gralco/dvk-mx8m-bsb/calculations/final/feedline_adjustment_description.png

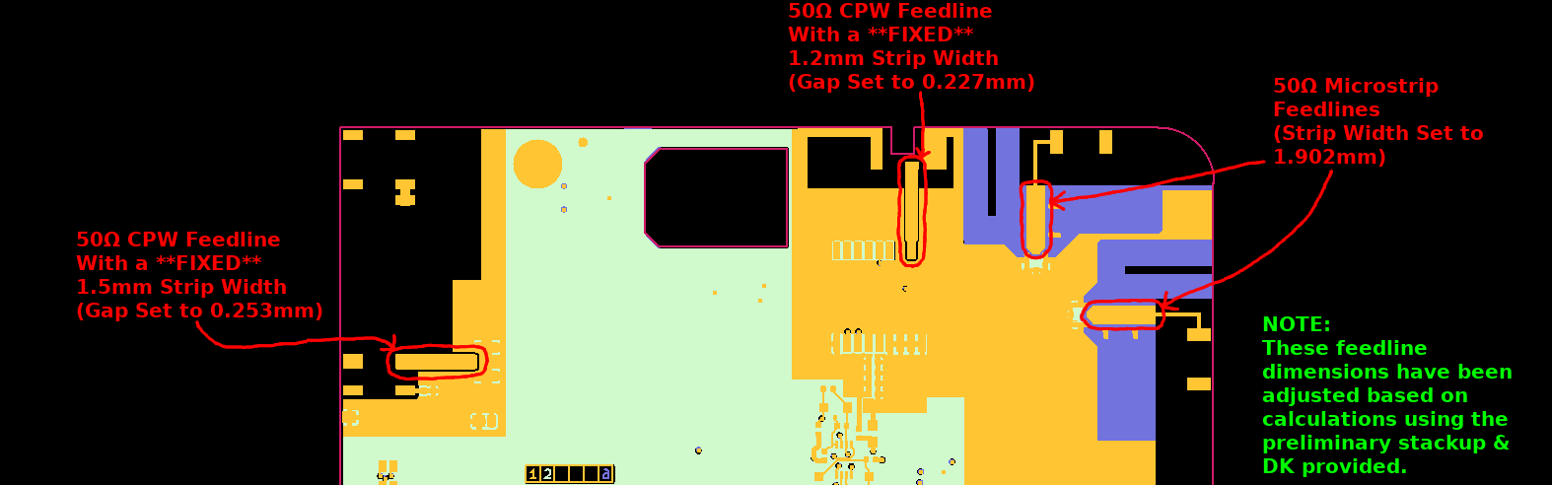
calculations/final/feedline_adjustment_description.png
