gralco/dvk-mx8m-bsb/calculations/final/final_stackup.png

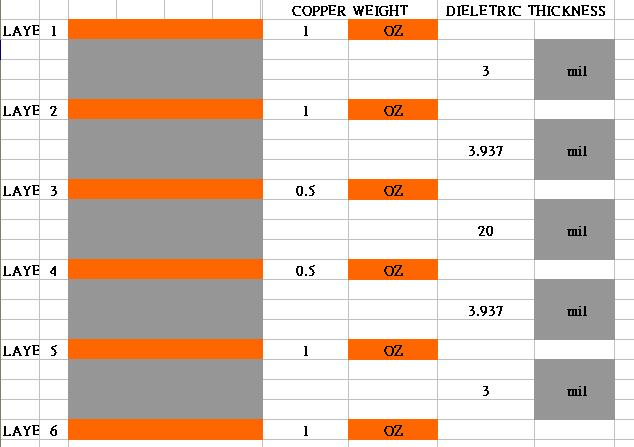
calculations/final/final_stackup.png
