gralco/dvk-mx8m-bsb/calculations/final/gnss_feed_beta_layout_polar_cpw.png

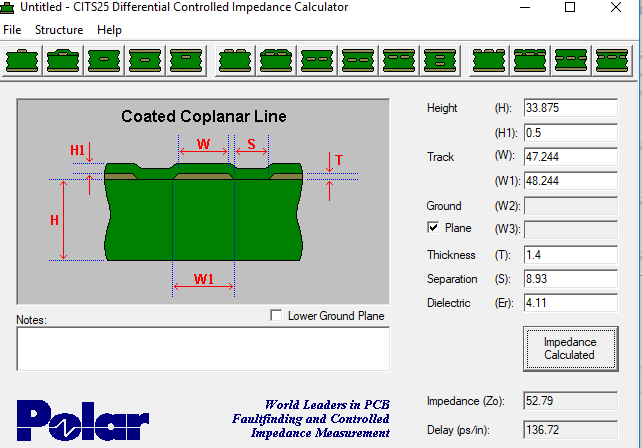
calculations/final/gnss_feed_beta_layout_polar_cpw.png
