gralco/dvk-mx8m-bsb/calculations/final/gnss_feed_janielectronics_cpw.png

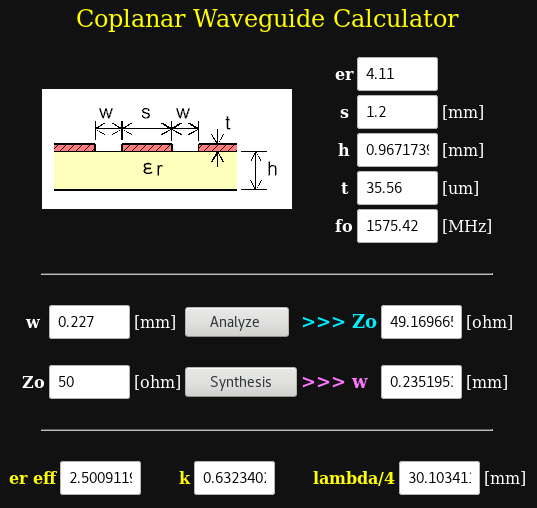
calculations/final/gnss_feed_janielectronics_cpw.png
