gralco/dvk-mx8m-bsb/calculations/final/speaker_trace_width.png

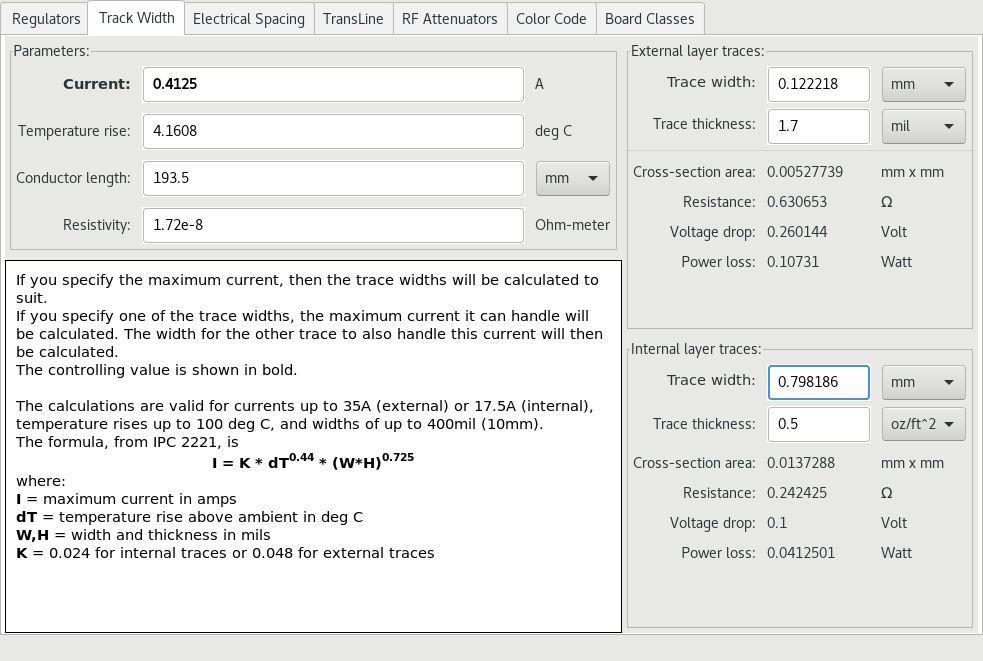
calculations/final/speaker_trace_width.png
