gralco/dvk-mx8m-bsb/calculations/final/wifi_bt_feed_kicad_microstrip.png

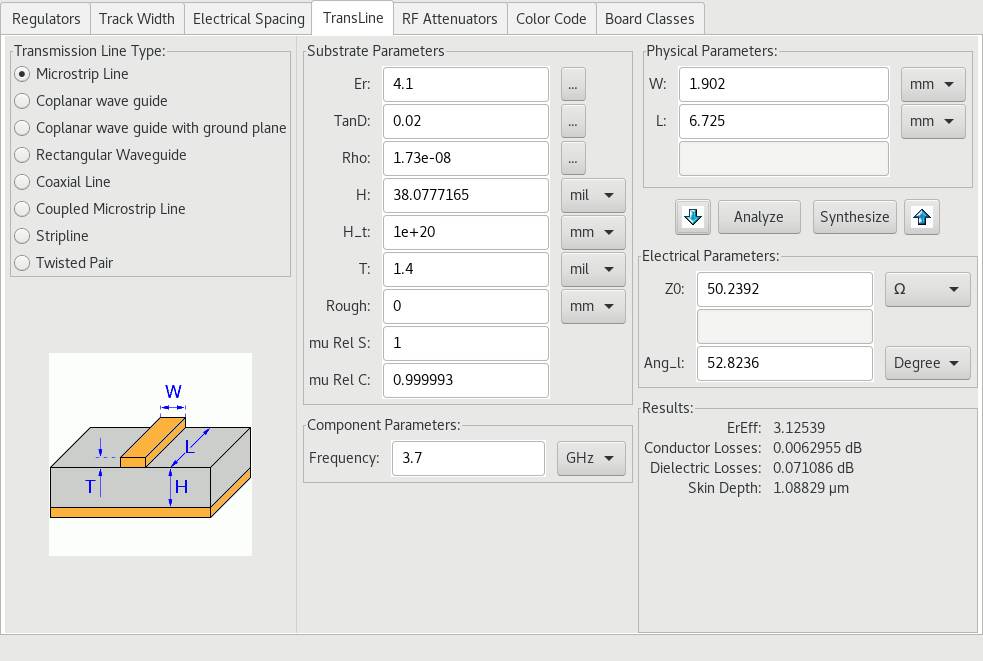
calculations/final/wifi_bt_feed_kicad_microstrip.png
