gralco/dvk-mx8m-bsb/calculations/final/wwan_feed_beta_layout_polar_cpw.png

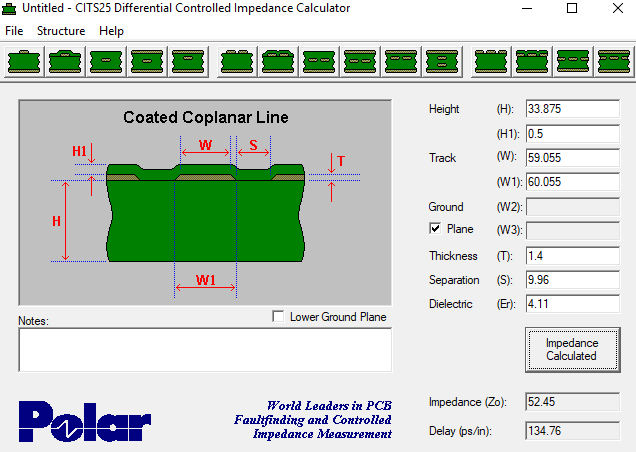
calculations/final/wwan_feed_beta_layout_polar_cpw.png
