gralco/dvk-mx8m-bsb/calculations/prototype/gnss_feed_janielectronics_cpw.png

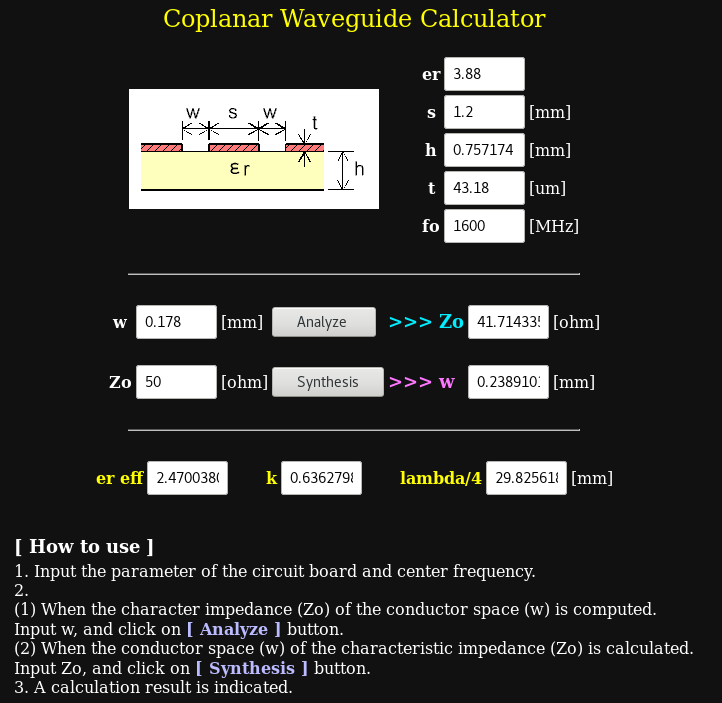
calculations/prototype/gnss_feed_janielectronics_cpw.png
