gralco/dvk-mx8m-bsb/calculations/prototype/wifi_bt_feed_janielectronics_microstrip.png

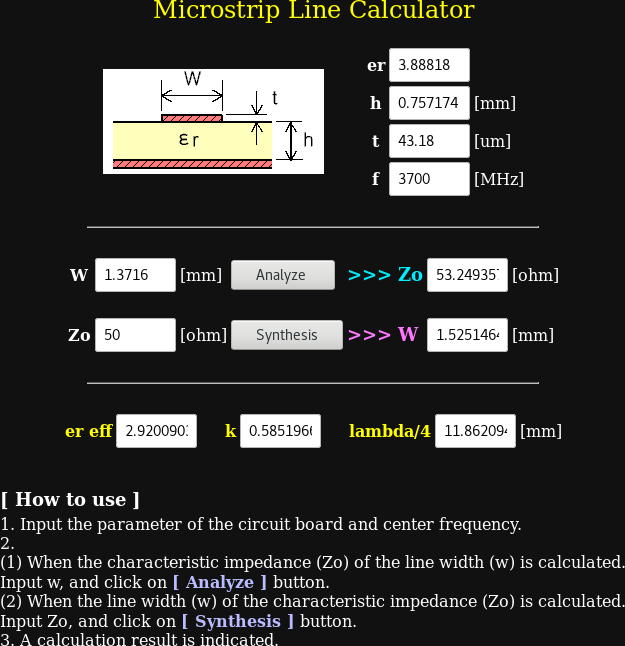
calculations/prototype/wifi_bt_feed_janielectronics_microstrip.png
