gralco/dvk-mx8m-bsb/BoM/dvk-mx8m-bsb_bom.csv

Reference | Value | Footprint | Datasheet | MFG Name | MFG Part Num | Distrib PN | Distrib Link | Tolerance | Others
AE2301 | ACM4-5036-A1-CC-S | dvk-mx8m-bsb:ACM4-5036-A1-CC-S | https://cloud.puri.sm/s/Xi64aJqKKKscxsZ | INPAQ | ACM4-5036-A1-CC-S | ACM4-5036-A1-CC-S | https://www.endrich.com/antennen_nfc_wpc/acm4_5036_a1_cc_s | - | https://www.everythingrf.com/products/gps-gnss-antennas/inpaq-technology-co-ltd/666-329-acm4-5036-a1-cc-s
AE1501 | SR4L034-R | dvk-mx8m-bsb:SR4L034-R | http://www.antenova-m2m.com/wp-content/uploads/2018/04/Inversa-SR4L034-PS-1.0.pdf | Antenova | SR4L034-R | SR4L034-R | https://www.arrow.com/en/products/sr4l034-r/antenova | - | https://octopart.com/search?q=SR4L034-R&start=0
AE1801 | FR05-S1-NO-1-004 | dvk-mx8m-bsb:FR05-S1-NO-1-004 | https://www.fractusantennas.com/files/UM_FR05_S1_NO_1_004.pdf
AE1802 | FR05-S1-NO-1-004 | dvk-mx8m-bsb:FR05-S1-NO-1-004 | https://www.fractusantennas.com/files/UM_FR05_S1_NO_1_004.pdf
BT301 | 18650 | dvk-mx8m-bsb:BH18650 | https://www.tme.eu/en/Document/8fa81c4c5d128169ded6af3ed3867ae3/BHC-18650-1P.pdf | COMF | BHC-18650-1P | BHC-18650-1P | https://www.tme.eu/en/details/bhc-18650-1p/batteries-holders/comf/ | - | http://www.sierraic.com/BHC186501P
C103 | 100nF | Capacitors_SMD:C_0402
C104 | 100nF | Capacitors_SMD:C_0402
C108 | 100nF | Capacitors_SMD:C_0402
C107 | 100nF | Capacitors_SMD:C_0402
C205 | 100nF | Capacitors_SMD:C_0402
C206 | 100nF | Capacitors_SMD:C_0402
C208 | 100nF | Capacitors_SMD:C_0402
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
C1808 | 1uF | Capacitors_SMD:C_0402
C1801 | 1uF | Capacitors_SMD:C_0402
C1820 | 1uF | Capacitors_SMD:C_0402
C1901 | 1uF | Capacitors_SMD:C_0402
C1902 | 1uF | Capacitors_SMD:C_0402
C2001 | 1uF | Capacitors_SMD:C_0402
C2202 | 1uF | Capacitors_SMD:C_0402
C2204 | 1uF | Capacitors_SMD:C_0402
C2203 | 1uF | Capacitors_SMD:C_0402
C2402 | 1uF | Capacitors_SMD:C_0402
C202 | 2.2uF | Capacitors_SMD:C_0402
C204 | 2.2uF | Capacitors_SMD:C_0402
C1718 | 2.2uF | Capacitors_SMD:C_0402
C2002 | 2.2uF | Capacitors_SMD:C_0402
C1711 | 220nF | Capacitors_SMD:C_0402
C1714 | 220nF | Capacitors_SMD:C_0402
C1716 | 220nF | Capacitors_SMD:C_0402
C1717 | 220nF | Capacitors_SMD:C_0402
C1706 | 220nF | Capacitors_SMD:C_0402
C1705 | 220nF | Capacitors_SMD:C_0402
C1707 | 220nF | Capacitors_SMD:C_0402
C1719 | 220nF | Capacitors_SMD:C_0402
C1720 | 220nF | Capacitors_SMD:C_0402
C1721 | 220nF | Capacitors_SMD:C_0402
C1616 | 220pF | Capacitors_SMD:C_0402
C1617 | 220pF | Capacitors_SMD:C_0402
C455 | 220uF | Capacitors_Tantalum_SMD:CP_Tantalum_Case-D_EIA-7343-31_Reflow | http://datasheets.avx.com/TPS.pdf | AVX | TPSD227K010R0100 | TPSD227K010R0100 | https://www.tme.eu/en/details/tpsd227k010r010/smd-tantalum-capacitors/avx/tpsd227k010r0100/ | 10% | https://www.arrow.com/en/products/293d227x9010d2te3/vishay
C454 | 220uF | Capacitors_Tantalum_SMD:CP_Tantalum_Case-D_EIA-7343-31_Reflow | http://datasheets.avx.com/TPS.pdf | AVX | TPSD227K010R0100 | TPSD227K010R0100 | https://www.tme.eu/en/details/tpsd227k010r010/smd-tantalum-capacitors/avx/tpsd227k010r0100/ | 10% | https://www.arrow.com/en/products/293d227x9010d2te3/vishay
C1505 | 220uF | Capacitors_Tantalum_SMD:CP_Tantalum_Case-D_EIA-7343-31_Reflow | http://datasheets.avx.com/TPS.pdf | AVX | TPSD227K010R0100 | TPSD227K010R0100 | https://www.tme.eu/en/details/tpsd227k010r010/smd-tantalum-capacitors/avx/tpsd227k010r0100/ | 10% | https://www.arrow.com/en/products/293d227x9010d2te3/vishay
C1503 | 220uF | Capacitors_Tantalum_SMD:CP_Tantalum_Case-D_EIA-7343-31_Reflow | http://datasheets.avx.com/TPS.pdf | AVX | TPSD227K010R0100 | TPSD227K010R0100 | https://www.tme.eu/en/details/tpsd227k010r010/smd-tantalum-capacitors/avx/tpsd227k010r0100/ | 10% | https://www.arrow.com/en/products/293d227x9010d2te3/vishay
C1502 | 220uF | Capacitors_Tantalum_SMD:CP_Tantalum_Case-D_EIA-7343-31_Reflow | http://datasheets.avx.com/TPS.pdf | AVX | TPSD227K010R0100 | TPSD227K010R0100 | https://www.tme.eu/en/details/tpsd227k010r010/smd-tantalum-capacitors/avx/tpsd227k010r0100/ | 10% | https://www.arrow.com/en/products/293d227x9010d2te3/vishay
C1609 | 220uF | Capacitors_Tantalum_SMD:CP_Tantalum_Case-S_EIA-3216-12_Reflow | http://datasheets.avx.com/TLN_Undertab.pdf | AVX | TLNS227M004R3000 | 478-5526-1-ND | https://www.digikey.com/product-detail/en/avx-corporation/TLNS227M004R3000/478-5526-1-ND/2048317 | 20% | https://www.digikey.com/products/en/capacitors/tantalum-capacitors/59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
C1610 | 220uF | Capacitors_Tantalum_SMD:CP_Tantalum_Case-S_EIA-3216-12_Reflow | http://datasheets.avx.com/TLN_Undertab.pdf | AVX | TLNS227M004R3000 | 478-5526-1-ND | https://www.digikey.com/product-detail/en/avx-corporation/TLNS227M004R3000/478-5526-1-ND/2048317 | 20% | https://www.digikey.com/products/en/capacitors/tantalum-capacitors/59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
C1821 | 220uF | Capacitors_Tantalum_SMD:CP_Tantalum_Case-D_EIA-7343-31_Reflow | http://datasheets.avx.com/TPS.pdf | AVX | TPSD227K010R0100 | TPSD227K010R0100 | https://www.tme.eu/en/details/tpsd227k010r010/smd-tantalum-capacitors/avx/tpsd227k010r0100/ | 10% | https://www.arrow.com/en/products/293d227x9010d2te3/vishay
C1822 | 220uF | Capacitors_Tantalum_SMD:CP_Tantalum_Case-D_EIA-7343-31_Reflow | http://datasheets.avx.com/TPS.pdf | AVX | TPSD227K010R0100 | TPSD227K010R0100 | https://www.tme.eu/en/details/tpsd227k010r010/smd-tantalum-capacitors/avx/tpsd227k010r0100/ | 10% | https://www.arrow.com/en/products/293d227x9010d2te3/vishay
C1701 | 27pF | Capacitors_SMD:C_0402
C1702 | 27pF | Capacitors_SMD:C_0402
C1522 | 22pF | Capacitors_SMD:C_0402
C101 | 22uF | Capacitors_SMD:C_0603 | http://www.samsungsem.com/kr/support/product-search/mlcc/__icsFiles/afieldfile/2018/06/21/CL10A226MP8NUNE.pdf | Samsung | CL10A226MP8NUNE | C86295 | https://lcsc.com/product-detail/Multilayer-Ceramic-Capacitors-MLCC-SMD-SMT_SAMSUNG_CL10A226MP8NUNE_22uF-226-20-10V_C86295.html | 20% | https://lcsc.com/product-detail/Multilayer-Ceramic-Capacitors-MLCC-SMD-SMT_MuRata_ZRB18AR61A226ME01L_22uF-226-20-10V_C162690.html
C102 | 22uF | Capacitors_SMD:C_0603 | http://www.samsungsem.com/kr/support/product-search/mlcc/__icsFiles/afieldfile/2018/06/21/CL10A226MP8NUNE.pdf | Samsung | CL10A226MP8NUNE | C86295 | https://lcsc.com/product-detail/Multilayer-Ceramic-Capacitors-MLCC-SMD-SMT_SAMSUNG_CL10A226MP8NUNE_22uF-226-20-10V_C86295.html | 20% | https://lcsc.com/product-detail/Multilayer-Ceramic-Capacitors-MLCC-SMD-SMT_MuRata_ZRB18AR61A226ME01L_22uF-226-20-10V_C162690.html
C105 | 22uF | Capacitors_SMD:C_0603 | http://www.samsungsem.com/kr/support/product-search/mlcc/__icsFiles/afieldfile/2018/06/21/CL10A226MP8NUNE.pdf | Samsung | CL10A226MP8NUNE | C86295 | https://lcsc.com/product-detail/Multilayer-Ceramic-Capacitors-MLCC-SMD-SMT_SAMSUNG_CL10A226MP8NUNE_22uF-226-20-10V_C86295.html | 20% | https://lcsc.com/product-detail/Multilayer-Ceramic-Capacitors-MLCC-SMD-SMT_MuRata_ZRB18AR61A226ME01L_22uF-226-20-10V_C162690.html
C106 | 22uF | Capacitors_SMD:C_0603 | http://www.samsungsem.com/kr/support/product-search/mlcc/__icsFiles/afieldfile/2018/06/21/CL10A226MP8NUNE.pdf | Samsung | CL10A226MP8NUNE | C86295 | https://lcsc.com/product-detail/Multilayer-Ceramic-Capacitors-MLCC-SMD-SMT_SAMSUNG_CL10A226MP8NUNE_22uF-226-20-10V_C86295.html | 20% | https://lcsc.com/product-detail/Multilayer-Ceramic-Capacitors-MLCC-SMD-SMT_MuRata_ZRB18AR61A226ME01L_22uF-226-20-10V_C162690.html
C310 | 22uF | Capacitors_SMD:C_0603 | http://www.samsungsem.com/kr/support/product-search/mlcc/__icsFiles/afieldfile/2018/06/21/CL10A226MP8NUNE.pdf | Samsung | CL10A226MP8NUNE | C86295 | https://lcsc.com/product-detail/Multilayer-Ceramic-Capacitors-MLCC-SMD-SMT_SAMSUNG_CL10A226MP8NUNE_22uF-226-20-10V_C86295.html | 20% | https://lcsc.com/product-detail/Multilayer-Ceramic-Capacitors-MLCC-SMD-SMT_MuRata_ZRB18AR61A226ME01L_22uF-226-20-10V_C162690.html
C311 | 22uF | Capacitors_SMD:C_0603 | http://www.samsungsem.com/kr/support/product-search/mlcc/__icsFiles/afieldfile/2018/06/21/CL10A226MP8NUNE.pdf | Samsung | CL10A226MP8NUNE | C86295 | https://lcsc.com/product-detail/Multilayer-Ceramic-Capacitors-MLCC-SMD-SMT_SAMSUNG_CL10A226MP8NUNE_22uF-226-20-10V_C86295.html | 20% | https://lcsc.com/product-detail/Multilayer-Ceramic-Capacitors-MLCC-SMD-SMT_MuRata_ZRB18AR61A226ME01L_22uF-226-20-10V_C162690.html
C312 | 22uF | Capacitors_SMD:C_0603 | http://www.samsungsem.com/kr/support/product-search/mlcc/__icsFiles/afieldfile/2018/06/21/CL10A226MP8NUNE.pdf | Samsung | CL10A226MP8NUNE | C86295 | https://lcsc.com/product-detail/Multilayer-Ceramic-Capacitors-MLCC-SMD-SMT_SAMSUNG_CL10A226MP8NUNE_22uF-226-20-10V_C86295.html | 20% | https://lcsc.com/product-detail/Multilayer-Ceramic-Capacitors-MLCC-SMD-SMT_MuRata_ZRB18AR61A226ME01L_22uF-226-20-10V_C162690.html
C313 | 22uF | Capacitors_SMD:C_0603 | http://www.samsungsem.com/kr/support/product-search/mlcc/__icsFiles/afieldfile/2018/06/21/CL10A226MP8NUNE.pdf | Samsung | CL10A226MP8NUNE | C86295 | https://lcsc.com/product-detail/Multilayer-Ceramic-Capacitors-MLCC-SMD-SMT_SAMSUNG_CL10A226MP8NUNE_22uF-226-20-10V_C86295.html | 20% | https://lcsc.com/product-detail/Multilayer-Ceramic-Capacitors-MLCC-SMD-SMT_MuRata_ZRB18AR61A226ME01L_22uF-226-20-10V_C162690.html
C314 | 22uF | Capacitors_SMD:C_0603 | http://www.samsungsem.com/kr/support/product-search/mlcc/__icsFiles/afieldfile/2018/06/21/CL10A226MP8NUNE.pdf | Samsung | CL10A226MP8NUNE | C86295 | https://lcsc.com/product-detail/Multilayer-Ceramic-Capacitors-MLCC-SMD-SMT_SAMSUNG_CL10A226MP8NUNE_22uF-226-20-10V_C86295.html | 20% | https://lcsc.com/product-detail/Multilayer-Ceramic-Capacitors-MLCC-SMD-SMT_MuRata_ZRB18AR61A226ME01L_22uF-226-20-10V_C162690.html
C460 | 22uF | Capacitors_SMD:C_0603 | http://www.samsungsem.com/kr/support/product-search/mlcc/__icsFiles/afieldfile/2018/06/21/CL10A226MP8NUNE.pdf | Samsung | CL10A226MP8NUNE | C86295 | https://lcsc.com/product-detail/Multilayer-Ceramic-Capacitors-MLCC-SMD-SMT_SAMSUNG_CL10A226MP8NUNE_22uF-226-20-10V_C86295.html | 20% | https://lcsc.com/product-detail/Multilayer-Ceramic-Capacitors-MLCC-SMD-SMT_MuRata_ZRB18AR61A226ME01L_22uF-226-20-10V_C162690.html
C441 | 22uF | Capacitors_SMD:C_0603 | http://www.samsungsem.com/kr/support/product-search/mlcc/__icsFiles/afieldfile/2018/06/21/CL10A226MP8NUNE.pdf | Samsung | CL10A226MP8NUNE | C86295 | https://lcsc.com/product-detail/Multilayer-Ceramic-Capacitors-MLCC-SMD-SMT_SAMSUNG_CL10A226MP8NUNE_22uF-226-20-10V_C86295.html | 20% | https://lcsc.com/product-detail/Multilayer-Ceramic-Capacitors-MLCC-SMD-SMT_MuRata_ZRB18AR61A226ME01L_22uF-226-20-10V_C162690.html
C442 | 22uF | Capacitors_SMD:C_0603 | http://www.samsungsem.com/kr/support/product-search/mlcc/__icsFiles/afieldfile/2018/06/21/CL10A226MP8NUNE.pdf | Samsung | CL10A226MP8NUNE | C86295 | https://lcsc.com/product-detail/Multilayer-Ceramic-Capacitors-MLCC-SMD-SMT_SAMSUNG_CL10A226MP8NUNE_22uF-226-20-10V_C86295.html | 20% | https://lcsc.com/product-detail/Multilayer-Ceramic-Capacitors-MLCC-SMD-SMT_MuRata_ZRB18AR61A226ME01L_22uF-226-20-10V_C162690.html
C444 | 22uF | Capacitors_SMD:C_0603 | http://www.samsungsem.com/kr/support/product-search/mlcc/__icsFiles/afieldfile/2018/06/21/CL10A226MP8NUNE.pdf | Samsung | CL10A226MP8NUNE | C86295 | https://lcsc.com/product-detail/Multilayer-Ceramic-Capacitors-MLCC-SMD-SMT_SAMSUNG_CL10A226MP8NUNE_22uF-226-20-10V_C86295.html | 20% | https://lcsc.com/product-detail/Multilayer-Ceramic-Capacitors-MLCC-SMD-SMT_MuRata_ZRB18AR61A226ME01L_22uF-226-20-10V_C162690.html
C448 | 22uF | Capacitors_SMD:C_0603 | http://www.samsungsem.com/kr/support/product-search/mlcc/__icsFiles/afieldfile/2018/06/21/CL10A226MP8NUNE.pdf | Samsung | CL10A226MP8NUNE | C86295 | https://lcsc.com/product-detail/Multilayer-Ceramic-Capacitors-MLCC-SMD-SMT_SAMSUNG_CL10A226MP8NUNE_22uF-226-20-10V_C86295.html | 20% | https://lcsc.com/product-detail/Multilayer-Ceramic-Capacitors-MLCC-SMD-SMT_MuRata_ZRB18AR61A226ME01L_22uF-226-20-10V_C162690.html
C437 | 22uF | Capacitors_SMD:C_0603 | http://www.samsungsem.com/kr/support/product-search/mlcc/__icsFiles/afieldfile/2018/06/21/CL10A226MP8NUNE.pdf | Samsung | CL10A226MP8NUNE | C86295 | https://lcsc.com/product-detail/Multilayer-Ceramic-Capacitors-MLCC-SMD-SMT_SAMSUNG_CL10A226MP8NUNE_22uF-226-20-10V_C86295.html | 20% | https://lcsc.com/product-detail/Multilayer-Ceramic-Capacitors-MLCC-SMD-SMT_MuRata_ZRB18AR61A226ME01L_22uF-226-20-10V_C162690.html
C439 | 22uF | Capacitors_SMD:C_0603 | http://www.samsungsem.com/kr/support/product-search/mlcc/__icsFiles/afieldfile/2018/06/21/CL10A226MP8NUNE.pdf | Samsung | CL10A226MP8NUNE | C86295 | https://lcsc.com/product-detail/Multilayer-Ceramic-Capacitors-MLCC-SMD-SMT_SAMSUNG_CL10A226MP8NUNE_22uF-226-20-10V_C86295.html | 20% | https://lcsc.com/product-detail/Multilayer-Ceramic-Capacitors-MLCC-SMD-SMT_MuRata_ZRB18AR61A226ME01L_22uF-226-20-10V_C162690.html
C445 | 22uF | Capacitors_SMD:C_0603 | http://www.samsungsem.com/kr/support/product-search/mlcc/__icsFiles/afieldfile/2018/06/21/CL10A226MP8NUNE.pdf | Samsung | CL10A226MP8NUNE | C86295 | https://lcsc.com/product-detail/Multilayer-Ceramic-Capacitors-MLCC-SMD-SMT_SAMSUNG_CL10A226MP8NUNE_22uF-226-20-10V_C86295.html | 20% | https://lcsc.com/product-detail/Multilayer-Ceramic-Capacitors-MLCC-SMD-SMT_MuRata_ZRB18AR61A226ME01L_22uF-226-20-10V_C162690.html
C446 | 22uF | Capacitors_SMD:C_0603 | http://www.samsungsem.com/kr/support/product-search/mlcc/__icsFiles/afieldfile/2018/06/21/CL10A226MP8NUNE.pdf | Samsung | CL10A226MP8NUNE | C86295 | https://lcsc.com/product-detail/Multilayer-Ceramic-Capacitors-MLCC-SMD-SMT_SAMSUNG_CL10A226MP8NUNE_22uF-226-20-10V_C86295.html | 20% | https://lcsc.com/product-detail/Multilayer-Ceramic-Capacitors-MLCC-SMD-SMT_MuRata_ZRB18AR61A226ME01L_22uF-226-20-10V_C162690.html
C1002 | 22uF | Capacitors_SMD:C_0603 | http://www.samsungsem.com/kr/support/product-search/mlcc/__icsFiles/afieldfile/2018/06/21/CL10A226MP8NUNE.pdf | Samsung | CL10A226MP8NUNE | C86295 | https://lcsc.com/product-detail/Multilayer-Ceramic-Capacitors-MLCC-SMD-SMT_SAMSUNG_CL10A226MP8NUNE_22uF-226-20-10V_C86295.html | 20% | https://lcsc.com/product-detail/Multilayer-Ceramic-Capacitors-MLCC-SMD-SMT_MuRata_ZRB18AR61A226ME01L_22uF-226-20-10V_C162690.html
C1003 | 22uF | Capacitors_SMD:C_0603 | http://www.samsungsem.com/kr/support/product-search/mlcc/__icsFiles/afieldfile/2018/06/21/CL10A226MP8NUNE.pdf | Samsung | CL10A226MP8NUNE | C86295 | https://lcsc.com/product-detail/Multilayer-Ceramic-Capacitors-MLCC-SMD-SMT_SAMSUNG_CL10A226MP8NUNE_22uF-226-20-10V_C86295.html | 20% | https://lcsc.com/product-detail/Multilayer-Ceramic-Capacitors-MLCC-SMD-SMT_MuRata_ZRB18AR61A226ME01L_22uF-226-20-10V_C162690.html
C1903 | 22uF | Capacitors_SMD:C_0603 | http://www.samsungsem.com/kr/support/product-search/mlcc/__icsFiles/afieldfile/2018/06/21/CL10A226MP8NUNE.pdf | Samsung | CL10A226MP8NUNE | C86295 | https://lcsc.com/product-detail/Multilayer-Ceramic-Capacitors-MLCC-SMD-SMT_SAMSUNG_CL10A226MP8NUNE_22uF-226-20-10V_C86295.html | 20% | https://lcsc.com/product-detail/Multilayer-Ceramic-Capacitors-MLCC-SMD-SMT_MuRata_ZRB18AR61A226ME01L_22uF-226-20-10V_C162690.html
C1624 | 270pF | Capacitors_SMD:C_0402
C1621 | 270pF | Capacitors_SMD:C_0402
C1622 | 270pF | Capacitors_SMD:C_0402
C1516 | 33pF | Capacitors_SMD:C_0402
C1509 | 33pF | Capacitors_SMD:C_0402
C1816 | 33pF | Capacitors_SMD:C_0402
C1508 | 39pF | Capacitors_SMD:C_0402
C1817 | 39pF | Capacitors_SMD:C_0402
C203 | 4.7uF | Capacitors_SMD:C_0603
C304 | 4.7uF | Capacitors_SMD:C_0603
C412 | 4.7uF | Capacitors_SMD:C_0603 | http://ds.yuden.co.jp/TYCOMPAS/ut/detail.do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 | Taiyo Yuden | LMK107BJ475KA-T | 587-1441-1-ND | https://www.digikey.com/product-detail/en/taiyo-yuden/LMK107BJ475KA-T/587-1441-1-ND/1004072 | - | https://www.digikey.com/products/en/capacitors/ceramic-capacitors/60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
C458 | 4.7uF | Capacitors_SMD:C_0603 | http://ds.yuden.co.jp/TYCOMPAS/ut/detail.do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 | Taiyo Yuden | LMK107BJ475KA-T | 587-1441-1-ND | https://www.digikey.com/product-detail/en/taiyo-yuden/LMK107BJ475KA-T/587-1441-1-ND/1004072 | - | https://www.digikey.com/products/en/capacitors/ceramic-capacitors/60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
C461 | 4.7uF | Capacitors_SMD:C_0603
C901 | 4.7uF | Capacitors_SMD:C_0603
C1309 | 4.7uF | Capacitors_SMD:C_0603
C1303 | 4.7uF | Capacitors_SMD:C_0603
C303 | 47nF | Capacitors_SMD:C_0402
C427 | 560pF | Capacitors_SMD:C_0402
C1512 | 6.8pF | Capacitors_SMD:C_0402
C1813 | 6.8pF | Capacitors_SMD:C_0402
C1511 | 8.2pF | Capacitors_SMD:C_0402
C1814 | 8.2pF | Capacitors_SMD:C_0402
C216 | NC | Capacitors_SMD:C_0402
C1001 | NC | Capacitors_SMD:C_0402
C1501 | NC | Capacitors_SMD:C_0402
C1504 | NC | Capacitors_SMD:C_0402
C1526 | NC | Capacitors_SMD:C_0402
C1521 | NC | Capacitors_SMD:C_0402
C1520 | NC | Capacitors_SMD:C_0402
C1606 | NC | Capacitors_SMD:C_0402
C1608 | NC | Capacitors_SMD:C_0402
C1709 | NC | Capacitors_SMD:C_0402
C1712 | NC | Capacitors_SMD:C_0402
C1715 | NC | Capacitors_SMD:C_0402
C1802 | NC | Capacitors_SMD:C_0402
C1803 | NC | Capacitors_SMD:C_0402
C1805 | NC | Capacitors_SMD:C_0402
C1806 | NC | Capacitors_SMD:C_0402
C1905 | NC | Capacitors_SMD:C_0402
C2305 | NC | Capacitors_SMD:C_0402
C2306 | NC | Capacitors_SMD:C_0402
C2307 | NC | Capacitors_SMD:C_0402
CBL1501 | Coax_cable_ufl_ufl | dvk-mx8m-bsb:Coax_Cable_Straight_5cm
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
D2401 | DB2J209 | dvk-mx8m-bsb:SMini2-F5-B | https://industrial.panasonic.com/content/data/SC/ds/ds4/DB2J20900L_E.pdf | Panasonic | DB2J20900L | 667-DB2J20900L | https://www.mouser.com/ProductDetail/Panasonic/DB2J20900L | - | https://www.digikey.com/products/en/discrete-semiconductor-products/diodes-rectifiers-single/280
DISP1201 | Display_JH057N00900 | dvk-mx8m-bsb:JH057N00900
D202 | ESD5B5.0 | dvk-mx8m-bsb:SOD-523_Case-502 | http://www.onsemi.com/pub/Collateral/ESD5B5.0ST1-D.PDF | ON Semiconductor | ESD5B5.0ST1G | 10N9401 | http://www.newark.com/on-semiconductor/esd5b5-0st1g/tvs-diode-50w-5v-sod-523/dp/10N9401?st=ESD5B5.0ST1G | - | https://octopart.com/search?q=ESD5B5.0ST1G&start=0
D204 | ESD5B5.0 | dvk-mx8m-bsb:SOD-523_Case-502 | http://www.onsemi.com/pub/Collateral/ESD5B5.0ST1-D.PDF | ON Semiconductor | ESD5B5.0ST1G | 10N9401 | http://www.newark.com/on-semiconductor/esd5b5-0st1g/tvs-diode-50w-5v-sod-523/dp/10N9401?st=ESD5B5.0ST1G | - | https://octopart.com/search?q=ESD5B5.0ST1G&start=0
D501 | ESD5B5.0 | dvk-mx8m-bsb:SOD-523_Case-502 | http://www.onsemi.com/pub/Collateral/ESD5B5.0ST1-D.PDF | ON Semiconductor | ESD5B5.0ST1G | 10N9401 | http://www.newark.com/on-semiconductor/esd5b5-0st1g/tvs-diode-50w-5v-sod-523/dp/10N9401?st=ESD5B5.0ST1G | - | https://octopart.com/search?q=ESD5B5.0ST1G&start=0
D502 | ESD5B5.0 | dvk-mx8m-bsb:SOD-523_Case-502 | http://www.onsemi.com/pub/Collateral/ESD5B5.0ST1-D.PDF | ON Semiconductor | ESD5B5.0ST1G | 10N9401 | http://www.newark.com/on-semiconductor/esd5b5-0st1g/tvs-diode-50w-5v-sod-523/dp/10N9401?st=ESD5B5.0ST1G | - | https://octopart.com/search?q=ESD5B5.0ST1G&start=0
D1401 | ESD5B5.0 | dvk-mx8m-bsb:SOD-523_Case-502 | http://www.onsemi.com/pub/Collateral/ESD5B5.0ST1-D.PDF | ON Semiconductor | ESD5B5.0ST1G | 10N9401 | http://www.newark.com/on-semiconductor/esd5b5-0st1g/tvs-diode-50w-5v-sod-523/dp/10N9401?st=ESD5B5.0ST1G | - | https://octopart.com/search?q=ESD5B5.0ST1G&start=0
D1402 | ESD5B5.0 | dvk-mx8m-bsb:SOD-523_Case-502 | http://www.onsemi.com/pub/Collateral/ESD5B5.0ST1-D.PDF | ON Semiconductor | ESD5B5.0ST1G | 10N9401 | http://www.newark.com/on-semiconductor/esd5b5-0st1g/tvs-diode-50w-5v-sod-523/dp/10N9401?st=ESD5B5.0ST1G | - | https://octopart.com/search?q=ESD5B5.0ST1G&start=0
D1403 | ESD5B5.0 | dvk-mx8m-bsb:SOD-523_Case-502 | http://www.onsemi.com/pub/Collateral/ESD5B5.0ST1-D.PDF | ON Semiconductor | ESD5B5.0ST1G | 10N9401 | http://www.newark.com/on-semiconductor/esd5b5-0st1g/tvs-diode-50w-5v-sod-523/dp/10N9401?st=ESD5B5.0ST1G | - | https://octopart.com/search?q=ESD5B5.0ST1G&start=0
D1404 | ESD5B5.0 | dvk-mx8m-bsb:SOD-523_Case-502 | http://www.onsemi.com/pub/Collateral/ESD5B5.0ST1-D.PDF | ON Semiconductor | ESD5B5.0ST1G | 10N9401 | http://www.newark.com/on-semiconductor/esd5b5-0st1g/tvs-diode-50w-5v-sod-523/dp/10N9401?st=ESD5B5.0ST1G | - | https://octopart.com/search?q=ESD5B5.0ST1G&start=0
D1501 | ESD5B5.0 | dvk-mx8m-bsb:SOD-523_Case-502 | http://www.onsemi.com/pub/Collateral/ESD5B5.0ST1-D.PDF | ON Semiconductor | ESD5B5.0ST1G | 10N9401 | http://www.newark.com/on-semiconductor/esd5b5-0st1g/tvs-diode-50w-5v-sod-523/dp/10N9401?st=ESD5B5.0ST1G | - | https://octopart.com/search?q=ESD5B5.0ST1G&start=0
D1601 | ESD5B5.0 | dvk-mx8m-bsb:SOD-523_Case-502 | http://www.onsemi.com/pub/Collateral/ESD5B5.0ST1-D.PDF | ON Semiconductor | ESD5B5.0ST1G | 10N9401 | http://www.newark.com/on-semiconductor/esd5b5-0st1g/tvs-diode-50w-5v-sod-523/dp/10N9401?st=ESD5B5.0ST1G | - | https://octopart.com/search?q=ESD5B5.0ST1G&start=0
D1602 | ESD5B5.0 | dvk-mx8m-bsb:SOD-523_Case-502 | http://www.onsemi.com/pub/Collateral/ESD5B5.0ST1-D.PDF | ON Semiconductor | ESD5B5.0ST1G | 10N9401 | http://www.newark.com/on-semiconductor/esd5b5-0st1g/tvs-diode-50w-5v-sod-523/dp/10N9401?st=ESD5B5.0ST1G | - | https://octopart.com/search?q=ESD5B5.0ST1G&start=0
D1902 | ESD5B5.0 | dvk-mx8m-bsb:SOD-523_Case-502 | http://www.onsemi.com/pub/Collateral/ESD5B5.0ST1-D.PDF | ON Semiconductor | ESD5B5.0ST1G | 10N9401 | http://www.newark.com/on-semiconductor/esd5b5-0st1g/tvs-diode-50w-5v-sod-523/dp/10N9401?st=ESD5B5.0ST1G | - | https://octopart.com/search?q=ESD5B5.0ST1G&start=0
D1903 | ESD5B5.0 | dvk-mx8m-bsb:SOD-523_Case-502 | http://www.onsemi.com/pub/Collateral/ESD5B5.0ST1-D.PDF | ON Semiconductor | ESD5B5.0ST1G | 10N9401 | http://www.newark.com/on-semiconductor/esd5b5-0st1g/tvs-diode-50w-5v-sod-523/dp/10N9401?st=ESD5B5.0ST1G | - | https://octopart.com/search?q=ESD5B5.0ST1G&start=0
D1904 | ESD5B5.0 | dvk-mx8m-bsb:SOD-523_Case-502 | http://www.onsemi.com/pub/Collateral/ESD5B5.0ST1-D.PDF | ON Semiconductor | ESD5B5.0ST1G | 10N9401 | http://www.newark.com/on-semiconductor/esd5b5-0st1g/tvs-diode-50w-5v-sod-523/dp/10N9401?st=ESD5B5.0ST1G | - | https://octopart.com/search?q=ESD5B5.0ST1G&start=0
D1906 | ESD5B5.0 | dvk-mx8m-bsb:SOD-523_Case-502 | http://www.onsemi.com/pub/Collateral/ESD5B5.0ST1-D.PDF | ON Semiconductor | ESD5B5.0ST1G | 10N9401 | http://www.newark.com/on-semiconductor/esd5b5-0st1g/tvs-diode-50w-5v-sod-523/dp/10N9401?st=ESD5B5.0ST1G | - | https://octopart.com/search?q=ESD5B5.0ST1G&start=0
D303 | ESD9X5.0 | dvk-mx8m-bsb:SOD-923 | http://www.onsemi.com/pub/Collateral/ESD9X3.3ST5G-D.PDF | ON Semi | ESD9X5.0ST5G | ESD9X5.0ST5G | https://www.arrow.com/en/products/esd9x5.0st5g/on-semiconductor | - | https://octopart.com/search?q=ESD9X5.0ST5G&start=0
D301 | GREEN | dvk-mx8m-bsb:LTST-C190GKT | https://media.digikey.com/pdf/Data%20Sheets/Lite-On%20PDFs/LTST-C190GKT.pdf | Lite-On | LTST-C190GKT | LTST-C190GKT | https://www.arrow.com/en/products/ltst-c190gkt/lite-on-technology | - | https://octopart.com/search?q=LTST-C190GKT&start=0
D302 | GREEN | dvk-mx8m-bsb:LTST-C190GKT | https://media.digikey.com/pdf/Data%20Sheets/Lite-On%20PDFs/LTST-C190GKT.pdf | Lite-On | LTST-C190GKT | LTST-C190GKT | https://www.arrow.com/en/products/ltst-c190gkt/lite-on-technology | - | https://octopart.com/search?q=LTST-C190GKT&start=0
D304 | GREEN | dvk-mx8m-bsb:LTST-C190GKT | https://media.digikey.com/pdf/Data%20Sheets/Lite-On%20PDFs/LTST-C190GKT.pdf | Lite-On | LTST-C190GKT | LTST-C190GKT | https://www.arrow.com/en/products/ltst-c190gkt/lite-on-technology | - | https://octopart.com/search?q=LTST-C190GKT&start=0
D1702 | GREEN | dvk-mx8m-bsb:LTST-C190GKT | https://media.digikey.com/pdf/Data%20Sheets/Lite-On%20PDFs/LTST-C190GKT.pdf | Lite-On | LTST-C190GKT | LTST-C190GKT | https://www.arrow.com/en/products/ltst-c190gkt/lite-on-technology | - | https://octopart.com/search?q=LTST-C190GKT&start=0
D1603 | MMSZ4688 | dvk-mx8m-bsb:MMSZ4688 | https://www.vishay.com/docs/85773/mmsz4681.pdf | Vishay | MMSZ4688-E3-08 | 78-MMSZ4688-E3-08 | https://www.mouser.com/ProductDetail/Vishay-Semiconductors/MMSZ4688-E3-08 | - | http://www.digipart.com/part/MMSZ4688-E3-08
D205 | NC | dvk-mx8m-bsb:SOD-523_Case-502 | http://www.onsemi.com/pub/Collateral/ESD5B5.0ST1-D.PDF | ON Semiconductor | ESD5B5.0ST1G | 10N9401 | http://www.newark.com/on-semiconductor/esd5b5-0st1g/tvs-diode-50w-5v-sod-523/dp/10N9401?st=ESD5B5.0ST1G | - | https://octopart.com/search?q=ESD5B5.0ST1G&start=0
D206 | NC | dvk-mx8m-bsb:SOD-523_Case-502 | http://www.onsemi.com/pub/Collateral/ESD5B5.0ST1-D.PDF | ON Semiconductor | ESD5B5.0ST1G | 10N9401 | http://www.newark.com/on-semiconductor/esd5b5-0st1g/tvs-diode-50w-5v-sod-523/dp/10N9401?st=ESD5B5.0ST1G | - | https://octopart.com/search?q=ESD5B5.0ST1G&start=0
D203 | PTVS20VS1UTR | dvk-mx8m-bsb:D_SOD-123W | https://assets.nexperia.com/documents/data-sheet/PTVSXS1UTR_SER.pdf | NXP | PTVS20VS1UTR | 771-PTVS20VS1UTR115 | https://www.mouser.com/ProductDetail/Nexperia/PTVS20VS1UTR115?qs=A1cBxND5mHIgfNF%2Fe%2Fq%2F7g%3D%3D | - | https://octopart.com/search?q=PTVS20VS1U&start=0
D1405 | RED | dvk-mx8m-bsb:LTST-C171KRKT | http://optoelectronics.liteon.com/upload/download/DS22-2000-109/LTST-C171KRKT.pdf | Lite-On | LTST-C171KRKT | LTST-C171KRKT | https://www.arrow.com/en/products/ltst-c171krkt/lite-on-technology | - | https://octopart.com/search?q=LTST-C171KRKT&start=0
D401 | SS14 | dvk-mx8m-bsb:DO-214AC | https://www.fairchildsemi.com/datasheets/SS/SS12.pdf | ON Semiconductor | SS14 | SS14CT-ND | https://www.digikey.com/product-detail/en/on-semiconductor/SS14/SS14CT-ND/965729 | - | https://octopart.com/search?q=SS14&start=0
FB1606 | BLM18KG601SZ1D | dvk-mx8m-bsb:FER-0603 | https://www.murata.com/en-us/products/productdata/8796750610462/QNFA9122.pdf | Murata | BLM18KG601SZ1D | 490-14398-1-ND | https://www.digikey.com/product-detail/en/murata-electronics-north-america/BLM18KG601SZ1D/490-14398-1-ND/6606859 | 25% | https://www.digikey.com/products/en/filters/ferrite-beads-and-chips/841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
FB1607 | BLM18KG601SZ1D | dvk-mx8m-bsb:FER-0603 | https://www.murata.com/en-us/products/productdata/8796750610462/QNFA9122.pdf | Murata | BLM18KG601SZ1D | 490-14398-1-ND | https://www.digikey.com/product-detail/en/murata-electronics-north-america/BLM18KG601SZ1D/490-14398-1-ND/6606859 | 25% | https://www.digikey.com/products/en/filters/ferrite-beads-and-chips/841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
FB1608 | BLM18KG601SZ1D | dvk-mx8m-bsb:FER-0603 | https://www.murata.com/en-us/products/productdata/8796750610462/QNFA9122.pdf | Murata | BLM18KG601SZ1D | 490-14398-1-ND | https://www.digikey.com/product-detail/en/murata-electronics-north-america/BLM18KG601SZ1D/490-14398-1-ND/6606859 | 25% | https://www.digikey.com/products/en/filters/ferrite-beads-and-chips/841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
FB1604 | BLM18KG601SZ1D | dvk-mx8m-bsb:FER-0603 | https://www.murata.com/en-us/products/productdata/8796750610462/QNFA9122.pdf | Murata | BLM18KG601SZ1D | 490-14398-1-ND | https://www.digikey.com/product-detail/en/murata-electronics-north-america/BLM18KG601SZ1D/490-14398-1-ND/6606859 | 25% | https://www.digikey.com/products/en/filters/ferrite-beads-and-chips/841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
FB1605 | BLM18KG601SZ1D | dvk-mx8m-bsb:FER-0603 | https://www.murata.com/en-us/products/productdata/8796750610462/QNFA9122.pdf | Murata | BLM18KG601SZ1D | 490-14398-1-ND | https://www.digikey.com/product-detail/en/murata-electronics-north-america/BLM18KG601SZ1D/490-14398-1-ND/6606859 | 25% | https://www.digikey.com/products/en/filters/ferrite-beads-and-chips/841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
FB601 | BLM18PG121SN1D | dvk-mx8m-bsb:FER-0603 | https://www.murata.com/en-us/products/productdata/8796738650142/ENFA0003.pdf | Murata | BLM18PG121SN1D | 490-1037-1-ND | https://www.digikey.com/product-detail/en/murata-electronics-north-america/BLM18PG121SN1D/490-1037-1-ND/584485 | 25% | https://octopart.com/search?q=BLM18PG121SN1D&start=0
FB1601 | BLM18PG121SN1D | dvk-mx8m-bsb:FER-0603 | https://www.murata.com/en-us/products/productdata/8796738650142/ENFA0003.pdf | Murata | BLM18PG121SN1D | 490-1037-1-ND | https://www.digikey.com/product-detail/en/murata-electronics-north-america/BLM18PG121SN1D/490-1037-1-ND/584485 | 25% | https://octopart.com/search?q=BLM18PG121SN1D&start=0
FB1602 | BLM18PG121SN1D | dvk-mx8m-bsb:FER-0603 | https://www.murata.com/en-us/products/productdata/8796738650142/ENFA0003.pdf | Murata | BLM18PG121SN1D | 490-1037-1-ND | https://www.digikey.com/product-detail/en/murata-electronics-north-america/BLM18PG121SN1D/490-1037-1-ND/584485 | 25% | https://octopart.com/search?q=BLM18PG121SN1D&start=0
FB1603 | BLM18PG121SN1D | dvk-mx8m-bsb:FER-0603 | https://www.murata.com/en-us/products/productdata/8796738650142/ENFA0003.pdf | Murata | BLM18PG121SN1D | 490-1037-1-ND | https://www.digikey.com/product-detail/en/murata-electronics-north-america/BLM18PG121SN1D/490-1037-1-ND/584485 | 25% | https://octopart.com/search?q=BLM18PG121SN1D&start=0
FB1701 | BLM18PG121SN1D | dvk-mx8m-bsb:FER-0603 | https://www.murata.com/en-us/products/productdata/8796738650142/ENFA0003.pdf | Murata | BLM18PG121SN1D | 490-1037-1-ND | https://www.digikey.com/product-detail/en/murata-electronics-north-america/BLM18PG121SN1D/490-1037-1-ND/584485 | 25% | https://octopart.com/search?q=BLM18PG121SN1D&start=0
FB1702 | BLM18PG121SN1D | dvk-mx8m-bsb:FER-0603 | https://www.murata.com/en-us/products/productdata/8796738650142/ENFA0003.pdf | Murata | BLM18PG121SN1D | 490-1037-1-ND | https://www.digikey.com/product-detail/en/murata-electronics-north-america/BLM18PG121SN1D/490-1037-1-ND/584485 | 25% | https://octopart.com/search?q=BLM18PG121SN1D&start=0
FB1703 | BLM18PG121SN1D | dvk-mx8m-bsb:FER-0603 | https://www.murata.com/en-us/products/productdata/8796738650142/ENFA0003.pdf | Murata | BLM18PG121SN1D | 490-1037-1-ND | https://www.digikey.com/product-detail/en/murata-electronics-north-america/BLM18PG121SN1D/490-1037-1-ND/584485 | 25% | https://octopart.com/search?q=BLM18PG121SN1D&start=0
FB2001 | BLM18PG121SN1D | dvk-mx8m-bsb:FER-0603 | https://www.murata.com/en-us/products/productdata/8796738650142/ENFA0003.pdf | Murata | BLM18PG121SN1D | 490-1037-1-ND | https://www.digikey.com/product-detail/en/murata-electronics-north-america/BLM18PG121SN1D/490-1037-1-ND/584485 | 25% | https://octopart.com/search?q=BLM18PG121SN1D&start=0
FB2002 | BLM18PG121SN1D | dvk-mx8m-bsb:FER-0603 | https://www.murata.com/en-us/products/productdata/8796738650142/ENFA0003.pdf | Murata | BLM18PG121SN1D | 490-1037-1-ND | https://www.digikey.com/product-detail/en/murata-electronics-north-america/BLM18PG121SN1D/490-1037-1-ND/584485 | 25% | https://octopart.com/search?q=BLM18PG121SN1D&start=0
FB2301 | BLM18PG121SN1D | dvk-mx8m-bsb:FER-0603 | https://www.murata.com/en-us/products/productdata/8796738650142/ENFA0003.pdf | Murata | BLM18PG121SN1D | 490-1037-1-ND | https://www.digikey.com/product-detail/en/murata-electronics-north-america/BLM18PG121SN1D/490-1037-1-ND/584485 | 25% | https://octopart.com/search?q=BLM18PG121SN1D&start=0
FB301 | HI1206T500R | dvk-mx8m-bsb:FER-1206 | http://assets.lairdtech.com/home/brandworld/files/HI1206T500R-10.pdf | Laird | HI1206T500R-10 | 875-HI1206T500R-10 | https://www.mouser.com/ProductDetail/Laird/HI1206T500R-10 | 38Ω-63Ω | https://www.digikey.com/products/en/filters/ferrite-beads-and-chips/841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
F301 | nanoSMD350LR | dvk-mx8m-bsb:LittleFuse_1206 | http://www.littelfuse.com/~/media/electronics/datasheets/resettable_ptcs/littelfuse_ptc_lowrhosmd_datasheet.pdf.pdf | Littelfuse | nanoSMD350LR | NANOSMD350LR-2 | https://www.arrow.com/en/products/nanosmd350lr-2/littelfuse | - | https://www.digikey.com/products/en/circuit-protection/ptc-resettable-fuses/150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
F201 | nanoSMD400LR | dvk-mx8m-bsb:LittleFuse_1206 | http://www.littelfuse.com/~/media/electronics/datasheets/resettable_ptcs/littelfuse_ptc_lowrhosmd_datasheet.pdf.pdf | Littelfuse | nanoSMD400LR | NANOSMD400LR-C-2 | https://www.arrow.com/en/products/nanosmd400lr-c-2/littelfuse | - | https://www.digikey.com/products/en/circuit-protection/ptc-resettable-fuses/150?k=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
F1901 | PICOSMDC035S-2 | dvk-mx8m-bsb:Fuse_SMD0805_Reflow | http://m.littelfuse.com/~/media/electronics/product_specifications/resettable_ptcs/littelfuse_ptc_picosmdc035s_2_product_specification.pdf.pdf | Littlefuse | PICOSMDC035S-2 | PICOSMDC035S-2 | https://www.arrow.com/en/products/picosmdc035s-2/littelfuse | - | https://octopart.com/search?q=PICOSMDC035S&start=0
J2401 | Conn_01x02 | dvk-mx8m-bsb:1.25T-1-2AW | https://datasheet.lcsc.com/szlcsc/Boom-Precision-Elec-1-25T-1-2AW_C10832.pdf | Boom Precision | 1.25T-1-2AW | 1.25T-1-2AW | https://lcsc.com/product-detail/1-25T-Connectors_1-25T-1-2AW_C10832.html | - | https://www.arrow.com/en/products/0530480210/molex
J1803 | Key_E | dvk-mx8m-bsb:MDT320E03001 | https://signin.amphenolcanada.com/ProductSearch/drawings/AC/MDTXXXXXX001.pdf | Amphenol | MDT320E03001 | MDT320E03001CT-ND | https://www.digikey.com/product-detail/en/amphenol-commercial-products/MDT320E03001/MDT320E03001CT-ND/5810380 | - | https://octopart.com/search?q=MDT320E03001&start=0
J1202 | LCD | dvk-mx8m-bsb:Conn_Hirose_FPC_39x0_3 | https://www.hirose.com/product/en/download_file/key_name/FH26-39S-0.3SHW%2805%29/category/Drawing%20(2D)/doc_file_id/42931/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 | Hirose | FH26-39S-0.3SHW | FH26-39S-0.3SHW(05) | https://www.arrow.com/en/products/fh26-39s-0.3shw-05/hirose-electric | - | https://octopart.com/search?q=FH26-39s-0.3shw&start=0
J1001 | Micro_SD | dvk-mx8m-bsb:ALPS_SCHA4B0419 | https://www.mouser.com/datasheet/2/15/alps_SCHA4B0419-1155906.pdf | ALPS | SCHA4B0419 | 688-SCHA4B0419 | https://www.mouser.com/ProductDetail/ALPS/SCHA4B0419 | - | https://www.mouser.com/Connectors/Memory-Connectors/Memory-Card-Connectors/_/N-axj8k?P=1yzxfxm&Ns=Pricing|0
J1503 | Micro_SIM_Card | dvk-mx8m-bsb:JAE_SF56 | http://www.jae.com/z-en/pdf_download_exec.cfm?param=MB-0256-2E_SF56.pdf | JAE | SF56S006V4BR2000 | 670-2834-1-ND | https://www.digikey.com/product-detail/en/jae-electronics/SF56S006V4BR2000/670-2834-1-ND/5280152 | - | https://www.digikey.com/products/en/connectors-interconnects/memory-connectors-pc-card-sockets/414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
J1901 | Mini-HDMI | dvk-mx8m-bsb:HDMI_Mini_Female_2001-1-2-21-00-BK | http://cnctech.us/pdfs/2001-1-2-21-00-BK.pdf |  | 2001-1-2-21-00-BK | 1175-1704-1-ND | https://www.digikey.com/product-detail/en/cnc-tech/2001-1-2-21-00-BK/1175-1704-1-ND/4867013 | - | https://www.digikey.com/products/en/connectors-interconnects/usb-dvi-hdmi-connectors/312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
J1502 | mPCIe | dvk-mx8m-bsb:mpcie-socket | http://www.te.com/commerce/DocumentDelivery/DDEController?Action=showdoc | TE Connectivity | 2041119-1 | 571-2041119-1 | https://www2.mouser.com/ProductDetail/TE-Connectivity/2041119-1?qs=%252bD5sUuPmlApmv1YR%252baSc%252bw%3D%3D
J701 | NC | Pin_Headers:Pin_Header_Straight_1x06_Pitch2.54mm | https://media.digikey.com/PDF/Data%20Sheets/Sullins%20PDFs/z%20RzCzzzSzzN-RC,%20ST,11635-B.pdf | Sullins | PREC006SAAN-RC | S1012EC-06-ND | https://www.digikey.com/product-detail/en/sullins-connector-solutions/PREC006SAAN-RC/S1012EC-06-ND/2774848 | - | https://www.digikey.com/products/en/connectors-interconnects/rectangular-connectors-headers-male-pins/314?k=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
J801 | NC | Pin_Headers:Pin_Header_Straight_2x05_Pitch1.27mm_SMD | https://media.digikey.com/pdf/Data%20Sheets/Sullins%20PDFs/GRPB_%20_2VWQS-RC%2010958-C.pdf | Sullins | GRPB052VWQS-RC | S9012E-05-ND | https://www.digikey.com/product-detail/en/sullins-connector-solutions/GRPB052VWQS-RC/S9012E-05-ND/1786414 | - | https://www.digikey.com/products/en/connectors-interconnects/rectangular-connectors-headers-male-pins/314?k=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
J1301 | OV5640 | dvk-mx8m-bsb:Conn_Pan_AXT530124 | https://www3.panasonic.biz/ac/cdn/e/control/connector/base-fpc/catalog/con_eng_f4s.pdf | Panasonic | AXT530124 | 769-AXT530124 | https://www.mouser.com/ProductDetail/Panasonic-Industrial-Devices/AXT530124?qs=2rFUEsTwVNyiwPOEKkiHLw%3D%3D | - | https://octopart.com/search?q=AXT530124&start=0
J1701 | RJ45 | dvk-mx8m-bsb:Conn_Molex_MagJack | http://www.molex.com/pdm_docs/sd/936263006_sd.pdf |  | 936263006 | WM17615-ND | https://www.mouser.com/ProductDetail/Molex/93626-3006 | - | https://octopart.com/search?q=93626-3006&start=0
J1601 | SJ-43515TS | dvk-mx8m-bsb:Phone_Jack_SJ-43515TS | https://www.cui.com/product/resource/sj-4351x.pdf | CUI | SJ-43515TS | CP-43515TS-ND | https://www.arrow.com/en/products/sj-43515ts/cui-inc | - | https://www.digikey.com/products/en/connectors-interconnects/barrel-audio-connectors/434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
J2201 | Smart_Card | dvk-mx8m-bsb:Conn_Amphenol_SIMcard_10100271 | https://www.amphenolcanada.com/productsearch/drawings/ac/1010027182.pdf | Amphenol | 1010027182 | 1010027182 | https://www.onlinecomponents.com/amphenol-commercial-products-1010027182.html?p=48410341 | - | https://octopart.com/search?q=1010027182&start=0
J1201 | Touch | dvk-mx8m-bsb:FH34SRJ-6S-0.5SH | https://www.hirose.com/product/download/?distributor=digikey&type=2d&lang=en&num=FH34SRJ-6S-0.5SH(50) | Hirose Electric | FH34SRJ-6S-0.5SH(50) | H125773CT-ND | https://www.digikey.com/product-detail/en/hirose-electric-co-ltd/FH34SRJ-6S-0.5SH-50/H125773CT-ND/8594852 | - | https://www.mouser.com/ProductDetail/Hirose-Connector/FH34SRJ-6S-05SH50?qs=vnk2wBG9e15jF3vv7p0sbw%3D%3D
J1501 | U.FL | dvk-mx8m-bsb:U.FL_Hirose_U.FL-R-SMT-1_Vertical | https://linxtechnologies.com/wp/wp-content/uploads/conufl001-smd.pdf | Linx | CONUFL001-SMD-T | 712-CONUFL001-SMD-T | https://www.mouser.com/ProductDetail/Linx-Technologies/CONUFL001-SMD-T | - | https://octopart.com/search?q=CONUFL001-SMD-T&oq=CONUFL001-SMD-T&start=0
J1801 | MHF4 | dvk-mx8m-bsb:MHF4_20449-001E | http://www.taoglas.com/images/product_images/original_images/RECE.20449.001E.01.pdf | Taoglas | RECE-20449-001E-01 | 960-RECE20449-001E01 | https://www.mouser.com/ProductDetail/Taoglas/RECE-20449-001E-01 | - | https://octopart.com/search?q=RECE-20449-001E-01&start=0
J1802 | MHF4 | dvk-mx8m-bsb:MHF4_20449-001E | http://www.taoglas.com/images/product_images/original_images/RECE.20449.001E.01.pdf | Taoglas | RECE-20449-001E-01 | 960-RECE20449-001E01 | https://www.mouser.com/ProductDetail/Taoglas/RECE-20449-001E-01 | - | https://octopart.com/search?q=RECE-20449-001E-01&start=0
J201 | USB_C | dvk-mx8m-bsb:USB_C_Receptacle | https://www.mouser.com/datasheet/2/18/Amphenol_03192018_12401598E4_2A-1313897.pdf | Amphenol | 12401598E4#2A | 523-12401598E4#2A | https://www.mouser.com/ProductDetail/Amphenol-Commercial-Products/12401598E42A | - | https://www.digikey.com/products/en/connectors-interconnects/usb-dvi-hdmi-connectors/312?k=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
JP301 | NC | Pin_Headers:Pin_Header_Straight_1x02_Pitch2.54mm | https://www.molex.com/webdocs/datasheets/pdf/en-us/0015381026_ACCESSORIES.pdf | Molex | 22284020 | WM50014-02-ND | https://www.digikey.com/product-detail/en/molex-llc/0022284020/WM50014-02-ND/313787 | - | https://www.arrow.com/en/products/0015381026/molex
JP401 | NC | Pin_Headers:Pin_Header_Straight_1x02_Pitch2.00mm | http://suddendocs.samtec.com/testreports/440550_report_rev_1_qua.pdf | Samtec | TMM-102-03-T-S | SAM8977-ND | https://www.digikey.com/product-detail/en/samtec-inc/TMM-102-03-T-S/SAM8977-ND/2345206 | - | https://www.arrow.com/en/products/2sn-bk-g/samtec
JP402 | NC | Pin_Headers:Pin_Header_Straight_1x02_Pitch2.00mm | http://suddendocs.samtec.com/testreports/440550_report_rev_1_qua.pdf | Samtec | TMM-102-03-T-S | SAM8977-ND | https://www.digikey.com/product-detail/en/samtec-inc/TMM-102-03-T-S/SAM8977-ND/2345206 | - | https://www.arrow.com/en/products/2sn-bk-g/samtec
JP403 | NC | Pin_Headers:Pin_Header_Straight_1x02_Pitch2.00mm | http://suddendocs.samtec.com/testreports/440550_report_rev_1_qua.pdf | Samtec | TMM-102-03-T-S | SAM8977-ND | https://www.digikey.com/product-detail/en/samtec-inc/TMM-102-03-T-S/SAM8977-ND/2345206 | - | https://www.arrow.com/en/products/2sn-bk-g/samtec
JP404 | NC | Pin_Headers:Pin_Header_Straight_1x02_Pitch2.00mm | http://suddendocs.samtec.com/testreports/440550_report_rev_1_qua.pdf | Samtec | TMM-102-03-T-S | SAM8977-ND | https://www.digikey.com/product-detail/en/samtec-inc/TMM-102-03-T-S/SAM8977-ND/2345206 | - | https://www.arrow.com/en/products/2sn-bk-g/samtec
JP1801 | NC | Pin_Headers:Pin_Header_Straight_1x02_Pitch2.00mm | http://suddendocs.samtec.com/testreports/440550_report_rev_1_qua.pdf | Samtec | TMM-102-03-T-S | SAM8977-ND | https://www.digikey.com/product-detail/en/samtec-inc/TMM-102-03-T-S/SAM8977-ND/2345206 | - | https://www.arrow.com/en/products/2sn-bk-g/samtec
L301 | 1uH | dvk-mx8m-bsb:IHLP-2020BZ-11 | https://www.vishay.com/docs/34261/ihlp2020bz11.pdf | Vishay | IHLP2020BZER1R0M11 | 70-IHLP2020BZER1R0M1 | https://www.arrow.com/en/products/ihlp2020bzer1r0m11/vishay | 20% | https://www.digikey.com/products/en/inductors-coils-chokes/fixed-inductors/71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
L401 | 1uH | dvk-mx8m-bsb:XAL4020-102MEC | https://www.coilcraft.com/pdfs/xal4000.pdf | Coilcraft | XAL4020-102MEC | 994-XAL4020-102MEC | https://www.mouser.com/ProductDetail/Coilcraft/XAL4020-102MEC?qs=zCSbvcPd3pbLq0M7ZKfPRA%3D%3D | - | https://www.mouser.com/ProductDetail/Coilcraft/XAL4020-102MEB
L402 | 2.2uH | dvk-mx8m-bsb:XAL5030-222 | https://www.coilcraft.com/pdfs/xal50xx.pdf | Coilcraft | XAL5030-222 | 994-XAL5030-222MEB | https://www.mouser.com/ProductDetail/Coilcraft/XAL5030-222MEB | 20% | https://www.coilcraft.com/apps/finder/finder.cfm?mfc=Richtek&apl=2%20uH&IC=RT8070&desc=Step-down%20converter
L404 | 2.2uH | dvk-mx8m-bsb:LPS4018-222MRB | https://www.coilcraft.com/pdfs/lps4018.pdf | Coilcraft | LPS4018-222MRB | 994-LPS4018-222MRB | https://www.mouser.com/ProductDetail/Coilcraft/LPS4018-222MRB | 20% | https://www.mouser.com/Search/Refine.aspx?Keyword=LPS4018-222M
L403 | 22uH | dvk-mx8m-bsb:LQH32CN220K | https://search.murata.co.jp/Ceramy/image/img/P02/JELF243A-0039.pdf | Murata | LQH32CN220K | LQH32CN220K23L | https://www.arrow.com/en/products/lqh32cn220k23l/murata-manufacturing | 10% | https://www.arrow.com/en/products/lqh32cn220k53l/murata-manufacturing
L1701 | 4.7uH | dvk-mx8m-bsb:L_1008 | http://www.samsungsem.com/kr/support/product-search/inductor/__icsFiles/afieldfile/2014/11/13/S_CIG22L4R7MNE.pdf | Samsung | CIG22L4R7MNE | 1276-6213-2-ND | https://www.digikey.com/product-detail/en/samsung-electro-mechanics/CIG22L4R7MNE/1276-6213-2-ND/3971869 | 20% | https://octopart.com/search?q=CIG22L4R7MNE&start=0
L1501 | NC | Inductors_SMD:L_0402
L1502 | NC | Inductors_SMD:L_0402
L1801 | NC | Inductors_SMD:L_0402
L1802 | NC | Inductors_SMD:L_0402
L2301 | NC | Inductors_SMD:L_0402
L2302 | NC | Inductors_SMD:L_0402
LS1601 | AS01608MS-SP9 | dvk-mx8m-bsb:Speaker_flat_15x11x4mm | http://www.puiaudio.com/pdf/AS01508MS-SP11-WP-R.pdf | PUI Audio | AS01508MS-SP11-WP-R | 668-1613-ND | https://www.digikey.com/product-detail/en/pui-audio-inc/AS01508MS-SP11-WP-R/668-1613-ND/8021804 | 15% | https://www.digikey.com/products/en/audio-products/speakers/156?k=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
M2401 | Motor | dvk-mx8m-bsb:BY0820Z021L20 | https://cloud.puri.sm/s/z8JR6DJ4KrJYzoW | Yichang Flourishing | BY0820Z021L20 | BY0820L20 | https://www.alibaba.com/product-detail/Coin-motor-vibration-dc-motorcellphone_1994583657.html | - | http://nfpshop.com/product/nfp-coin-motor-c0834-free-wire/
MK1601 | CMC-2242PBL | dvk-mx8m-bsb:Electret_Condenser_Mic_6mm | https://www.cui.com/product/resource/cmc-2242pbl-a.pdf | CUI | CMC-2242PBL-A | 102-1727-ND | https://www.digikey.com/product-detail/en/cui-inc/CMC-2242PBL-A/102-1727-ND/1869987 | ±3dB | https://www.digikey.com/products/en/audio-products/microphones/158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
MOD101 | EmC_SoM | dvk-mx8m-bsb:EmCr_SOM_IMX8M_Outline | https://emcraft.com/component/jdownloads/view.download/153/1141
MOD1501 | ModemCard | dvk-mx8m-bsb:mpcie-outline | https://cloud.puri.sm/s/iSg345Zb5Fyd354
MOD1801 | WifiBTCard | dvk-mx8m-bsb:M2Card_E_2230 | http://www.redpinesignals.com/pdfs/RS9116_Connectivity_Product_Brief.pdf
P1 | IMX8M-SOM1 | dvk-mx8m-bsb:EmCr_SOM_IMX8M_Connector | https://www.hirose.com/product/en/download_file/key_name/DF40/category/Catalog/doc_file_id/31649/?item_id=22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 | Hirose | DF40HC(4.0)-80DS-0.4V(51)
P2 | IMX8M-SOM2 | dvk-mx8m-bsb:EmCr_SOM_IMX8M_Connector
P3 | IMX8M-SOM3 | dvk-mx8m-bsb:EmCr_SOM_IMX8M_Connector
P4 | IMX8M-SOM4 | dvk-mx8m-bsb:EmCr_SOM_IMX8M_Connector
Q901 | DMG2301L | TO_SOT_Packages_SMD:SOT-23 | https://www.diodes.com/assets/Datasheets/DMG2301L.pdf | Diodes Inc | DMG2301L-7 | 621-DMG2301L-7 | https://www.mouser.com/ProductDetail/Diodes-Incorporated/DMG2301L-7 | - | https://www.digikey.com/products/en/discrete-semiconductor-products/transistors-fets-mosfets-single/278
Q2401 | DMG2301L | TO_SOT_Packages_SMD:SOT-23 | https://www.diodes.com/assets/Datasheets/DMG2301L.pdf | Diodes Inc | DMG2301L-7 | 621-DMG2301L-7 | https://www.mouser.com/ProductDetail/Diodes-Incorporated/DMG2301L-7 | - | https://www.digikey.com/products/en/discrete-semiconductor-products/transistors-fets-mosfets-single/278
Q301 | FDV301N | dvk-mx8m-bsb:FDV301N | http://www.onsemi.com/pub/Collateral/FDV301N-D.PDF | ON Semiconductor | FDV301N | FDV301N | https://www.tme.eu/en/details/fdv301n/smd-n-channel-transistors/on-semiconductor-fairchild/ | - | https://www.arrow.com/en/products/fdv301n/on-semiconductor
Q1102 | FDV301N | dvk-mx8m-bsb:FDV301N | http://www.onsemi.com/pub/Collateral/FDV301N-D.PDF | ON Semiconductor | FDV301N | FDV301N | https://www.tme.eu/en/details/fdv301n/smd-n-channel-transistors/on-semiconductor-fairchild/ | - | https://www.arrow.com/en/products/fdv301n/on-semiconductor
Q1101 | FDV301N | dvk-mx8m-bsb:FDV301N | http://www.onsemi.com/pub/Collateral/FDV301N-D.PDF | ON Semiconductor | FDV301N | FDV301N | https://www.tme.eu/en/details/fdv301n/smd-n-channel-transistors/on-semiconductor-fairchild/ | - | https://www.arrow.com/en/products/fdv301n/on-semiconductor
Q1202 | FDV301N | dvk-mx8m-bsb:FDV301N | http://www.onsemi.com/pub/Collateral/FDV301N-D.PDF | ON Semiconductor | FDV301N | FDV301N | https://www.tme.eu/en/details/fdv301n/smd-n-channel-transistors/on-semiconductor-fairchild/ | - | https://www.arrow.com/en/products/fdv301n/on-semiconductor
Q1201 | FDV301N | dvk-mx8m-bsb:FDV301N | http://www.onsemi.com/pub/Collateral/FDV301N-D.PDF | ON Semiconductor | FDV301N | FDV301N | https://www.tme.eu/en/details/fdv301n/smd-n-channel-transistors/on-semiconductor-fairchild/ | - | https://www.arrow.com/en/products/fdv301n/on-semiconductor
Q1401 | FDV301N | dvk-mx8m-bsb:FDV301N | http://www.onsemi.com/pub/Collateral/FDV301N-D.PDF | ON Semiconductor | FDV301N | FDV301N | https://www.tme.eu/en/details/fdv301n/smd-n-channel-transistors/on-semiconductor-fairchild/ | - | https://www.arrow.com/en/products/fdv301n/on-semiconductor
Q1501 | FDV301N | dvk-mx8m-bsb:FDV301N | http://www.onsemi.com/pub/Collateral/FDV301N-D.PDF | ON Semiconductor | FDV301N | FDV301N | https://www.tme.eu/en/details/fdv301n/smd-n-channel-transistors/on-semiconductor-fairchild/ | - | https://www.arrow.com/en/products/fdv301n/on-semiconductor
Q1801 | FDV301N | dvk-mx8m-bsb:FDV301N | http://www.onsemi.com/pub/Collateral/FDV301N-D.PDF | ON Semiconductor | FDV301N | FDV301N | https://www.tme.eu/en/details/fdv301n/smd-n-channel-transistors/on-semiconductor-fairchild/ | - | https://www.arrow.com/en/products/fdv301n/on-semiconductor
Q1802 | FDV301N | dvk-mx8m-bsb:FDV301N | http://www.onsemi.com/pub/Collateral/FDV301N-D.PDF | ON Semiconductor | FDV301N | FDV301N | https://www.tme.eu/en/details/fdv301n/smd-n-channel-transistors/on-semiconductor-fairchild/ | - | https://www.arrow.com/en/products/fdv301n/on-semiconductor
Q1502 | MMBT2222A | TO_SOT_Packages_SMD:SOT-23 | https://www.onsemi.com/pub/Collateral/MMBT2222LT1-D.PDF | ON Semiconductor | MMBT2222ALT1G | MMBT2222ALT1G | https://www.tme.eu/en/details/mmbt2222alt1g/npn-smd-transistors/on-semiconductor/ | - | http://www.digipart.com/part/MMBT2222A
Q1901 | NX3020NAKS | dvk-mx8m-bsb:6-TSSOP | https://assets.nexperia.com/documents/data-sheet/NX3020NAKS.pdf | NXP | NX3020NAKS | NX3020NAKS,115 | https://www.arrow.com/en/products/nx3020naks115/nexperia | - | https://octopart.com/search?q=NX3020NAKS&start=0
Q1903 | NX3020NAKS | dvk-mx8m-bsb:6-TSSOP | https://assets.nexperia.com/documents/data-sheet/NX3020NAKS.pdf | NXP | NX3020NAKS | NX3020NAKS,115 | https://www.arrow.com/en/products/nx3020naks115/nexperia | - | https://octopart.com/search?q=NX3020NAKS&start=0
Q1902 | NX3020NAKS | dvk-mx8m-bsb:6-TSSOP | https://assets.nexperia.com/documents/data-sheet/NX3020NAKS.pdf | NXP | NX3020NAKS | NX3020NAKS,115 | https://www.arrow.com/en/products/nx3020naks115/nexperia | - | https://octopart.com/search?q=NX3020NAKS&start=0
Q1904 | NX3020NAKS | dvk-mx8m-bsb:6-TSSOP | https://assets.nexperia.com/documents/data-sheet/NX3020NAKS.pdf | NXP | NX3020NAKS | NX3020NAKS,115 | https://www.arrow.com/en/products/nx3020naks115/nexperia | - | https://octopart.com/search?q=NX3020NAKS&start=0
R226 | 0 | Resistors_SMD:R_0402
R807 | 0 | Resistors_SMD:R_0402
R907 | 0 | Resistors_SMD:R_0402
R908 | 0 | Resistors_SMD:R_0402
R901 | 0 | Resistors_SMD:R_0402
R1001 | 0 | Resistors_SMD:R_0402
R1914 | 0 | Resistors_SMD:R_0402
R2002 | 0 | Resistors_SMD:R_0402
R2202 | 0 | Resistors_SMD:R_0402
R910 | 1 | Resistors_SMD:R_0402
R903 | 1 | Resistors_SMD:R_0402
R416 | 5.1 | Resistors_SMD:R_0402 | http://www.yageo.com/documents/recent/PYu-RT_1-to-0.01_RoHS_L_9.pdf | Yageo | RT0603DRE075R1L | 603-RT0603DRE075R1L | https://www.mouser.com/ProductDetail/Yageo/RT0603DRE075R1L | 0.5% | https://www.digikey.com/products/en/resistors/chip-resistor-surface-mount/52?k=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
R1402 | 33 | Resistors_SMD:R_0402
R1401 | 33 | Resistors_SMD:R_0402
R1404 | 33 | Resistors_SMD:R_0402
R1403 | 33 | Resistors_SMD:R_0402
R1603 | 33 | Resistors_SMD:R_0402
R1605 | 33 | Resistors_SMD:R_0402
R2203 | 33 | Resistors_SMD:R_0402
R1410 | 100 | Resistors_SMD:R_0402
R2402 | 100 | Resistors_SMD:R_0402
R805 | 120 | Resistors_SMD:R_0402
R306 | 191 | Resistors_SMD:R_0402
R1725 | 270 | Resistors_SMD:R_0402
R1723 | 270 | Resistors_SMD:R_0402
R1724 | 270 | Resistors_SMD:R_0402
R904 | 330 | Resistors_SMD:R_0402
R906 | 330 | Resistors_SMD:R_0402
R1411 | 330 | Resistors_SMD:R_0402
R1901 | 604 | Resistors_SMD:R_0402
R1903 | 604 | Resistors_SMD:R_0402
R1905 | 604 | Resistors_SMD:R_0402
R1907 | 604 | Resistors_SMD:R_0402
R1902 | 604 | Resistors_SMD:R_0402
R1904 | 604 | Resistors_SMD:R_0402
R1906 | 604 | Resistors_SMD:R_0402
R1908 | 604 | Resistors_SMD:R_0402
R222 | 1.2M | Resistors_SMD:R_0402
R310 | 1.5k | Resistors_SMD:R_0402
R1910 | 1.5k | Resistors_SMD:R_0402
R1911 | 1.5k | Resistors_SMD:R_0402
R1718 | 1.62k | Resistors_SMD:R_0402
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
R409 | 910k | Resistors_SMD:R_0402
R417 | 910k | Resistors_SMD:R_0402
R211 | NC | Resistors_SMD:R_0402
R212 | NC | Resistors_SMD:R_0402
R213 | NC | Resistors_SMD:R_0402
R215 | NC | Resistors_SMD:R_0402
R216 | NC | Resistors_SMD:R_0402
R217 | NC | Resistors_SMD:R_0402
R218 | NC | Resistors_SMD:R_0402
R202 | NC | Resistors_SMD:R_0402
R203 | NC | Resistors_SMD:R_0402
R204 | NC | Resistors_SMD:R_0402
R205 | NC | Resistors_SMD:R_0402
R219 | NC | Resistors_SMD:R_0402
R309 | NC | Resistors_SMD:R_2512 | https://riedon.com/media/pdf/CSR.pdf | Riedon | CSR2512A0R025F | 696-1666-1-ND | https://www.digikey.com/product-detail/en/riedon/CSR2512A0R025F/696-1666-1-ND/5723654 | 1% | https://www.digikey.com/products/en/resistors/chip-resistor-surface-mount/52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
R411 | NC | Resistors_SMD:R_1206 | https://industrial.panasonic.com/cdbs/www-data/pdf/RDN0000/AOA0000C313.pdf | Panasonic | ERJ-8CWFR025V | P0.025BVCT-ND | https://www.digikey.com/product-detail/en/panasonic-electronic-components/ERJ-8CWFR025V/P0.025BVCT-ND/4927045 | 1% | https://www.digikey.com/products/en/resistors/chip-resistor-surface-mount/52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
R419 | NC | Resistors_SMD:R_0805 | https://www.seielect.com/Catalog/SEI-CSR_CSRN.pdf | Stackpole | CSR0805FK25L0 | CSR0805FK25L0CT-ND |  | 1% | https://www.digikey.com/products/en/resistors/chip-resistor-surface-mount/52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
R402 | NC | Resistors_SMD:R_0402
R413 | NC | Resistors_SMD:R_1206 | https://industrial.panasonic.com/cdbs/www-data/pdf/RDN0000/AOA0000C313.pdf | Panasonic | ERJ-8CWFR025V | P0.025BVCT-ND | https://www.digikey.com/product-detail/en/panasonic-electronic-components/ERJ-8CWFR025V/P0.025BVCT-ND/4927045 | 1% | https://www.digikey.com/products/en/resistors/chip-resistor-surface-mount/52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
R414 | NC | Resistors_SMD:R_1206 | https://industrial.panasonic.com/cdbs/www-data/pdf/RDN0000/AOA0000C313.pdf | Panasonic | ERJ-8CWFR025V | P0.025BVCT-ND | https://www.digikey.com/product-detail/en/panasonic-electronic-components/ERJ-8CWFR025V/P0.025BVCT-ND/4927045 | 1% | https://www.digikey.com/products/en/resistors/chip-resistor-surface-mount/52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
R507 | NC | Resistors_SMD:R_0402
R806 | NC | Resistors_SMD:R_0402
R804 | NC | Resistors_SMD:R_0402
R1004 | NC | Resistors_SMD:R_0402 | https://www.seielect.com/Catalog/SEI-RMCF_RMCP.pdf | Stackpole | RMCF0603JG10K0 | RMCF0603JG10K0CT-ND | https://www.digikey.com/product-detail/en/stackpole-electronics-inc/RMCF0603JG10K0/RMCF0603JG10K0CT-ND/4425128 | 5% | https://www.digikey.com/products/en/resistors/chip-resistor-surface-mount/52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
R1003 | NC | Resistors_SMD:R_0402 | https://www.seielect.com/Catalog/SEI-RMCF_RMCP.pdf | Stackpole | RMCF0603JG10K0 | RMCF0603JG10K0CT-ND | https://www.digikey.com/product-detail/en/stackpole-electronics-inc/RMCF0603JG10K0/RMCF0603JG10K0CT-ND/4425128 | 5% | https://www.digikey.com/products/en/resistors/chip-resistor-surface-mount/52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
R1002 | NC | Resistors_SMD:R_0402 | https://www.seielect.com/Catalog/SEI-RMCF_RMCP.pdf | Stackpole | RMCF0603JG10K0 | RMCF0603JG10K0CT-ND | https://www.digikey.com/product-detail/en/stackpole-electronics-inc/RMCF0603JG10K0/RMCF0603JG10K0CT-ND/4425128 | 5% | https://www.digikey.com/products/en/resistors/chip-resistor-surface-mount/52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
R1407 | NC | Resistors_SMD:R_0402 | https://www.seielect.com/Catalog/SEI-RMCF_RMCP.pdf | Stackpole | RMCF0603JG10K0 | RMCF0603JG10K0CT-ND | https://www.digikey.com/product-detail/en/stackpole-electronics-inc/RMCF0603JG10K0/RMCF0603JG10K0CT-ND/4425128 | 5% | https://www.digikey.com/products/en/resistors/chip-resistor-surface-mount/52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
R1408 | NC | Resistors_SMD:R_0402 | https://www.seielect.com/Catalog/SEI-RMCF_RMCP.pdf | Stackpole | RMCF0603JG10K0 | RMCF0603JG10K0CT-ND | https://www.digikey.com/product-detail/en/stackpole-electronics-inc/RMCF0603JG10K0/RMCF0603JG10K0CT-ND/4425128 | 5% | https://www.digikey.com/products/en/resistors/chip-resistor-surface-mount/52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
R1508 | NC | Resistors_SMD:R_0402
R1601 | NC | Resistors_SMD:R_0402
R1713 | NC | Resistors_SMD:R_0402
R1715 | NC | Resistors_SMD:R_0402
R1719 | NC | Resistors_SMD:R_0402
R1720 | NC | Resistors_SMD:R_0402
R1702 | NC | Resistors_SMD:R_0402
R1704 | NC | Resistors_SMD:R_0402
R1802 | NC | Resistors_SMD:R_1206 | https://industrial.panasonic.com/cdbs/www-data/pdf/RDN0000/AOA0000C313.pdf | Panasonic | ERJ-8CWFR025V | P0.025BVCT-ND | https://www.digikey.com/product-detail/en/panasonic-electronic-components/ERJ-8CWFR025V/P0.025BVCT-ND/4927045 | 1% | https://www.digikey.com/products/en/resistors/chip-resistor-surface-mount/52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
R1909 | NC | Resistors_SMD:R_0402
R2103 | NC | Resistors_SMD:R_0402
R2301 | NC | Resistors_SMD:R_0402
SW501 | DPDT | dvk-mx8m-bsb:Switch_CK_DPDT_JS202011JAQN | https://www.ckswitches.com/media/1422/js.pdf | C&K | JS202011JAQN | CKN10722CT-ND | https://www.digikey.com/product-detail/en/c-k/JS202011JAQN/CKN10722CT-ND/6137636 | - | https://www.digikey.com/products/en/switches/slide-switches/213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
SW1301 | DPDT | dvk-mx8m-bsb:Switch_CK_DPDT_JS202011JAQN | https://www.ckswitches.com/media/1422/js.pdf | C&K | JS202011JAQN | CKN10722CT-ND | https://www.digikey.com/product-detail/en/c-k/JS202011JAQN/CKN10722CT-ND/6137636 | - | https://www.digikey.com/products/en/switches/slide-switches/213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
SW1402 | SW_Push | dvk-mx8m-bsb:Tact_SW_side | http://omronfs.omron.com/en_US/ecb/products/pdf/en-b3u.pdf |  |  |  | https://www.digikey.com/product-detail/en/omron-electronics-inc-emc-div/B3U-3000P/SW1022CT-ND/1534359
SW1401 | SW_Push | dvk-mx8m-bsb:Tact_SW_side | http://omronfs.omron.com/en_US/ecb/products/pdf/en-b3u.pdf |  |  |  | https://www.digikey.com/product-detail/en/omron-electronics-inc-emc-div/B3U-3000P/SW1022CT-ND/1534359
SW1404 | SW_Push | dvk-mx8m-bsb:Tact_SW_side | http://omronfs.omron.com/en_US/ecb/products/pdf/en-b3u.pdf |  |  |  | https://www.digikey.com/product-detail/en/omron-electronics-inc-emc-div/B3U-3000P/SW1022CT-ND/1534359
SW1403 | SW_Push | dvk-mx8m-bsb:Tact_SW_side | http://omronfs.omron.com/en_US/ecb/products/pdf/en-b3u.pdf |  |  |  | https://www.digikey.com/product-detail/en/omron-electronics-inc-emc-div/B3U-3000P/SW1022CT-ND/1534359
SW1801 | DPDT | dvk-mx8m-bsb:Switch_CK_DPDT_JS202011JAQN | https://www.ckswitches.com/media/1422/js.pdf | C&K | JS202011JAQN | CKN10722CT-ND | https://www.digikey.com/product-detail/en/c-k/JS202011JAQN/CKN10722CT-ND/6137636 | - | https://www.digikey.com/products/en/switches/slide-switches/213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
SW1501 | DPDT | dvk-mx8m-bsb:Switch_CK_DPDT_JS202011JAQN | https://www.ckswitches.com/media/1422/js.pdf | C&K | JS202011JAQN | CKN10722CT-ND | https://www.digikey.com/product-detail/en/c-k/JS202011JAQN/CKN10722CT-ND/6137636 | - | https://www.digikey.com/products/en/switches/slide-switches/213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
TH301 | 10k | Resistors_SMD:R_0603 | https://industrial.panasonic.com/cdbs/www-data/pdf2/AUA0000/AUA0000AE291.pdf | Panasonic | ERTJ1VG103FA | ERT-J1VG103FA | https://www.arrow.com/en/products/ert-j1vg103fa/panasonic | 1% | https://www.mouser.com/ProductDetail/Semitec/103HT
TP101 | TEST_1P | Measurement_Points:Measurement_Point_Round-SMD-Pad_Small
TP1701 | TEST_1P | Measurement_Points:Measurement_Point_Round-SMD-Pad_Small
TP1702 | TEST_1P | Measurement_Points:Measurement_Point_Round-SMD-Pad_Small
U1504 | 74LVC1G08 | dvk-mx8m-bsb:74LVC1G08GF | https://assets.nexperia.com/documents/data-sheet/74LVC1G08.pdf | NXP | 74LVC1G08GF | 74LVC1G08GF/S505125 | https://www.rocelec.com/part/nexnxp74lvc1g08gf-s505125 | - | https://octopart.com/search?q=74LVC1G08GV%2C125&oq=74LVC1G08GV%2C125&start=0
U1301 | 74LVC1G32 | dvk-mx8m-bsb:74LVC1G32GF | https://assets.nexperia.com/documents/data-sheet/74LVC1G32_Q100.pdf | NXP | 74LVC1G32GF | 74LVC1G32GF/S505125 | https://www.rocelec.com/part/nexnxp74lvc1g32gf-s505125 | - | https://www.digikey.com/products/en/integrated-circuits-ics/logic-gates-and-inverters/705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
U2003 | 74LVC1G332 | dvk-mx8m-bsb:74LVC1G332DCKR | http://www.ti.com/lit/ds/symlink/sn74lvc1g332.pdf | Texas Instruments | SN74LVC1G332DCKR | SN74LVC1G332DCKR | https://www.rocelec.com/part/textissn74lvc1g332dckr | - | https://store.ti.com/SN74LVC1G332DCKR.aspx
U1503 | 74LVC1G86 | dvk-mx8m-bsb:74LVC1G86 | https://assets.nexperia.com/documents/data-sheet/74LVC1G86.pdf | NXP | 74LVC1G86GV,125 | 74LVC1G86GV125 | https://www.rocelec.com/part/nexnxp74lvc1g86gv125 | - | https://octopart.com/search?q=74LVC1G86GV%2C125&start=0
U1803 | 74AUP2G08 | dvk-mx8m-bsb:74AUP2G08DCU | http://www.ti.com/lit/ds/symlink/sn74aup2g08.pdf | Texas Instruments | SN74AUP2G08DCU | SN74AUP2G08DCUR | https://store.ti.com/SN74AUP2G08DCUR.aspx | - | https://www.rocelec.com/part/textissn74aup2g08dcur
U701 | 74LVC2G241 | dvk-mx8m-bsb:NXP_VSSOP-8-1EP_2x2.3mm_SOT765-1 | https://assets.nexperia.com/documents/data-sheet/74LVC2G241.pdf | NXP | 74LVC2G241DC,125 | 1727-7019-1-ND | https://www.digikey.com/product-detail/en/nexperia-usa-inc/74LVC2G241DC125/1727-7019-1-ND/2814262 | - | https://www.digikey.com/products/en/integrated-circuits-ics/logic-buffers-drivers-receivers-transceivers/704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
U404 | AP22814 | dvk-mx8m-bsb:AP22814 | https://www.diodes.com/assets/Datasheets/AP22804_14.pdf | Diodes Inc | AP22814ASN | AP22814ASN-7 | https://www.arrow.com/en/products/ap22814asn-7/diodes-incorporated | - | https://www.digikey.com/products/en/integrated-circuits-ics/pmic-power-distribution-switches-load-drivers/726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
U405 | AP22814 | dvk-mx8m-bsb:AP22814 | https://www.diodes.com/assets/Datasheets/AP22804_14.pdf | Diodes Inc | AP22814ASN | AP22814ASN-7 | https://www.arrow.com/en/products/ap22814asn-7/diodes-incorporated | - | https://www.digikey.com/products/en/integrated-circuits-ics/pmic-power-distribution-switches-load-drivers/726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
U1701 | AR8031 | dvk-mx8m-bsb:AR8031 | https://media.digikey.com/pdf/Data%20Sheets/CSR%20PDFs/AR8031_DS_(Atheros)_Rev1.0_Aug2011.pdf | Qualcomm Atheros | AR8031-AL1A | C111275 | https://lcsc.com/product-detail/Ethernet-ICs_ATHEROS_AR8031-AL1A_AR8031-AL1A_C111275.html | - | https://octopart.com/search?q=AR8031&start=0
U301 | BQ25896 | dvk-mx8m-bsb:BQ25896 | http://www.ti.com/lit/ds/symlink/bq25896.pdf | Texas Instruments | BQ25896 | BQ25896RTWT | https://store.ti.com/BQ25896RTWT.aspx | - | https://octopart.com/search?q=BQ25896&start=0
U1603 | FSA6157L6X | dvk-mx8m-bsb:FSA6157L6X | https://www.fairchildsemi.com/datasheets/FS/FSA6157.pdf | ON Semi | FSA6157L6X | 512-FSA6157L6X | https://www.mouser.com/ProductDetail/ON-Semiconductor-Fairchild/FSA6157L6X | - | https://www.digikey.com/products/en/integrated-circuits-ics/interface-analog-switches-special-purpose/780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
U406 | FT440 | dvk-mx8m-bsb:FT440 | http://www.ineltek.com/wp-content/uploads/manual/fmd/FT440x.pdf | Fremont Micro | FT440CA | 1219-1077-1-ND | https://www.digikey.com/product-detail/en/fremont-micro-devices-usa/FT440CA/1219-1077-1-ND/3516029 | - | https://www.digikey.com/products/en/integrated-circuits-ics/pmic-voltage-regulators-dc-dc-switching-regulators/739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
U2002 | LSM9DS1 | dvk-mx8m-bsb:LSM9DS1 | http://www.st.com/content/ccc/resource/technical/document/datasheet/1e/3f/2a/d6/25/eb/48/46/DM00103319.pdf/files/DM00103319.pdf/jcr:content/translations/en.DM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 | STMicroelectronics | LSM9DS1 | LSM9DS1TR | EBV | - | https://octopart.com/search?q=LSM9DS1&start=0
U901 | MA8627 | dvk-mx8m-bsb:LQFP-48_7x7mm_Pitch0.5mm | https://cloud.puri.sm/s/DLGJJxKKFXXYqwg
U2301 | MAX-M8Q | dvk-mx8m-bsb:MAX-M8 | https://www.u-blox.com/sites/default/files/MAX-M8-FW3_DataSheet_%28UBX-15031506%29.pdf | U-Blox | MAX-M8Q | MAX-M8Q | https://www.u-blox.com/en/product/max-m8-series | - | https://www.digikey.com/product-detail/en/u-blox-america-inc/MAX-M8Q-0/672-1003-1-ND/6150666
U402 | MIC2876 | dvk-mx8m-bsb:MIC2876 | http://ww1.microchip.com/downloads/en/DeviceDoc/20005572A.pdf | Microchip | MIC2876-AYMT-TR | MIC2876-AYMT-TR | https://www.arrow.com/en/products/mic2876-aymt-tr/microchip-technology | - | https://www.digikey.com/products/en/integrated-circuits-ics/pmic-voltage-regulators-dc-dc-switching-regulators/739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
U403 | MIC5365-2.8 | dvk-mx8m-bsb:MIC5365-2.8YD5 | http://ww1.microchip.com/downloads/en/DeviceDoc/mic5365.pdf | Microchip | MIC5365-2.8YD5 | 1611-MIC5365-2.85YC5-CT-ND | https://www.digikey.com/product-detail/en/microchip-technology/MIC5365-2.8YD5-TR/1611-MIC5365-2.8YD5-CT-ND/5700550 | - | https://octopart.com/search?q=MIC5365-2.8Y&start=0
U2101 | MX25L1606E | dvk-mx8m-bsb:MX25L1606EZNI | http://www.macronix.com/Lists/Datasheet/Attachments/7465/MX25L1606E,%203V,%2016Mb,%20v1.9.pdf | Macronix | MX25L1606EZNI-12G | MX25L1606EZNI-12G | https://www.arrow.com/en/products/mx25l1606ezni-12g/macronix-international | - | https://www.digikey.com/products/en/integrated-circuits-ics/memory/774?k=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
U1501 | NTB0104GU12 | dvk-mx8m-bsb:NTB0104GU12 | https://www.nxp.com/docs/en/data-sheet/NTB0104.pdf | NXP | NTB0104GU12,115 | NTB0104GU12115 | https://www.rocelec.com/part/NXPNXPNTB0104GU12115 | - | https://www.digikey.com/products/en/integrated-circuits-ics/logic-translators-level-shifters/732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
U1802 | NTB0104GU12 | dvk-mx8m-bsb:NTB0104GU12 | https://www.nxp.com/docs/en/data-sheet/NTB0104.pdf | NXP | NTB0104GU12,115 | NTB0104GU12115 | https://www.rocelec.com/part/NXPNXPNTB0104GU12115 | - | https://www.digikey.com/products/en/integrated-circuits-ics/logic-translators-level-shifters/732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
U1801 | NTB0104GU12 | dvk-mx8m-bsb:NTB0104GU12 | https://www.nxp.com/docs/en/data-sheet/NTB0104.pdf | NXP | NTB0104GU12,115 | NTB0104GU12115 | https://www.rocelec.com/part/NXPNXPNTB0104GU12115 | - | https://www.digikey.com/products/en/integrated-circuits-ics/logic-translators-level-shifters/732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
U1502 | NUP5120 | dvk-mx8m-bsb:NUP5120X6 | http://www.onsemi.com/pub/Collateral/NUP5120-D.PDF | ON Semi | NUP5120X6T1G | NUP5120X6T1GOSCT-ND | https://www.digikey.com/product-detail/en/on-semiconductor/NUP5120X6T1G/NUP5120X6T1GOSCT-ND/2122074 | - | ESDA6V1-5P6
U407 | PAM2841 | dvk-mx8m-bsb:PAM2841GR | https://www.diodes.com/assets/Datasheets/PAM2841.pdf | Diodes Inc | PAM2841GR | 621-PAM2841GR | https://www.mouser.com/ProductDetail/Diodes-Incorporated/PAM2841GR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 | - | https://www.digikey.com/products/en/integrated-circuits-ics/pmic-led-drivers/745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
U1602 | PAM8301 | dvk-mx8m-bsb:PAM8301 | https://www.diodes.com/assets/Datasheets/PAM8301.pdf | Diodes Inc | PAM8301AAF | PAM8301AAFDICT-ND | https://www.digikey.com/product-detail/en/diodes-incorporated/PAM8301AAF/PAM8301AAFDICT-ND/8283873 | - | https://www.digikey.com/products/en/integrated-circuits-ics/linear-amplifiers-audio/742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
U205 | PCMF2HDMI2SZ | dvk-mx8m-bsb:PCMF2HDMI2S | https://assets.nexperia.com/documents/data-sheet/PCMFXHDMI2S_SER.pdf
U1902 | PCMF2HDMI2SZ | dvk-mx8m-bsb:PCMF2HDMI2S | https://assets.nexperia.com/documents/data-sheet/PCMFXHDMI2S_SER.pdf
U204 | PCMF3HDMI2SZ | dvk-mx8m-bsb:PCMF3HDMI2S | https://assets.nexperia.com/documents/data-sheet/PCMFXHDMI2S_SER.pdf
U1901 | PCMF3HDMI2SZ | dvk-mx8m-bsb:PCMF3HDMI2S | https://assets.nexperia.com/documents/data-sheet/PCMFXHDMI2S_SER.pdf
U202 | PTN36043BXY | dvk-mx8m-bsb:PTN36043 | https://www.nxp.com/docs/en/data-sheet/PTN36043.pdf
U201 | PTN5110HQZ | dvk-mx8m-bsb:PTN5110 | https://www.nxp.com/docs/en/data-sheet/PTN5110_SDS.pdf
U401 | RT8070 | dvk-mx8m-bsb:RT8070 | https://www.richtek.com/assets/product_file/RT8070/DS8070-08.pdf | Richtek | RT8070ZSP | 1028-1109-1-ND | https://www.digikey.com/product-detail/en/richtek-usa-inc/RT8070ZSP/1028-1109-1-ND/3078112 | - | https://octopart.com/search?q=RT8070&start=0
U601 | RV-4162-C7 | dvk-mx8m-bsb:RV-4162-C7 | http://www.microcrystal.com/images/_Product-Documentation/02_Oscillator_&_RTC_Modules/01_Datasheet/RV-4162-C7.pdf | Micro Crystal | RV-4162-C7 | 428-200007-MG01 | https://www.mouser.com/ProductDetail/Micro-Crystal/RV-4162-C7-32768kHz-20PPM-TA-QC | - | https://www.digikey.com/product-detail/en/intersil/ISL12057IUZ/ISL12057IUZ-ND/2096552
U2201 | SEC1110 | dvk-mx8m-bsb:SEC1110 | http://ww1.microchip.com/downloads/en/DeviceDoc/00001561C.pdf
U1601 | SGTL5000 | dvk-mx8m-bsb:SGTL5000XNLA3R2 | https://www.nxp.com/docs/en/data-sheet/SGTL5000.pdf | NXP | SGTL5000XNLA3R2 | 568-13255-1-ND | https://www.digikey.com/product-detail/en/nxp-usa-inc/SGTL5000XNLA3R2/568-13255-1-ND/6576159 | - | https://www.digikey.com/products/en/integrated-circuits-ics/interface-codecs/716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
U203 | TLV3201AIDBVR | dvk-mx8m-bsb:TLV3201AIDBVR | http://www.ti.com/lit/ds/symlink/tlv3201.pdf | Texas Instruments | TLV3201AIDBVR | TLV3201AIDBVR | https://store.ti.com/TLV3201AIDBVR.aspx | - | https://octopart.com/search?q=TLV3201AIDBVR&start=0
U1101 | TXB0101 | dvk-mx8m-bsb:TXB0101DCKR | http://www.ti.com/lit/ds/symlink/txb0101.pdf | Texas Instruments | TXB0101DCKR | TXB0101DCKR | https://www.rocelec.com/part/textistxb0101dckr | - | http://www.digipart.com/part/TXB0101DCKR
U1302 | TXB0101 | dvk-mx8m-bsb:TXB0101DCKR | http://www.ti.com/lit/ds/symlink/txb0101.pdf | Texas Instruments | TXB0101DCKR | TXB0101DCKR | https://www.rocelec.com/part/textistxb0101dckr | - | http://www.digipart.com/part/TXB0101DCKR
U2001 | VCNL4040 | dvk-mx8m-bsb:VCNL4040 | http://www.vishay.com/docs/84274/vcnl4040.pdf | Vishay | VCNL4040M3OE-H5 | VCNL4040M3OE-H5 | EBV | - | https://octopart.com/search?q=VCNL4040&start=0
Y901 | 12MHz | dvk-mx8m-bsb:Crystal_12MHz | http://www.ecsxtal.com/store/pdf/ECX-2236.pdf | ECS | ECS-120-12-36-AGN-TR | ECS-120-12-36-AGN-TR | https://www.arrow.com/en/products/ecs-120-12-36-agn-tr/ecs-international | 25ppm | https://www.digikey.com/products/en/crystals-oscillators-resonators/crystals/171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
Y1701 | 25MHz | dvk-mx8m-bsb:Crystal_25MHz | https://www.ctscorp.com/wp-content/uploads/403.pdf | CTS-Frequency Controls | 403C35D25M00000 | 403C35D25M00000 | https://www.arrow.com/en/products/403c35d25m00000/cts | - | https://octopart.com/search?q=403C35D25M00000&start=0
