gralco/dvk-mx8m-bsb/dvk-som-pinout.ods

SOM pin | Pin Name | Ball name | PAD TYPE | Alt0 | Alt1 | Alt2 | Alt3 | Alt4 | Alt5 | Alt6 | Alt7
P3.03 | BOOT_MODE0 | W6 | GPIO | ccmsrcgpcmix.BOOT_MODE[0]
P3.05 | BOOT_MODE1 | V6 | GPIO | ccmsrcgpcmix.BOOT_MODE[1]
P3.11 | JTAG_TRST_B | U6 | GPIO | cjtag_wrapper.TRST_B
P3.07 | JTAG_TDI | W5 | GPIO | cjtag_wrapper.TDI
P3.09 | JTAG_TMS | V5 | GPIO | cjtag_wrapper.TMS
P3.15 | JTAG_TCK | T5 | GPIO | cjtag_wrapper.TCK
P3.13 | JTAG_TDO | U5 | GPIO | cjtag_wrapper.TDO
P4.13 | ONOFF | W21 | GPIO | snvsmix.ONOFF
P4.41 | POR_B | W20 | GPIO | snvsmix.POR_B
P3.19 | NC (was GPIO1_IO00) | T6 | GPIO | gpio1.IO[0] | ccmsrcgpcmix.ENET_PHY_REF_CLK_ROOT |  |  |  | anamix.REF_CLK_32K | ccmsrcgpcmix.EXT_CLK1 | sjc.FAIL
P3.21 | DSI_BL_PWM (GPIO1_IO01) | T7 | GPIO | gpio1.IO[1] | pwm1.OUT |  |  |  | anamix.REF_CLK_24M | ccmsrcgpcmix.EXT_CLK2 | sjc.ACTIVE
P3.23 | nWDG (GPIO1_IO02) | R4 | GPIO | gpio1.IO[2] | wdog1.WDOG_B |  |  |  | wdog1.WDOG_ANY |  | sjc.DE_B
P3.31 | NC (was GPIO1_IO04SD2_VSELECT) | P5 | GPIO | gpio1.IO[4] | usdhc2.VSELECT |  |  |  | sdma1.EXT_EVENT[1] | anamix.xtal_ok_lv | usdhc1.TEST_TRIG
P3.33 | CAPTOUCH_nRST (was GPIO1_IO05/CSI_P2_PWDN) | P7 | GPIO | gpio1.IO[5] | m4.NMI |  |  |  | ccmsrcgpcmix.PMIC_READY | ccmsrcgpcmix.INT_BOOT | usdhc2.TEST_TRIG
P3.37 | CSI_nRST (GPIO1_IO06) | N5 | GPIO | gpio1.IO[6] | enet1.MDC |  |  |  | usdhc1.CD_B | ccmsrcgpcmix.EXT_CLK3 | ecspi1.TEST_TRIG
P3.29 | CSI_PWDN (GPIO1_IO07) | N6 | GPIO | gpio1.IO[7] | enet1.MDIO |  |  |  | usdhc1.WP | ccmsrcgpcmix.EXT_CLK4 | ecspi2.TEST_TRIG
P3.41 | PWR_EN (GPIO1_IO08) | N7 | GPIO | gpio1.IO[8] | enet1.1588_EVENT0_IN |  |  |  | usdhc2.RESET_B | ccmsrcgpcmix.WAIT | qspi.TEST_TRIG
P3.45 | ENET_nRST (GPIO1_IO09) | M6 | GPIO | gpio1.IO[9] | enet1.1588_EVENT0_OUT |  |  |  | sdma2.EXT_EVENT[0] | ccmsrcgpcmix.STOP | rawnand.TEST_TRIG
P3.42 | ENET_WoL (GPIO1_IO10) | M7 | GPIO | gpio1.IO[10] | usb1.OTG_ID |  |  |  |  |  | ocotp_ctrl_wrapper.FUSE_LATCHED
P3.48 | ENET_nINT (GPIO1_IO11) | L6 | GPIO | gpio1.IO[11] | usb2.OTG_ID |  |  |  | ccmsrcgpcmix.PMIC_READY | ccmsrcgpcmix.OUT0 | caam_wrapper.RNG_OSC_OBS
P3.57 | PROX_nINT (was GPIO1_IO12/IR_CAP) | L7 | GPIO | gpio1.IO[12] | usb1.OTG_PWR |  |  |  | sdma2.EXT_EVENT[1] | ccmsrcgpcmix.OUT1 | csu.CSU_ALARM_AUT[0]
P3.63 | LED (GPIO1_IO13/LED2) | K6 | GPIO | gpio1.IO[13] | usb1.OTG_OC |  |  |  | pwm2.OUT | ccmsrcgpcmix.OUT2 | csu.CSU_ALARM_AUT[1]
P3.70 | CLKO1 (GPIO1_IO14) | K7 | GPIO | gpio1.IO[14] | usb2.OTG_PWR |  |  |  | pwm3.OUT | ccmsrcgpcmix.CLKO1 | csu.CSU_ALARM_AUT[2]
P3.62 | CLKO2 (GPIO1_IO15) | J6 | GPIO | gpio1.IO[15] | usb2.OTG_OC |  |  |  | pwm4.OUT | ccmsrcgpcmix.CLKO2 | csu.CSU_INT_DEB
P1.42 | ENET_MDC | N20 | GPIO | enet1.MDC |  |  |  |  | gpio1.IO[16]
P1.40 | ENET_MDIO | N19 | GPIO | enet1.MDIO |  |  |  |  | gpio1.IO[17]
P1.14 | ENET_TD3 | P20 | GPIO | enet1.RGMII_TD3 |  |  |  |  | gpio1.IO[18]
P1.12 | ENET_TD2 | R19 | GPIO | enet1.RGMII_TD2 | INPUT=enet1.TX_CLK OUTPUT=ccmsrcgpcmix.ENET_REF_CLK_ROOT |  |  |  | gpio1.IO[19]
P1.10 | ENET_TD1 | R21 | GPIO | enet1.RGMII_TD1 |  |  |  |  | gpio1.IO[20]
P1.08 | ENET_TD0 | R20 | GPIO | enet1.RGMII_TD0 |  |  |  |  | gpio1.IO[21]
P1.18 | ENET_TX_CTL | P19 | GPIO | enet1.RGMII_TX_CTL |  |  |  |  | gpio1.IO[22]
P1.04 | ENET_TXC | T19 | GPIO | enet1.RGMII_TXC | enet1.TX_ER |  |  |  | gpio1.IO[23]
P1.32 | ENET_RX_CTL | T21 | GPIO | enet1.RGMII_RX_CTL |  |  |  |  | gpio1.IO[24]
P1.36 | ENET_RXC | T20 | GPIO | enet1.RGMII_RXC | enet1.RX_ER |  |  |  | gpio1.IO[25]
P1.28 | ENET_RD0 | U19 | GPIO | enet1.RGMII_RD0 |  |  |  |  | gpio1.IO[26]
P1.26 | ENET_RD1 | U21 | GPIO | enet1.RGMII_RD1 |  |  |  |  | gpio1.IO[27]
P1.24 | ENET_RD2 | U20 | GPIO | enet1.RGMII_RD2 |  |  |  |  | gpio1.IO[28]
P1.22 | ENET_RD3 | V19 | GPIO | enet1.RGMII_RD3 |  |  |  |  | gpio1.IO[29]
P1.60 | NC (was SD2_CD_B) | L21 | GPIO | usdhc2.CD_B |  |  |  |  | gpio2.IO[12]
P1.64 | SD2_CLK - WiFi | L22 | GPIO | usdhc2.CLK |  |  |  |  | gpio2.IO[13] | ccmsrcgpcmix.OBSERVE0 | observe_mux.OUT[0]
P1.58 | SD2_CMD - WiFi | M22 | GPIO | usdhc2.CMD |  |  |  |  | gpio2.IO[14] | ccmsrcgpcmix.OBSERVE1 | observe_mux.OUT[1]
P1.54 | SD2_DATA0 - WiFi | N22 | GPIO | usdhc2.DATA0 |  |  |  |  | gpio2.IO[15] | ccmsrcgpcmix.OBSERVE2 | observe_mux.OUT[2]
P1.52 | SD2_DATA1 - WiFi | N21 | GPIO | usdhc2.DATA1 |  |  |  |  | gpio2.IO[16] | ccmsrcgpcmix.WAIT | observe_mux.OUT[3]
P1.50 | SD2_DATA2 - WiFi | P22 | GPIO | usdhc2.DATA2 |  |  |  |  | gpio2.IO[17] | ccmsrcgpcmix.STOP | observe_mux.OUT[4]
P1.48 | SD2_DATA3 - WiFi | P21 | GPIO | usdhc2.DATA3 |  |  |  |  | gpio2.IO[18] | ccmsrcgpcmix.EARLY_RESET
P1.46 | WiFi_nRST/SD2_RESET_B | R22 | GPIO | usdhc2.RESET_B |  |  |  |  | gpio2.IO[19] | ccmsrcgpcmix.SYSTEM_RESET
P1.56 | WIFI_WAKE (was SD_WAKE/SD2_WP) | M21 | GPIO | usdhc2.WP |  |  |  |  | gpio2.IO[20] |  | sim_m.HMASTLOCK
P2.10 | CAPTOUCH_nINT (NAND_ALE/DSI_TS_nINT) | G19 | GPIO | rawnand.ALE | qspi.A_SCLK |  |  |  | gpio3.IO[0] |  | sim_m.HPROT[0]
P1.65 | TCPC_nINT (NAND_CE0_B) | H19 | GPIO | rawnand.CE0_B | qspi.A_SS0_B |  |  |  | gpio3.IO[1] |  | sim_m.HPROT[1]
P2.06 | NC (was NAND_CE1_B) | G21 | GPIO | rawnand.CE1_B | qspi.A_SS1_B |  |  |  | gpio3.IO[2] |  | sim_m.HPROT[2]
P1.72 | nWWAN_DISABLE (was NAND_CE3_B/GPIO3_IO04) | H20 | GPIO | rawnand.CE3_B | qspi.B_SS1_B |  |  |  | gpio3.IO[4] |  | sim_m.HADDR[0]
P2.02 | nWIFI_DISABLE (NAND_CLE/PCIe_nDIS) | H21 | GPIO | rawnand.CLE | qspi.B_SCLK |  |  |  | gpio3.IO[5] |  | sim_m.HADDR[1]
P1.78 | BT_HOST_WAKE (NAND_DATA01) | J20 | GPIO | rawnand.DATA01 | qspi.A_DATA[1] |  |  |  | gpio3.IO[7] |  | sim_m.HADDR[3]
P2.08 | nWoWWAN (was NAND_DATA02/GPIO3_IO08) | H22 | GPIO | rawnand.DATA02 | qspi.A_DATA[2] |  |  |  | gpio3.IO[8] |  | sim_m.HADDR[4]
P2.04 | WWAN_RESET (was NAND_DATA03/GPIO3_IO09) | J21 | GPIO | rawnand.DATA03 | qspi.A_DATA[3] |  |  |  | gpio3.IO[9] |  | sim_m.HADDR[5]
P4.37 | nBT_DISABLE (NAND_DATA05/WL_EN) | J22 | GPIO | rawnand.DATA05 | qspi.B_DATA[1] |  |  |  | gpio3.IO[11] |  | sim_m.HADDR[7]
P1.74 | USB1_SS_SEL (NAND_DATA06) | L19 | GPIO | rawnand.DATA06 | qspi.B_DATA[2] |  |  |  | gpio3.IO[12] |  | sim_m.HADDR[8]
P1.80 | LCD_nRESET (NAND_DATA07/DSI_EN) | M19 | GPIO | rawnand.DATA07 | qspi.B_DATA[3] |  |  |  | gpio3.IO[13] |  | sim_m.HADDR[9]
P1.76 | NC (NAND_READY_B/PCIe_nWAKE) | K20 | GPIO | rawnand.READY_B |  |  |  |  | gpio3.IO[16] |  | sim_m.HADDR[12]
P2.12 | NC (was NAND_WE_B/PCIe_nRST) | K22 | GPIO | rawnand.WE_B |  |  |  |  | gpio3.IO[17] |  | sim_m.HADDR[13]
P4.17 | NC (was NAND_WP_B/PCIE2_nCLKREQ | K21 | GPIO | rawnand.WP_B |  |  |  |  | gpio3.IO[18] |  | sim_m.HADDR[14]
P3.35 | IMU_INT (was SAI5_RXFS/LED1) | N4 | GPIO | sai5.RX_SYNC | sai1.TX_DATA[0] |  |  |  | gpio3.IO[19]
P3.53 | HP_DET (was SAI5_RXC/GPIO3_IO20) | L5 | GPIO | sai5.RX_BCLK | sai1.TX_DATA[1] |  |  |  | gpio3.IO[20]
P3.43 | SAI5_RXD0 | M5 | GPIO | sai5.RX_DATA[0] | sai1.TX_DATA[2] |  |  |  | gpio3.IO[21]
P3.46 | SAI5_TX_SYNC (SAI5_RXD1) | L4 | GPIO | sai5.RX_DATA[1] | sai1.TX_DATA[3] | sai1.TX_SYNC | sai5.TX_SYNC |  | gpio3.IO[22]
P3.36 | SAI5_TX_BCLK (SAI5_RXD2) | M4 | GPIO | sai5.RX_DATA[2] | sai1.TX_DATA[4] | sai1.TX_SYNC | sai5.TX_BCLK |  | gpio3.IO[23]
P3.61 | SAI5_TXD (SAI5_RXD3) | K5 | GPIO | sai5.RX_DATA[3] | sai1.TX_DATA[5] | sai1.TX_SYNC | sai5.TX_DATA[0] |  | gpio3.IO[24]
P3.58 | CHRG_nINT (was SAI5_MCLK/GPIO3_IO25) | K4 | GPIO | sai5.MCLK | sai1.TX_BCLK | sai4.MCLK |  |  | gpio3.IO[25] | ccmsrcgpcmix.TESTER_ACK
P3.49 | NC (was SAI1_RXFS) | L1 | GPIO | sai1.RX_SYNC | sai5.RX_SYNC |  |  | coresight.TRACE_CLK | gpio4.IO[0] |  | sim_m.HADDR[15]
P3.54 | NC (was SAI1_RXC) | K1 | GPIO | sai1.RX_BCLK | sai5.RX_BCLK |  |  | coresight.TRACE_CTL | gpio4.IO[1] |  | sim_m.HADDR[16]
P3.59 | Unpurposed (was SAI1_RXD0) | K2 | GPIO | sai1.RX_DATA[0] | sai5.RX_DATA[0] |  |  | coresight.TRACE[0] | gpio4.IO[2] | ccmsrcgpcmix.BOOT_CFG[0] | sim_m.HADDR[17]
P3.44 | Unpurposed (was SAI1_RXD1) | L2 | GPIO | sai1.RX_DATA[1] | sai5.RX_DATA[1] |  |  | coresight.TRACE[1] | gpio4.IO[3] | ccmsrcgpcmix.BOOT_CFG[1] | sim_m.HADDR[18]
P3.73 | Unpurposed (was SAI1_RXD2) | H2 | GPIO | sai1.RX_DATA[2] | sai5.RX_DATA[2] |  |  | coresight.TRACE[2] | gpio4.IO[4] | ccmsrcgpcmix.BOOT_CFG[2] | sim_m.HADDR[19]
P3.67 | Unpurposed (was SAI1_RXD3) | J2 | GPIO | sai1.RX_DATA[3] | sai5.RX_DATA[3] |  |  | coresight.TRACE[3] | gpio4.IO[5] | ccmsrcgpcmix.BOOT_CFG[3] | sim_m.HADDR[20]
P3.65 | Unpurposed (was SAI1_RXD4) | J1 | GPIO | sai1.RX_DATA[4] | sai6.TX_BCLK | sai6.RX_BCLK |  | coresight.TRACE[4] | gpio4.IO[6] | ccmsrcgpcmix.BOOT_CFG[4] | sim_m.HADDR[21]
P4.07 | SAI6_RXD0 (was SAI1_RXD5/SAI6_RXDATA) | F1 | GPIO | sai1.RX_DATA[5] | sai6.TX_DATA[0] | sai6.RX_DATA[0] | sai1.RX_SYNC | coresight.TRACE[5] | gpio4.IO[7] | ccmsrcgpcmix.BOOT_CFG[5] | sim_m.HADDR[22]
P3.79 | SAI6_RXFS (was SAI1_RXD6/SAI6_TXSYNC) | G2 | GPIO | sai1.RX_DATA[6] | sai6.TX_SYNC | sai6.RX_SYNC |  | coresight.TRACE[6] | gpio4.IO[8] | ccmsrcgpcmix.BOOT_CFG[6] | sim_m.HADDR[23]
P4.02 | Unpurposed (was SAI1_RXD7) | G1 | GPIO | sai1.RX_DATA[7] | sai6.MCLK | sai1.TX_SYNC | sai1.TX_DATA[4] | coresight.TRACE[7] | gpio4.IO[9] | ccmsrcgpcmix.BOOT_CFG[7] | sim_m.HADDR[24]
P3.71 | NC (was SAI1_TXFS) | H1 | GPIO | sai1.TX_SYNC | sai5.TX_SYNC |  |  | coresight.EVENTO | gpio4.IO[10] |  | sim_m.HADDR[25]
P4.12 | NC (was SAI1_TXC) | E1 | GPIO | sai1.TX_BCLK | sai5.TX_BCLK |  |  | coresight.EVENTI | gpio4.IO[11] |  | sim_m.HADDR[26]
P4.11 | Unpurposed (was SAI1_TXD0) | F2 | GPIO | sai1.TX_DATA[0] | sai5.TX_DATA[0] |  |  | coresight.TRACE[8] | gpio4.IO[12] | ccmsrcgpcmix.BOOT_CFG[8] | sim_m.HADDR[27]
P4.19 | Unpurposed (was SAI1_TXD1) | E2 | GPIO | sai1.TX_DATA[1] | sai5.TX_DATA[1] |  |  | coresight.TRACE[9] | gpio4.IO[13] | ccmsrcgpcmix.BOOT_CFG[9] | sim_m.HADDR[28]
P4.47 | Unpurposed (was SAI1_TXD2) | B2 | GPIO | sai1.TX_DATA[2] | sai5.TX_DATA[2] |  |  | coresight.TRACE[10] | gpio4.IO[14] | ccmsrcgpcmix.BOOT_CFG[10] | sim_m.HADDR[29]
P4.27 | Unpurposed (was SAI1_TXD3) | D1 | GPIO | sai1.TX_DATA[3] | sai5.TX_DATA[3] |  |  | coresight.TRACE[11] | gpio4.IO[15] | ccmsrcgpcmix.BOOT_CFG[11] | sim_m.HADDR[30]
P4.29 | SAI6_RXC (was SAI1_TXD4) | D2 | GPIO | sai1.TX_DATA[4] | sai6.RX_BCLK | sai6.TX_BCLK |  | coresight.TRACE[12] | gpio4.IO[16] | ccmsrcgpcmix.BOOT_CFG[12] | sim_m.HADDR[31]
P4.39 | SAI6_TXD0 (was SAI1_TXD5/SAI6_TXDATA) | C2 | GPIO | sai1.TX_DATA[5] | sai6.RX_DATA[0] | sai6.TX_DATA[0] |  | coresight.TRACE[13] | gpio4.IO[17] | ccmsrcgpcmix.BOOT_CFG[13] | sim_m.HBURST[0]
P4.49 | Unpurposed (was SAI1_TXD6) | B3 | GPIO | sai1.TX_DATA[6] | sai6.RX_SYNC | sai6.TX_SYNC |  | coresight.TRACE[14] | gpio4.IO[18] | ccmsrcgpcmix.BOOT_CFG[14] | sim_m.HBURST[1]
P4.33 | Unpurposed (was SAI1_TXD7) | C1 | GPIO | sai1.TX_DATA[7] | sai6.MCLK |  |  | coresight.TRACE[15] | gpio4.IO[19] | ccmsrcgpcmix.BOOT_CFG[15] | sim_m.HBURST[2]
P4.61 | NC (was SAI1_MCLK) | A3 | GPIO | sai1.MCLK | sai5.MCLK | sai1.TX_BCLK |  |  | gpio4.IO[20] |  | sim_m.HRESP
P3.69 | BTN1/SW_VOLUP (SAI2_RXFS) | J4 | GPIO | sai2.RX_SYNC | sai5.TX_SYNC |  |  |  | gpio4.IO[21] |  | sim_m.HSIZE[0]
P3.74 | BTN2/SW_VOLDN (SAI2_RXC) | H3 | GPIO | sai2.RX_BCLK | sai5.TX_BCLK |  |  |  | gpio4.IO[22] |  | sim_m.HSIZE[1]
P3.77 | SAI2_RXD | H6 | GPIO | sai2.RX_DATA[0] | sai5.TX_DATA[0] |  |  |  | gpio4.IO[23] |  | sim_m.HSIZE[2]
P3.75 | SAI2_TXFS | H4 | GPIO | sai2.TX_SYNC | sai5.TX_DATA[1] |  |  |  | gpio4.IO[24] |  | sim_m.HWRITE
P3.66 | SAI2_TXC | J5 | GPIO | sai2.TX_BCLK | sai5.TX_DATA[2] |  |  |  | gpio4.IO[25] |  | sim_m.HREADYOUT
P4.01 | SAI2_TXD | G5 | GPIO | sai2.TX_DATA[0] | sai5.TX_DATA[3] |  |  |  | gpio4.IO[26] |  | tpsmp.CLK
P3.78 | SAI2_MCLK | H5 | GPIO | sai2.MCLK | sai5.MCLK |  |  |  | gpio4.IO[27] |  | tpsmp.HDATA_DIR
P4.08 | nIRQ (SAI3_RXC) | F4 | GPIO | sai3.RX_BCLK | gpt1.CAPTURE2 | sai5.RX_BCLK |  |  | gpio4.IO[29] |  | tpsmp.HTRANS[1]
P4.03 | nMUTE (was SPDIF_TX) | F6 | GPIO | spdif1.OUT | pwm3.OUT |  |  |  | gpio5.IO[3] |  | tpsmp.HDATA[5]
P4.05 | nHAPTIC (was SPDIF_RX) | G6 | GPIO | spdif1.IN | pwm2.OUT |  |  |  | gpio5.IO[4] |  | tpsmp.HDATA[6]
P4.16 | MIC_SEL (was SPDIF_EXT_CLK) | E6 | GPIO | spdif1.EXT_CLK | pwm1.OUT |  |  |  | gpio5.IO[5] |  | tpsmp.HDATA[7]
P4.26 | ECSPI1_SCLK | D5 | GPIO | ecspi1.SCLK | uart3.RX |  |  |  | gpio5.IO[6] |  | tpsmp.HDATA[8]
P4.65 | ECSPI1_MOSI | A4 | GPIO | ecspi1.MOSI | uart3.TX |  |  |  | gpio5.IO[7] |  | tpsmp.HDATA[9]
P4.51 | ECSPI1_MISO | B4 | GPIO | ecspi1.MISO | uart3.CTS_B |  |  |  | gpio5.IO[8] |  | tpsmp.HDATA[10]
P4.30 | ECSPI1_SS0 | D4 | GPIO | ecspi1.SS0 | uart3.RTS_B |  |  |  | gpio5.IO[9] |  | tpsmp.HDATA[11]
P4.42 | UART4_RXD (was ECSPI2_SCLK) | C5 | GPIO | ecspi2.SCLK | uart4.RX |  |  |  | gpio5.IO[10] |  | tpsmp.HDATA[12]
P4.22 | UART4_TXD (was ECSPI2_MOSI) | E5 | GPIO | ecspi2.MOSI | uart4.TX |  |  |  | gpio5.IO[11] |  | tpsmp.HDATA[13]
P4.53 | UART4_CTS (was ECSPI2_MISO) | B5 | GPIO | ecspi2.MISO | uart4.CTS_B |  |  |  | gpio5.IO[12] |  | tpsmp.HDATA[14]
P4.67 | UART4_RTS (was ECSPI2_SS0) | A5 | GPIO | ecspi2.SS0 | uart4.RTS_B |  |  |  | gpio5.IO[13] |  | tpsmp.HDATA[15]
P4.23 | I2C1_SCL | E7 | GPIO | i2c1.SCL | enet1.MDC |  |  |  | gpio5.IO[14] |  | tpsmp.HDATA[16]
P4.25 | I2C1_SDA | E8 | GPIO | i2c1.SDA | enet1.MDIO |  |  |  | gpio5.IO[15] |  | tpsmp.HDATA[17]
P4.04 | I2C2_SCL | G7 | GPIO | i2c2.SCL | enet1.1588_EVENT1_IN |  |  |  | gpio5.IO[16] |  | tpsmp.HDATA[18]
P4.15 | I2C2_SDA | F7 | GPIO | i2c2.SDA | enet1.1588_EVENT1_OUT |  |  |  | gpio5.IO[17] |  | tpsmp.HDATA[19]
P4.09 | I2C3_SCL | G8 | GPIO | i2c3.SCL | pwm4.OUT | gpt2.CLK |  |  | gpio5.IO[18] |  | tpsmp.HDATA[20]
P4.20 | I2C3_SDA | E9 | GPIO | i2c3.SDA | pwm3.OUT | gpt3.CLK |  |  | gpio5.IO[19] |  | tpsmp.HDATA[21]
P1.70 | NC (was I2C4_SCL) | F8 | GPIO | i2c4.SCL | pwm2.OUT | pcie1.CLKREQ_B |  |  | gpio5.IO[20] |  | tpsmp.HDATA[22]
P1.68 | NC (was I2C4_SDA) | F9 | GPIO | i2c4.SDA | pwm1.OUT | pcie2.CLKREQ_B |  |  | gpio5.IO[21] |  | tpsmp.HDATA[23]
P4.45 | UART1_RXD | C7 | GPIO | uart1.RX | ecspi3.SCLK |  |  |  | gpio5.IO[22] |  | tpsmp.HDATA[24]
P4.71 | UART1_TXD | A7 | GPIO | uart1.TX | ecspi3.MOSI |  |  |  | gpio5.IO[23] |  | tpsmp.HDATA[25]
P4.55 | UART3_RXD | A6 | GPIO | uart3.RX | uart1.CTS_B |  |  |  | gpio5.IO[26] |  | tpsmp.HDATA[28]
P4.35 | UART3_TXD | B7 | GPIO | uart3.TX | uart1.RTS_B |  |  |  | gpio5.IO[27] |  | tpsmp.HDATA[29]
P4.79 | USB1_ID | C14 | PHY
P4.77 | USB1_VBUS | D14 | PHY
P4.78 | USB1_DP | A14 | PHY
P4.76 | USB1_DN | B14 | PHY
P4.72 | USB1_TX_P | A13 | PHY
P4.70 | USB1_TX_N | B13 | PHY
P4.66 | USB1_RX_P | A12 | PHY
P4.64 | USB1_RX_N | B12 | PHY
P4.75 | USB2_ID | C9 | PHY
P4.73 | USB2_VBUS | D9 | PHY
P4.58 | USB2_DP | A10 | PHY
P4.56 | USB2_DN | B10 | PHY
P4.48 | NC (was USB2_TX_P) | A9 | PHY
P4.46 | NC (was USB2_TX_N) | B9 | PHY
P4.38 | NC (was USB2_RX_P) | A8 | PHY
P4.36 | NC (was USB2_RX_N) | B8 | PHY
P1.05 | NC (was PCIE2_REF_PAD_CLK_P) | F25 | PHY
P1.03 | NC (was PCIE2_REF_PAD_CLK_N) | F24 | PHY
P1.15 | NC (was PCIE2_TXN_P) | E25 | PHY
P1.13 | NC (was PCIE2_TXN_N) | E24 | PHY
P1.21 | NC (was PCIE2_RXN_N) | D24 | PHY
P1.23 | NC (was PCIE2_RXN_P) | D25 | PHY
P3.18 | HDMI_TX_P_LN_0 | T1 | PHY
P3.12 | HDMI_TX_P_LN_1 | U2 | PHY
P3.24 | HDMI_TX_P_LN_2 | N2 | PHY
P3.30 | HDMI_CLK_P (HDMI_TX_P_LN_3) | M1 | PHY
P3.20 | HDMI_TX_M_LN_0 | T2 | PHY
P3.14 | HDMI_TX_M_LN_1 | U1 | PHY
P3.26 | HDMI_TX_M_LN_2 | N1 | PHY
P3.32 | HDMI_CLK_N (HDMI_TX_M_LN_3) | M2 | PHY
P3.08 | HDMI_AUX_P | V1 | PHY
P3.06 | HDMI_AUX_N | V2 | PHY
P3.02 | HDMI_HPD | W2 | PHY
P3.27 | HDMI_DDC_SDA | P3 | PHY
P3.25 | HDMI_DDC_SCL | R3 | PHY
P3.01 | HDMI_CEC | W3 | PHY
P2.37 | MIPI_DSI_CLK_P | D16 | PHY
P2.39 | MIPI_DSI_CLK_N | C16 | PHY
P2.31 | MIPI_DSI_D0_P | B17 | PHY
P2.33 | MIPI_DSI_D0_N | A17 | PHY
P2.43 | MIPI_DSI_D1_P | B16 | PHY
P2.45 | MIPI_DSI_D1_N | A16 | PHY
P2.25 | MIPI_DSI_D2_P | B18 | PHY
P2.27 | MIPI_DSI_D2_N | A18 | PHY
P2.49 | MIPI_DSI_D3_P | B15 | PHY
P2.51 | MIPI_DSI_D3_N | A15 | PHY
P1.59 | MIPI_CSI1_CLK_P | B22 | PHY
P1.61 | MIPI_CSI1_CLK_N | A22 | PHY
P1.53 | MIPI_CSI1_D0_P | B23 | PHY
P1.55 | MIPI_CSI1_D0_N | A23 | PHY
P1.37 | MIPI_CSI1_D1_P | D22 | PHY
P1.39 | MIPI_CSI1_D1_N | C22 | PHY
P1.43 | NC (was MIPI_CSI1_D2_P) | C23 | PHY
P1.45 | NC (was MIPI_CSI1_D2_N) | B24 | PHY
P1.31 | NC (was MIPI_CSI1_D3_P) | D21 | PHY
P1.33 | NC (was MIPI_CSI1_D3_N) | C21 | PHY
P2.15 | NC (was MIPI_CSI2_CLK_P) | B19 | PHY
P2.17 | NC (was MIPI_CSI2_CLK_N) | A19 | PHY
P1.75 | NC (was MIPI_CSI2_D0_P) | D20 | PHY
P1.77 | NC (was MIPI_CSI2_D0_N) | C20 | PHY
P2.03 | NC (was MIPI_CSI2_D1_P) | B20 | PHY
P2.05 | NC (was MIPI_CSI2_D1_N) | A20 | PHY
P1.69 | NC (was MIPI_CSI2_D2_P) | B21 | PHY
P1.71 | NC (was MIPI_CSI2_D2_N) | A21 | PHY
P2.09 | NC (was MIPI_CSI2_D3_P) | D19 | PHY
P2.11 | NC (was MIPI_CSI2_D3_N) | C19 | PHY
P2.55 | NA |  | Power
P2.56 | NA |  | Power
P2.57 | NA |  | Power
P2.58 | NA |  | Power
P2.59 | NA |  | Power
P2.60 | NA |  | Power
P2.61 | NA |  | Power
P2.62 | NA |  | Power
P2.63 | NA |  | Power
P2.64 | NA |  | Power
P2.65 | NA |  | Power
P2.66 | NA |  | Power
P2.67 | NA |  | Power
P2.68 | NA |  | Power
P2.69 | NA |  | Power
P2.70 | NA |  | Power
P2.71 | NA |  | Power
P2.72 | NA |  | Power
P2.73 | NA |  | Power
P2.74 | NA |  | Power
P2.75 | NA |  | Power
P2.76 | NA |  | Power
P2.77 | NA |  | Power
P2.78 | NA |  | Power
P2.79 | NA |  | Power
P2.80 | NA |  | Power
P2.26 | NC (was VDD_SD2) |  | Power
P2.22 | NVCC_ENET |  | Power
P4.21 | Reset |  | Reset
P2.14 | VDD_3V3 |  | Power
P2.16 | VDD_3V3 |  | Power
P2.18 | VDD_3V3 |  | Power
P2.24 | 3V3_SNVS |  | Power
P1.01 | Ground |  | Ground
P1.02 | Ground |  | Ground
P1.06 | Ground |  | Ground
P1.07 | Ground |  | Ground
P1.11 | Ground |  | Ground
P1.16 | Ground |  | Ground
P1.17 | Ground |  | Ground
P1.19 | Ground |  | Ground
P1.20 | Ground |  | Ground
P1.25 | Ground |  | Ground
P1.29 | Ground |  | Ground
P1.30 | Ground |  | Ground
P1.34 | Ground |  | Ground
P1.35 | Ground |  | Ground
P1.38 | Ground |  | Ground
P1.41 | Ground |  | Ground
P1.44 | Ground |  | Ground
P1.47 | Ground |  | Ground
P1.51 | Ground |  | Ground
P1.57 | Ground |  | Ground
P1.62 | Ground |  | Ground
P1.63 | Ground |  | Ground
P1.66 | Ground |  | Ground
P1.67 | Ground |  | Ground
P1.73 | Ground |  | Ground
P1.79 | Ground |  | Ground
P2.01 | Ground |  | Ground
P2.07 | Ground |  | Ground
P2.13 | Ground |  | Ground
P2.19 | Ground |  | Ground
P2.23 | Ground |  | Ground
P2.28 | Ground |  | Ground
P2.29 | Ground |  | Ground
P2.30 | Ground |  | Ground
P2.32 | Ground |  | Ground
P2.34 | Ground |  | Ground
P2.35 | Ground |  | Ground
P2.36 | Ground |  | Ground
P2.38 | Ground |  | Ground
P2.40 | Ground |  | Ground
P2.41 | Ground |  | Ground
P2.42 | Ground |  | Ground
P2.44 | Ground |  | Ground
P2.46 | Ground |  | Ground
P2.47 | Ground |  | Ground
P2.48 | Ground |  | Ground
P2.50 | Ground |  | Ground
P2.52 | Ground |  | Ground
P2.53 | Ground |  | Ground
P2.54 | Ground |  | Ground
P3.04 | Ground |  | Ground
P3.10 | Ground |  | Ground
P3.16 | Ground |  | Ground
P3.17 | Ground |  | Ground
P3.22 | Ground |  | Ground
P3.28 | Ground |  | Ground
P3.34 | Ground |  | Ground
P3.38 | Ground |  | Ground
P3.47 | Ground |  | Ground
P3.51 | Ground |  | Ground
P3.52 | Ground |  | Ground
P3.55 | Ground |  | Ground
P3.56 | Ground |  | Ground
P3.60 | Ground |  | Ground
P3.64 | Ground |  | Ground
P3.68 | Ground |  | Ground
P3.72 | Ground |  | Ground
P3.76 | Ground |  | Ground
P3.80 | Ground |  | Ground
P4.06 | Ground |  | Ground
P4.10 | Ground |  | Ground
P4.14 | Ground |  | Ground
P4.18 | Ground |  | Ground
P4.24 | Ground |  | Ground
P4.28 | Ground |  | Ground
P4.34 | Ground |  | Ground
P4.40 | Ground |  | Ground
P4.44 | Ground |  | Ground
P4.50 | Ground |  | Ground
P4.54 | Ground |  | Ground
P4.59 | Ground |  | Ground
P4.60 | Ground |  | Ground
P4.62 | Ground |  | Ground
P4.63 | Ground |  | Ground
P4.68 | Ground |  | Ground
P4.74 | Ground |  | Ground
P4.80 | Ground |  | Ground
P1.09 | NA |  | NC
P1.27 | NA |  | NC
P1.49 | NA |  | NC
P2.20 | NA |  | NC
P2.21 | NA |  | NC
P3.39 | NA |  | NC
P3.40 | NA |  | NC
P3.50 | NA |  | NC
P4.31 | NA |  | NC
P4.32 | NA |  | NC
P4.43 | NA |  | NC
P4.52 | NA |  | NC
P4.57 | NA |  | NC
P4.69 | NA |  | NC
