gralco/dvk-mx8m-bsb/manufacturing/dvk-mx8m-bsb-fabrication.dxf

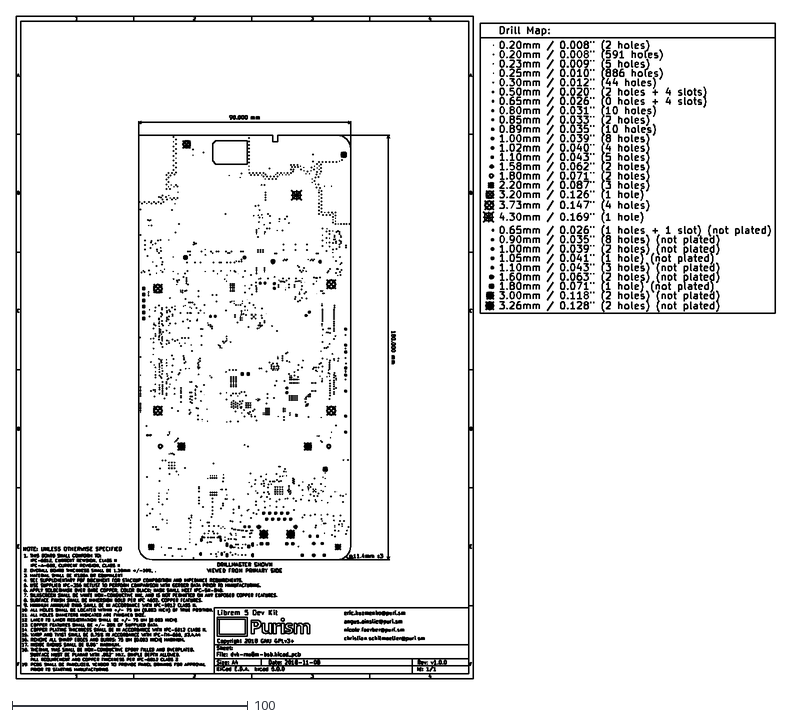
[picture p17: CAD file, 2019-05-21]
manufacturing/dvk-mx8m-bsb-fabrication.dxf
322.0 x 281.0
