gralco/dvk-mx8m-bsb/dvk-mx8m-bsb.pdf

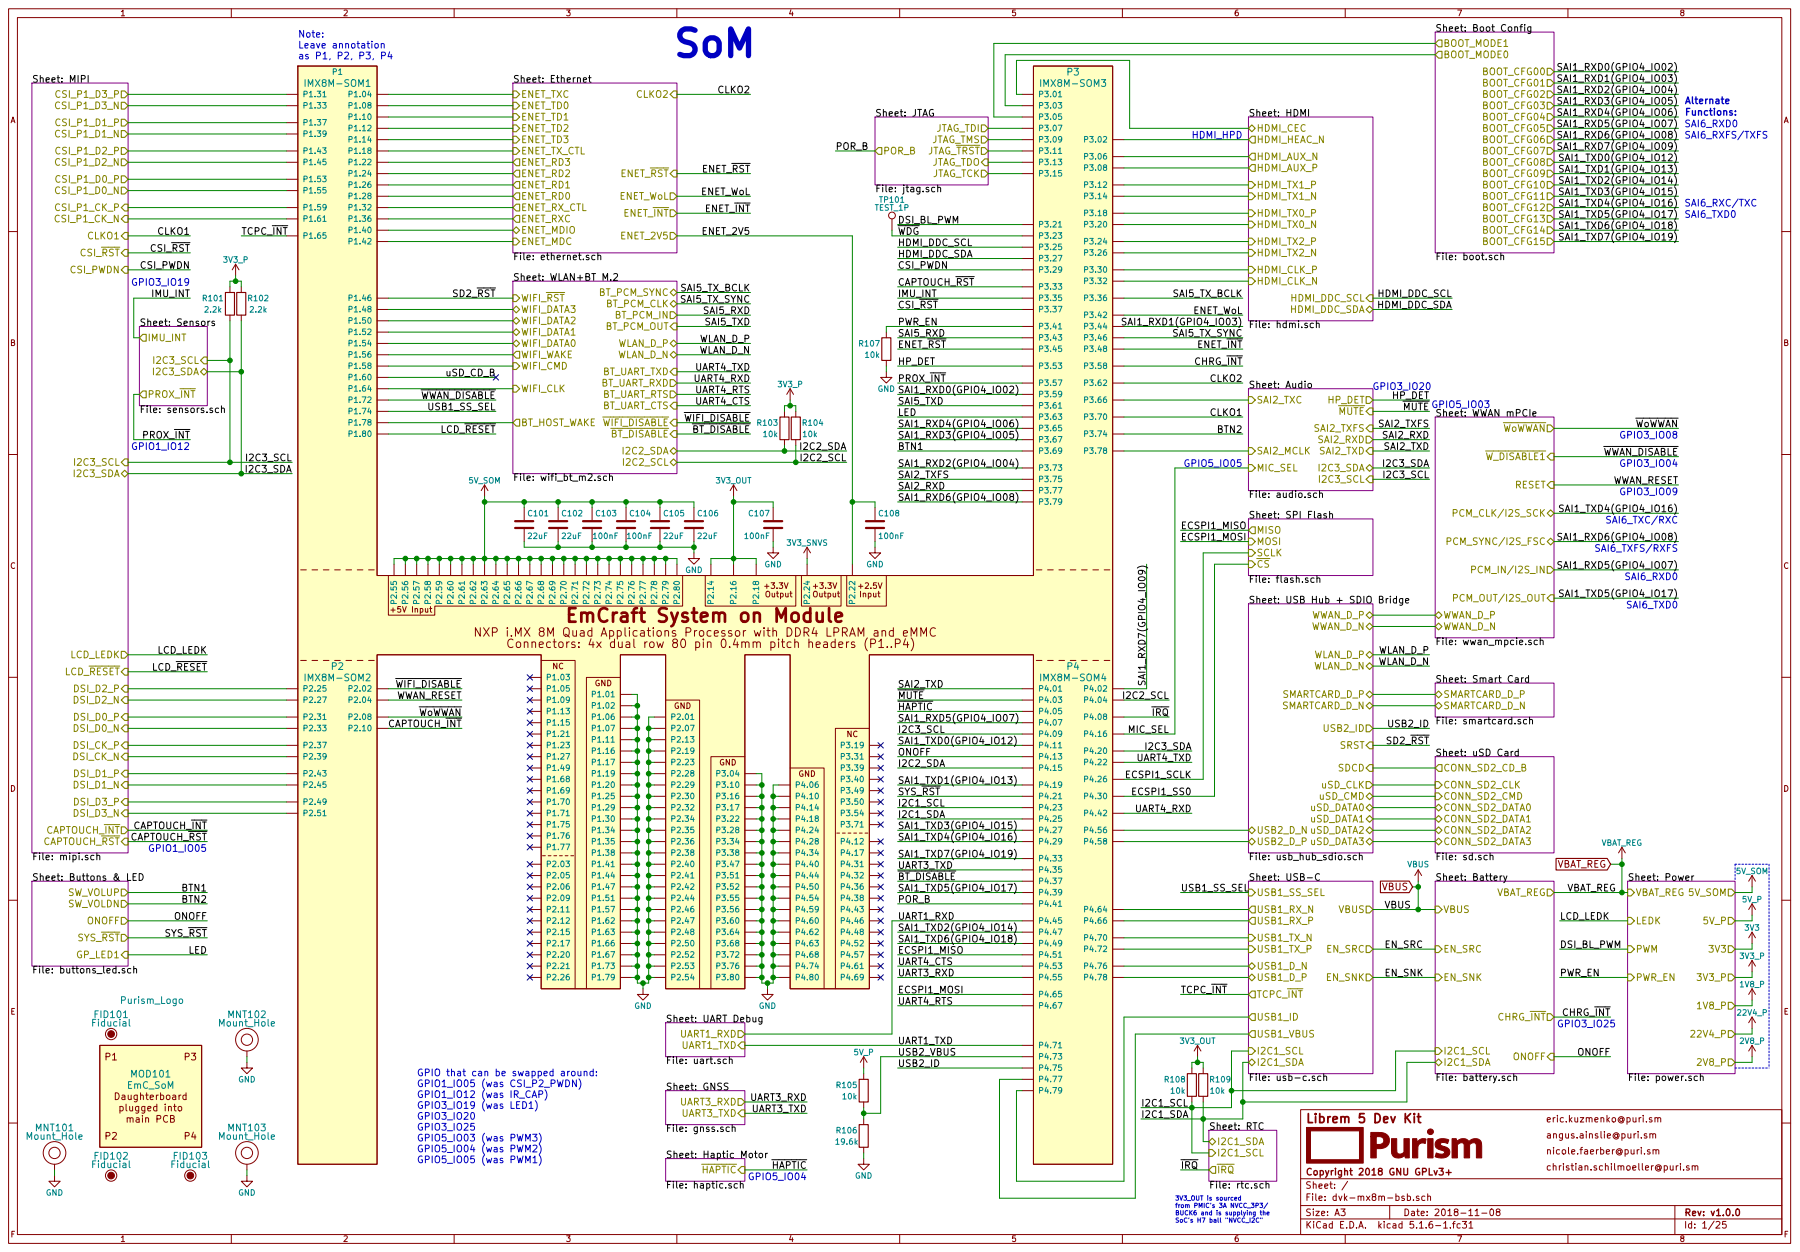
[picture p18: page 1]

Sheet: Sensors File: sensors.sch
IMU_INT

Sheet: Audio File: audio.sch SAI2_TXFS
SAI2_TXC

Sheet: SPI Flash File: flash.sch MOSI
MISO

Connectors: 4x dual row 80 pin 0.4mm pitch headers (P1..P4) | +3.3V | +3.3V | +2.5V

Sheet: USB Hub + SDIO Bridge

WWAN_D_P WWAN_D_N WLAN_D_P WLAN_D_N SMARTCARD_D_P SMARTCARD_D_N USB2_ID SRST SDCD uSD_CLK uSD_CMD uSD_DATA0 uSD_DATA1 uSD_DATA2 uSD_DATA3

NC NXP i.MX 8M Quad Applications Processor with DDR4 LPRAM and eMMC

Sheet: Smart Card File: smartcard.sch SMARTCARD_D_P

Sheet: UART Debug File: uart.sch UART1_TXD
UART1_RXD

eric.kuzmenko@puri.sm
angus.ainslie@puri.sm
nicole.faerber@puri.sm

3V3_OUT is sourced
from PMIC's 3A NVCC_3P3/ BUCK6 and is supplying the SoC's H7 ball "NVCC_I2C"

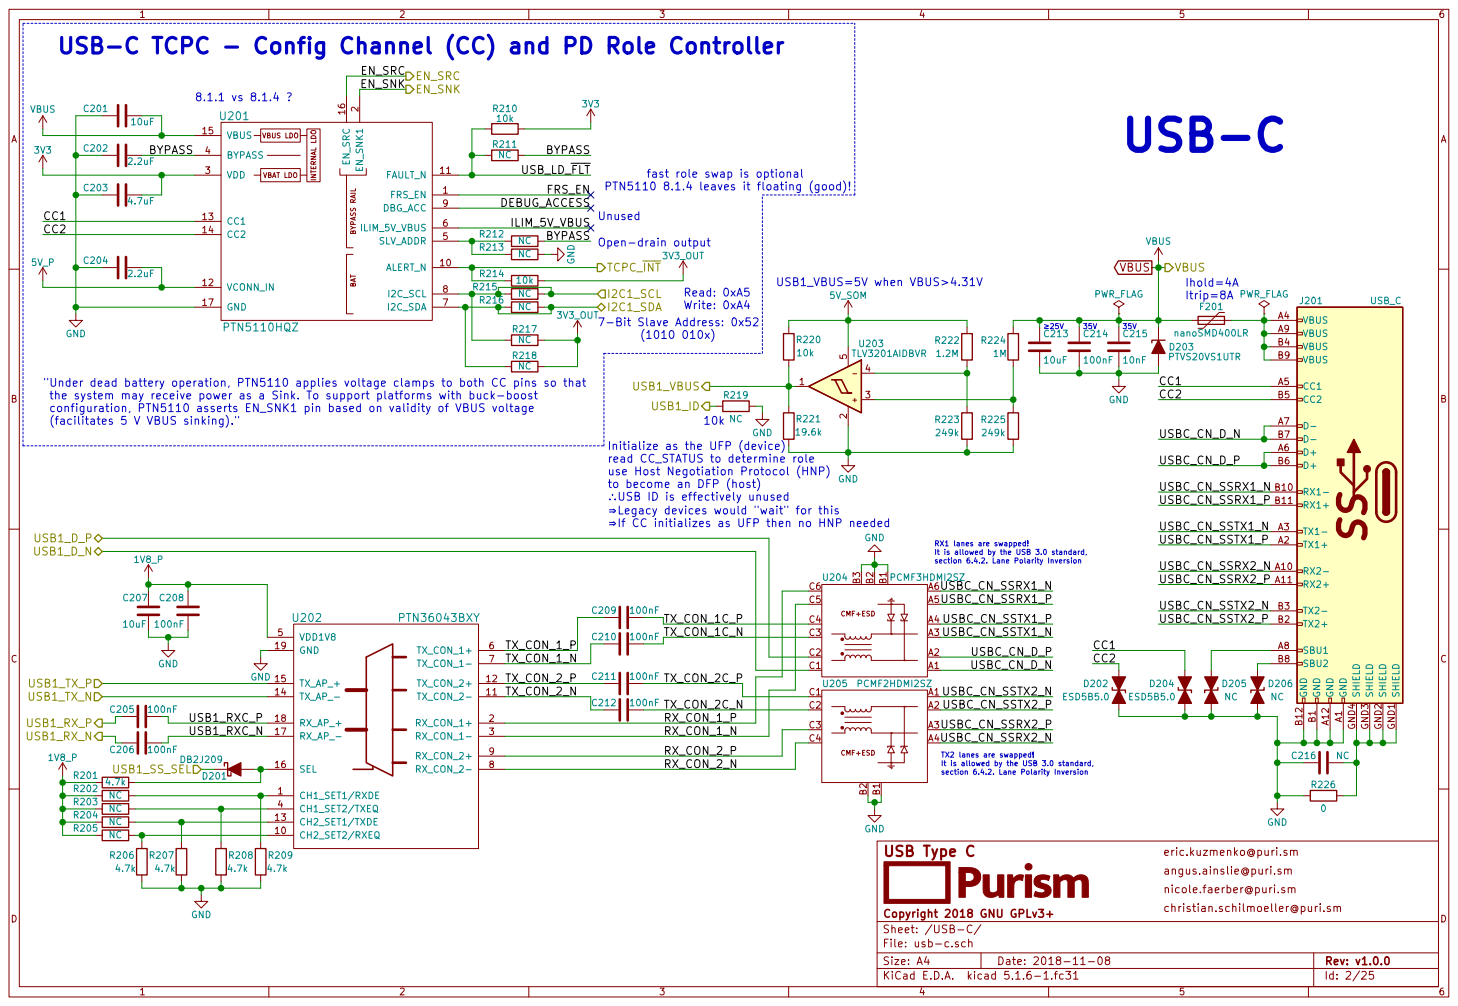
[picture p19: page 2]

fast role swap is optional
PTN5110 8.1.4 leaves it floating (good)!

"Under dead battery operation, PTN5110 applies voltage clamps to both CC pins so that
the system may receive power as a Sink. To support platforms with buck-boost
configuration, PTN5110 asserts EN_SNK1 pin based on validity of VBUS voltage
(facilitates 5 V VBUS sinking)."

10k Legacy devices would "wait" for this

Initialize as the UFP (device)
read CC_STATUS to determine role
use Host Negotiation Protocol (HNP)
to become an DFP (host)
USB ID is effectively unused

If CC initializes as UFP then no HNP needed

RX1 lanes are swapped!
It is allowed by the USB 3.0 standard, section 6.4.2. Lane Polarity Inversion TX2 lanes are swapped!

It is allowed by the USB 3.0 standard, section 6.4.2. Lane Polarity Inversion

eric.kuzmenko@puri.sm
angus.ainslie@puri.sm
nicole.faerber@puri.sm

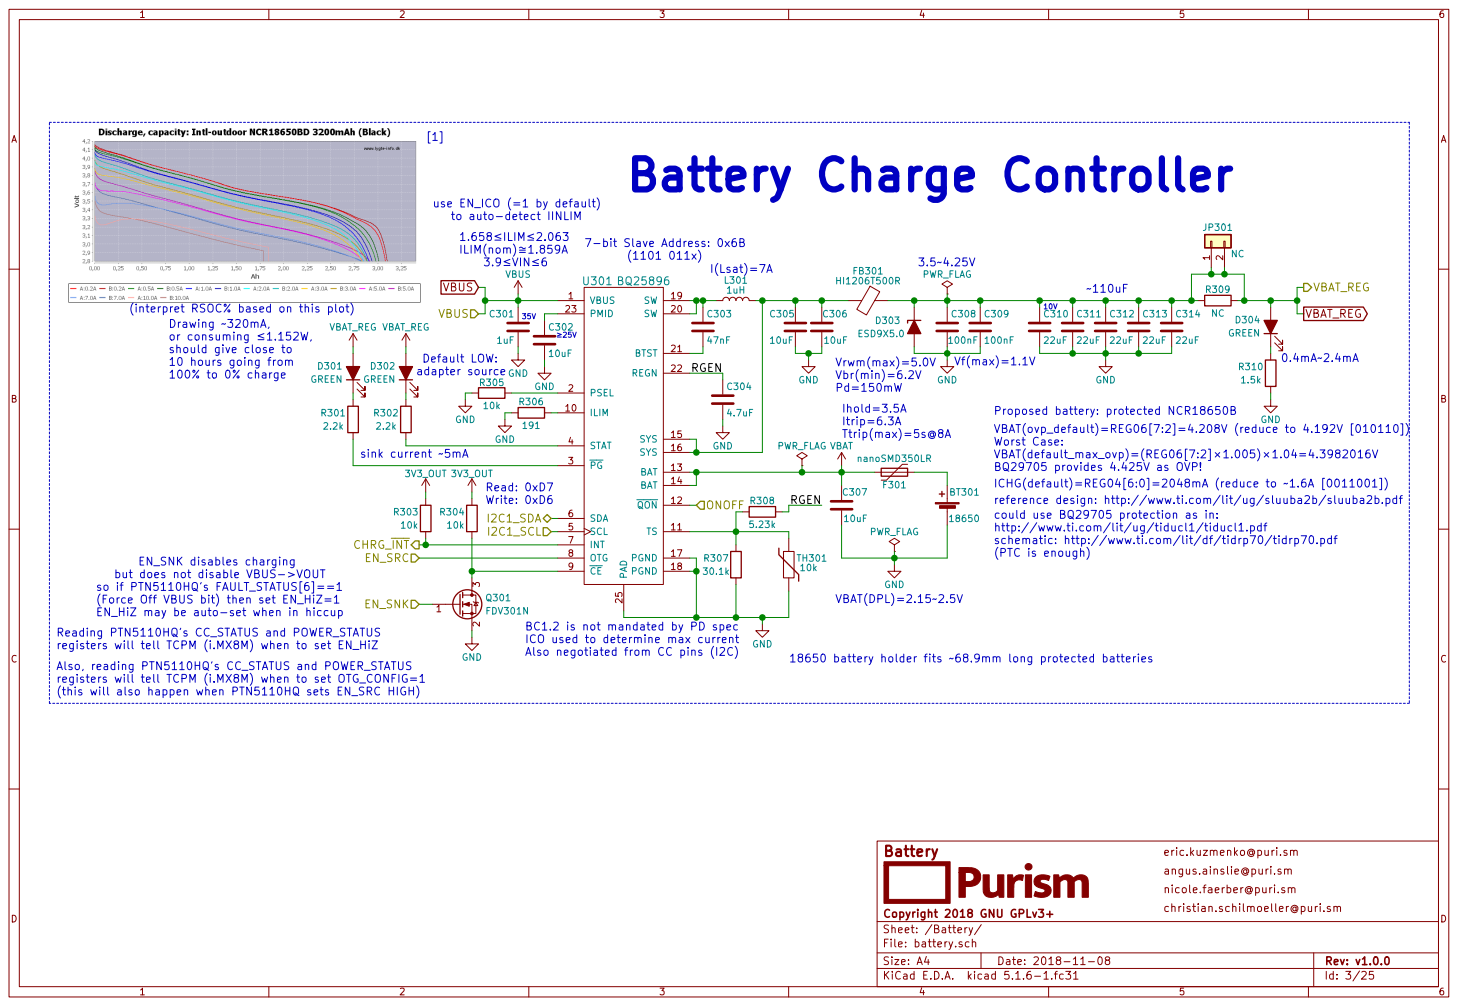
[picture p20: page 3]

18650 battery holder fits 68.9mm long protected batteries 3.54.25V
FB301 HI1206T500RGND

(interpret RSOC% based on this plot)

Drawing 320mA,
or consuming 1.152W,
should give close to
10 hours going from
100% to 0% charge

reference design: http://www.ti.com/lit/ug/sluuba2b/sluuba2b.pdf
could use BQ29705 protection as in:
http://www.ti.com/lit/ug/tiducl1/tiducl1.pdf
schematic: http://www.ti.com/lit/df/tidrp70/tidrp70.pdf

EN_SNK disables charging
but does not disable VBUS->VOUT
so if PTN5110HQ's FAULT_STATUS[6]==1
(Force Off VBUS bit) then set EN_HiZ=1
EN_HiZ may be auto-set when in hiccup

BC1.2 is not mandated by PD spec
ICO used to determine max current

Reading PTN5110HQ's CC_STATUS and POWER_STATUS
registers will tell TCPM (i.MX8M) when to set EN_HiZ
Also, reading PTN5110HQ's CC_STATUS and POWER_STATUS
registers will tell TCPM (i.MX8M) when to set OTG_CONFIG=1
(this will also happen when PTN5110HQ sets EN_SRC HIGH)

eric.kuzmenko@puri.sm
angus.ainslie@puri.sm
nicole.faerber@puri.sm
christian.schilmoeller@puri.sm

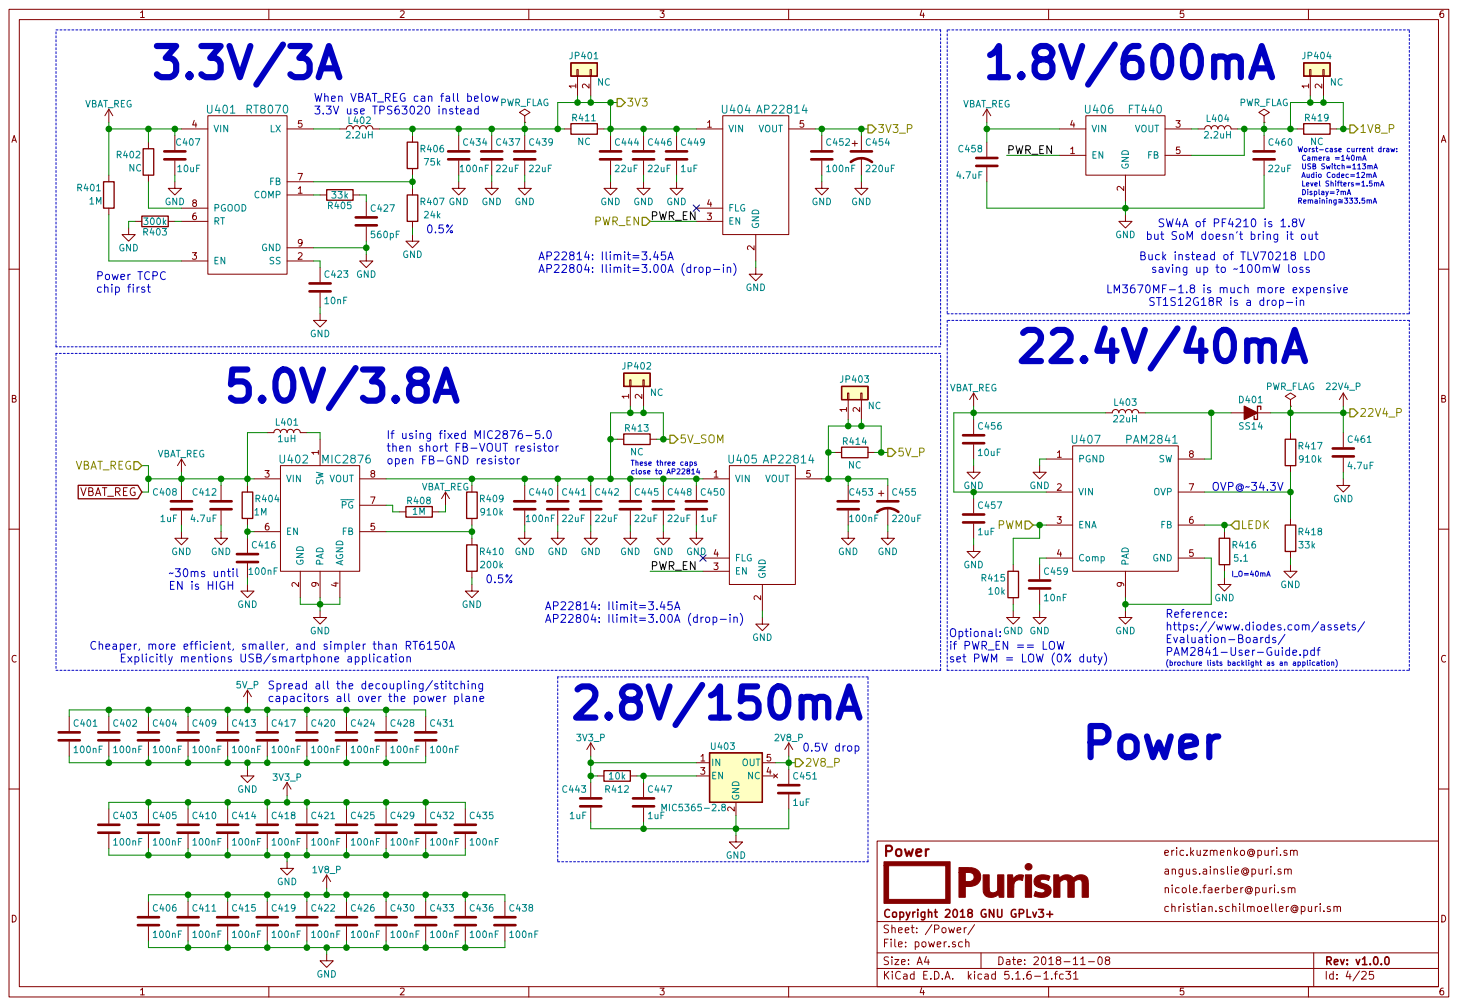
[picture p21: page 4]

When VBAT_REG can fall below
3.3V use TPS63020 instead

AP22804: Ilimit=3.00A (drop-in) AP22814: Ilimit=3.45A

I_O=40mA Buck instead of TLV70218 LDO
saving up to 100mW loss

Worst-case current draw:
Camera =140mA
USB Switch=113mA
Audio Codec=12mA
Level Shifters=1.5mA

2 EN 3 FLG 4 VOUT 5 U405 AP22814 GND GND GND GND
PWR_EN

but SoM doesn't bring it out
GND

LM3670MF-1.8 is much more expensive
ST1S12G18R is a drop-in

If using fixed MIC2876-5.0
then short FB-VOUT resistor
open FB-GND resistor

1 GND
close to AP22814 Spread all the decoupling/stitching

4 FB 5 EN 6 PG 7 VOUT 8 PAD

(brochure lists backlight as an application) OVP@34.3V

2 EN 3 NC 4 OUT 5 U403 MIC5365-2.8 GND

Optional:
if PWR_EN == LOW
set PWM = LOW (0% duty)
Power

Cheaper, more efficient, smaller, and simpler than RT6150A

capacitors all over the power plane

eric.kuzmenko@puri.sm
angus.ainslie@puri.sm
nicole.faerber@puri.sm

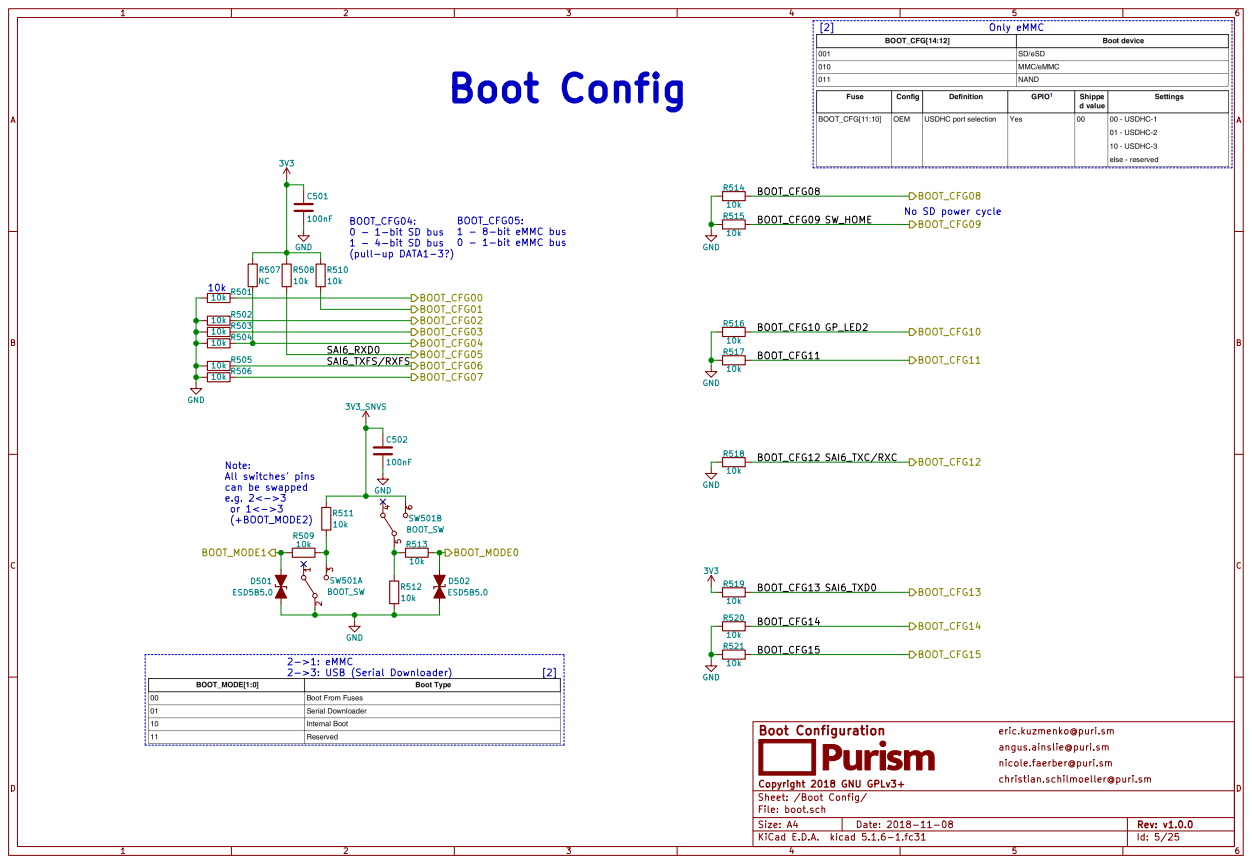
[picture p22: page 5]

Note: All switches' pins

eric.kuzmenko@puri.sm
angus.ainslie@puri.sm
nicole.faerber@puri.sm
christian.schilmoeller@puri.sm

File: boot.sch Sheet: /Boot Config/

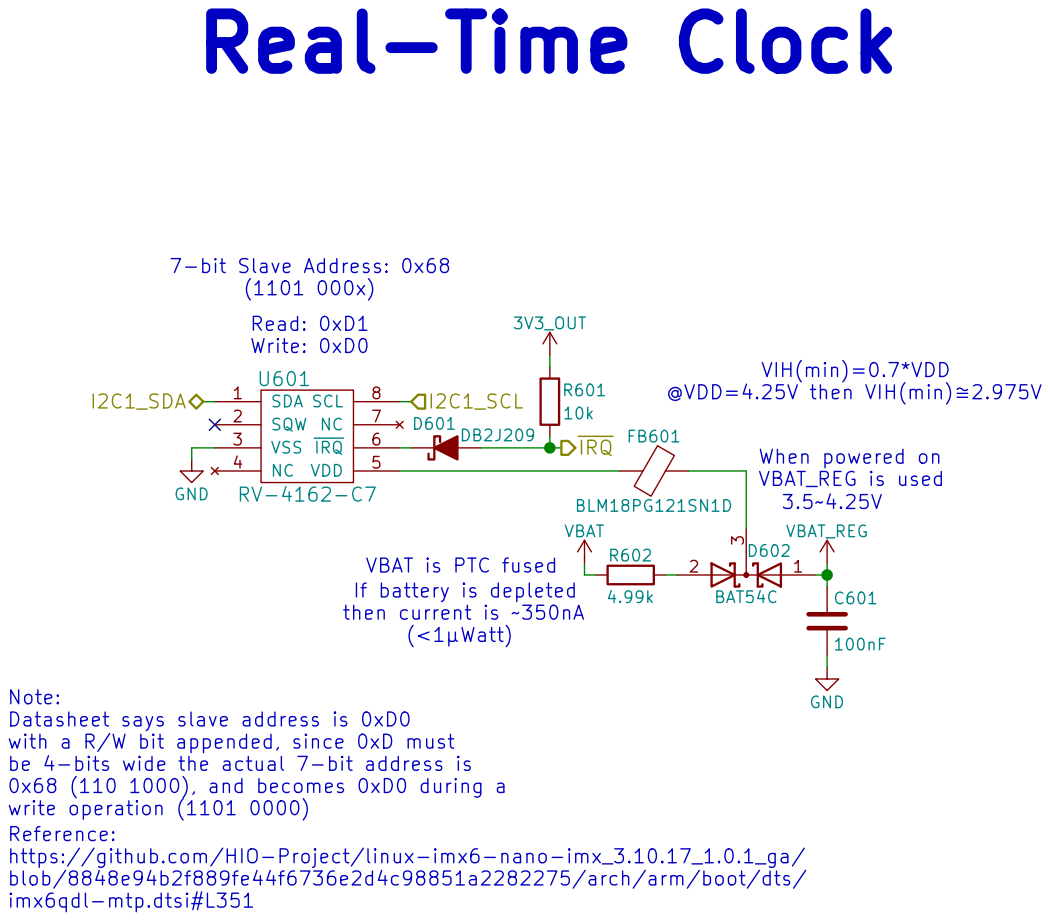
[picture p23: page 6]

(1101 000x) Read: 0xD1 Write: 0xD0 Note: Datasheet says slave address is 0xD0

VIH(min)=0.7*VDD
@VDD=4.25V then VIH(min)2.975V

VBAT is PTC fused
If battery is depleted
then current is 350nA
(<1µWatt)

with a R/W bit appended, since 0xD must be 4-bits wide the actual 7-bit address is 0x68 (110 1000), and becomes 0xD0 during a

write operation (1101 0000) Reference: https://github.com/HIO-Project/linux-imx6-nano-imx_3.10.17_1.0.1_ga/

blob/8848e94b2f889fe44f6736e2d4c98851a2282275/arch/arm/boot/dts/
imx6qdl-mtp.dtsi#L351

eric.kuzmenko@puri.sm
angus.ainslie@puri.sm
nicole.faerber@puri.sm

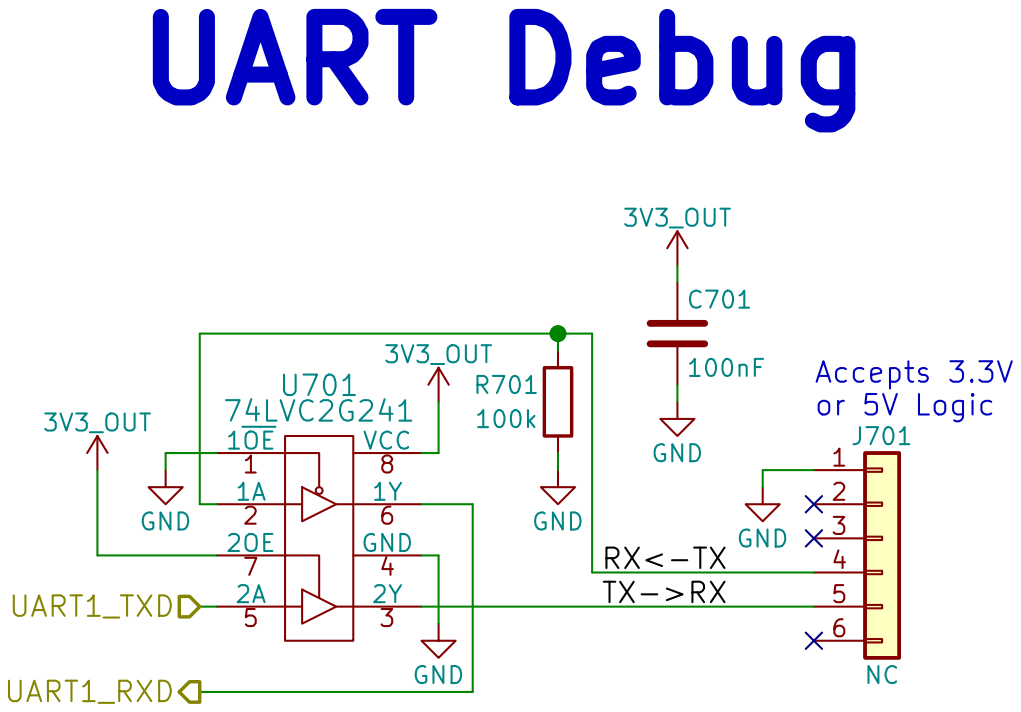
[picture p24: page 7]

eric.kuzmenko@puri.sm
angus.ainslie@puri.sm
nicole.faerber@puri.sm
christian.schilmoeller@puri.sm

Copyright 2018 GNU GPLv3+
File: uart.sch Sheet: /UART Debug/

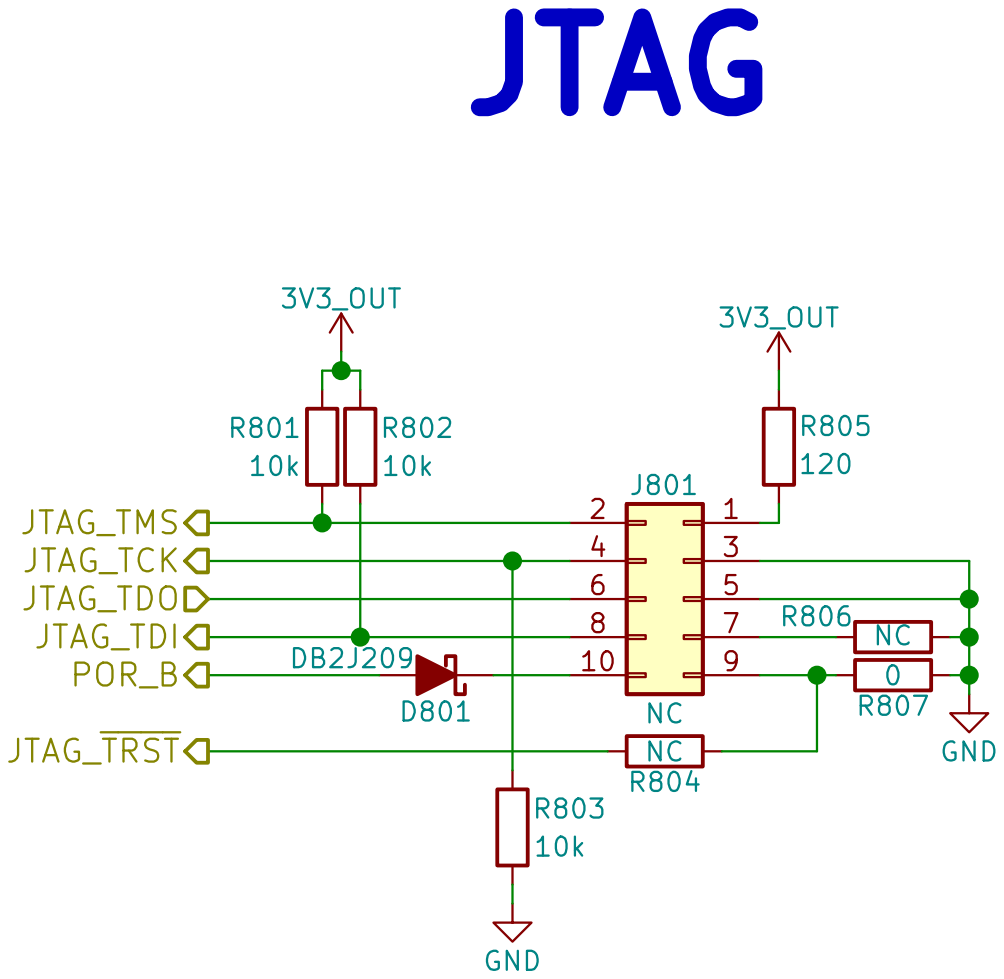
[picture p25: page 8]

eric.kuzmenko@puri.sm
angus.ainslie@puri.sm
nicole.faerber@puri.sm

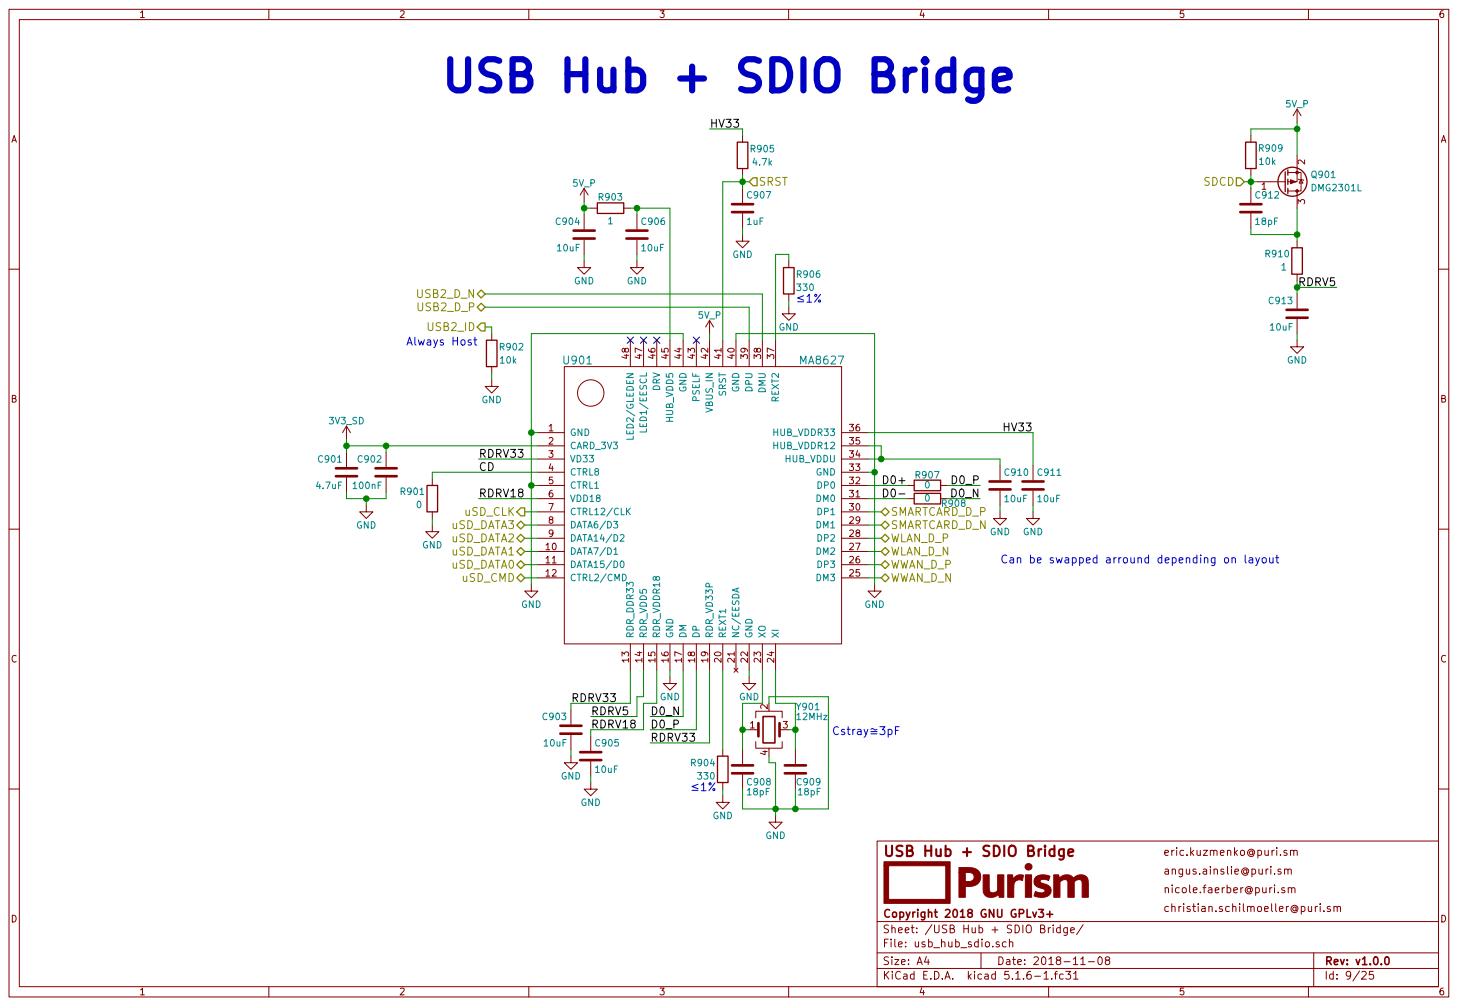
[picture p26: page 9]

USB Hub + SDIO Bridge

Can be swapped arround depending on layout

Id: 9/25 USB Hub + SDIO Bridge

eric.kuzmenko@puri.sm
angus.ainslie@puri.sm
nicole.faerber@puri.sm
christian.schilmoeller@puri.sm

Sheet: /USB Hub + SDIO Bridge/
File: usb_hub_sdio.sch

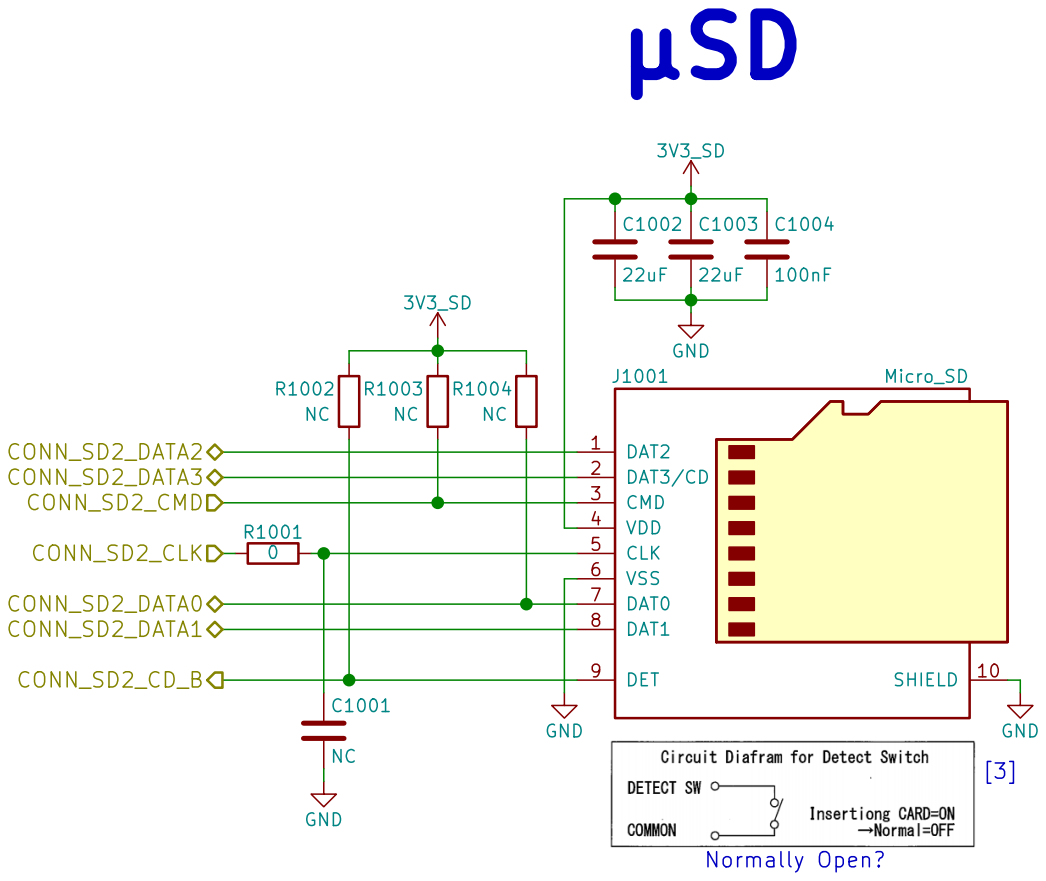
[picture p27: page 10]

eric.kuzmenko@puri.sm
angus.ainslie@puri.sm
nicole.faerber@puri.sm

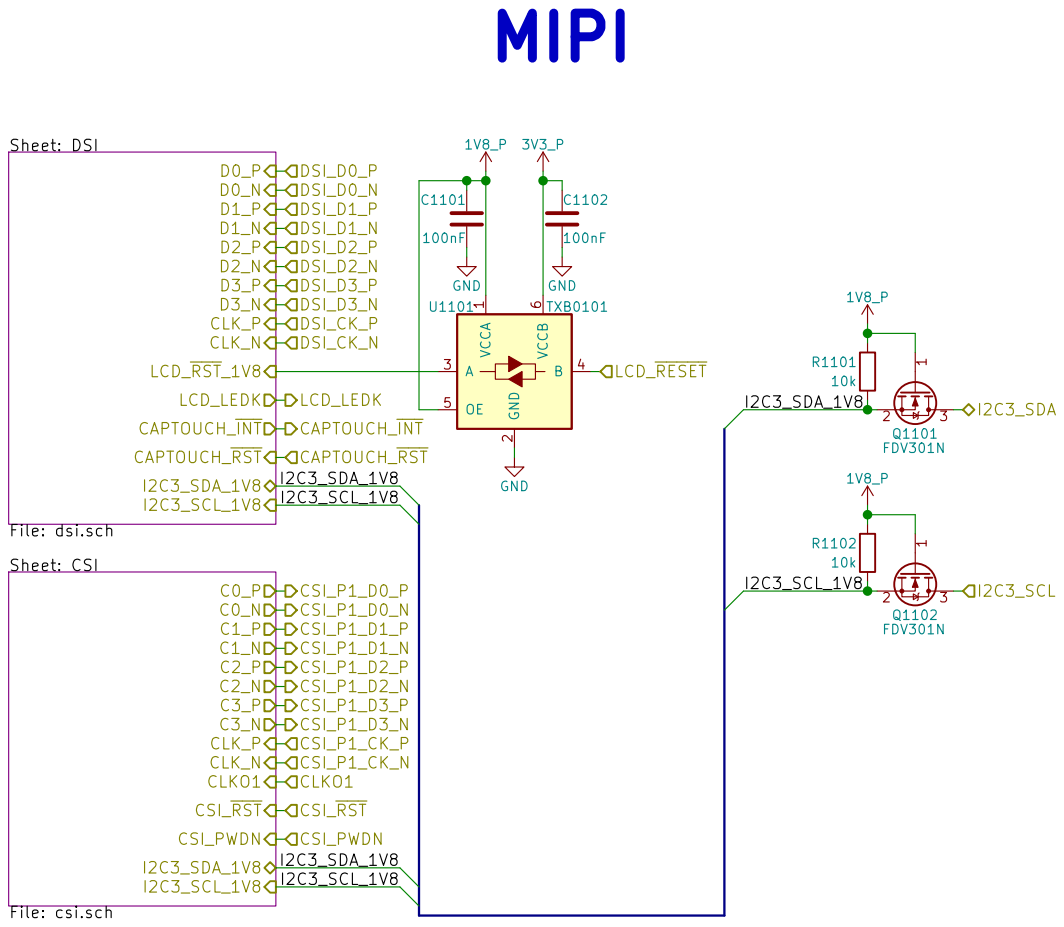
[picture p28: page 11]

eric.kuzmenko@puri.sm
angus.ainslie@puri.sm
nicole.faerber@puri.sm

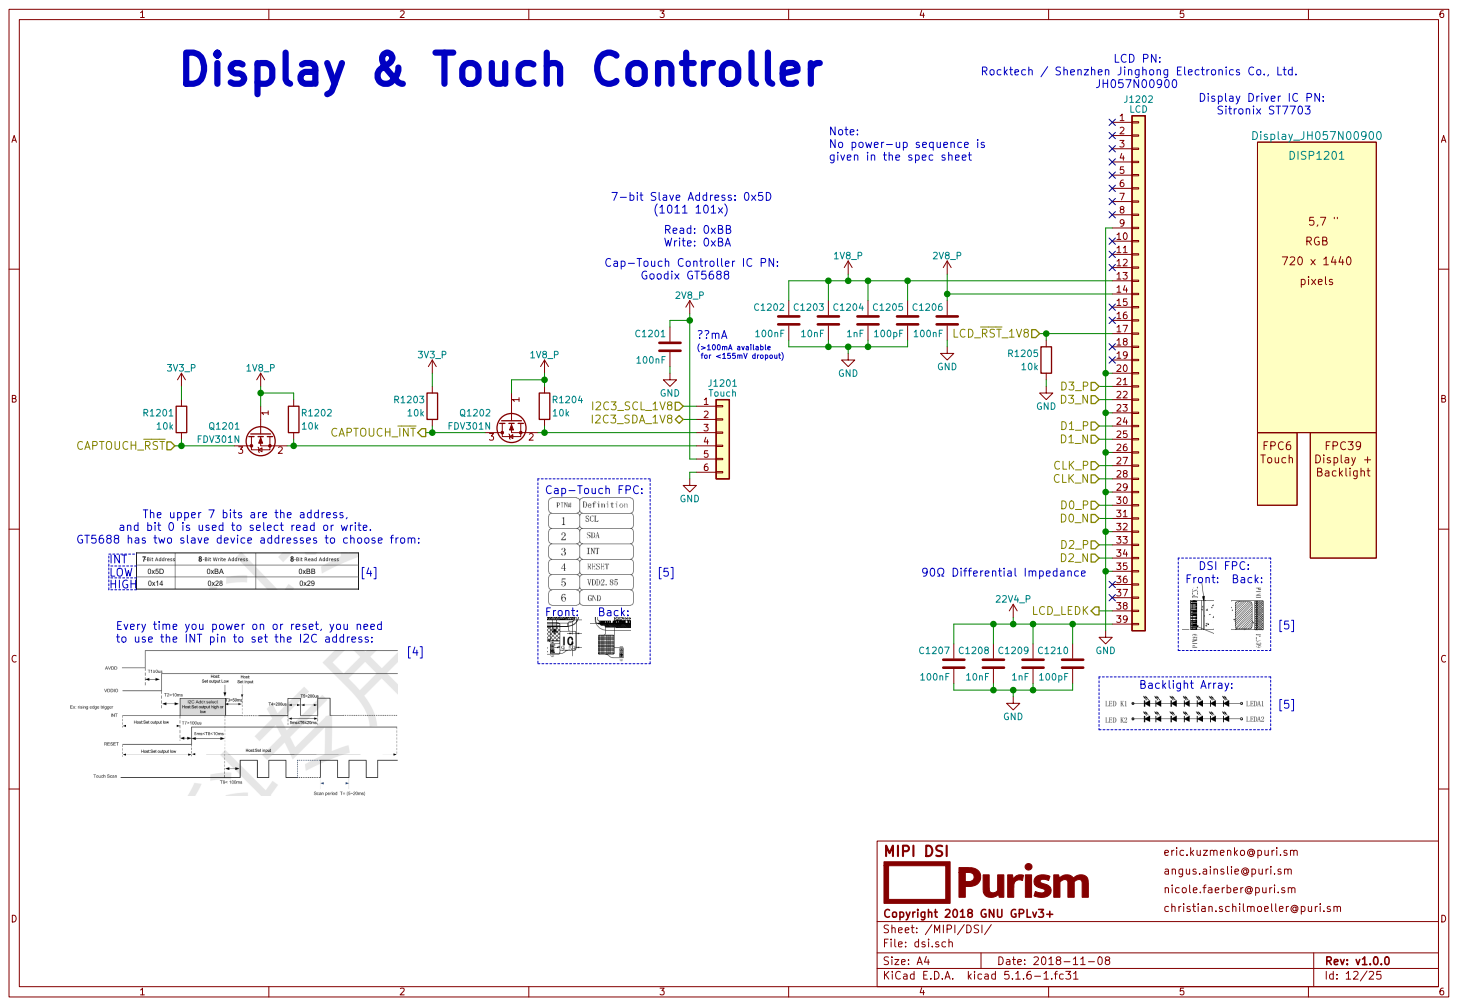
[picture p29: page 12]

Rocktech / Shenzhen Jinghong Electronics Co., Ltd.

JH057N00900 Note: No power-up sequence is

given in the spec sheet

for <155mV dropout) Cap-Touch Controller IC PN:
Goodix GT5688
2V8_P GND

14
15

The upper 7 bits are the address,
and bit 0 is used to select read or write. GT5688 has two slave device addresses to choose from:

Every time you power on or reset, you need
to use the INT pin to set the I2C address:

eric.kuzmenko@puri.sm
angus.ainslie@puri.sm
nicole.faerber@puri.sm

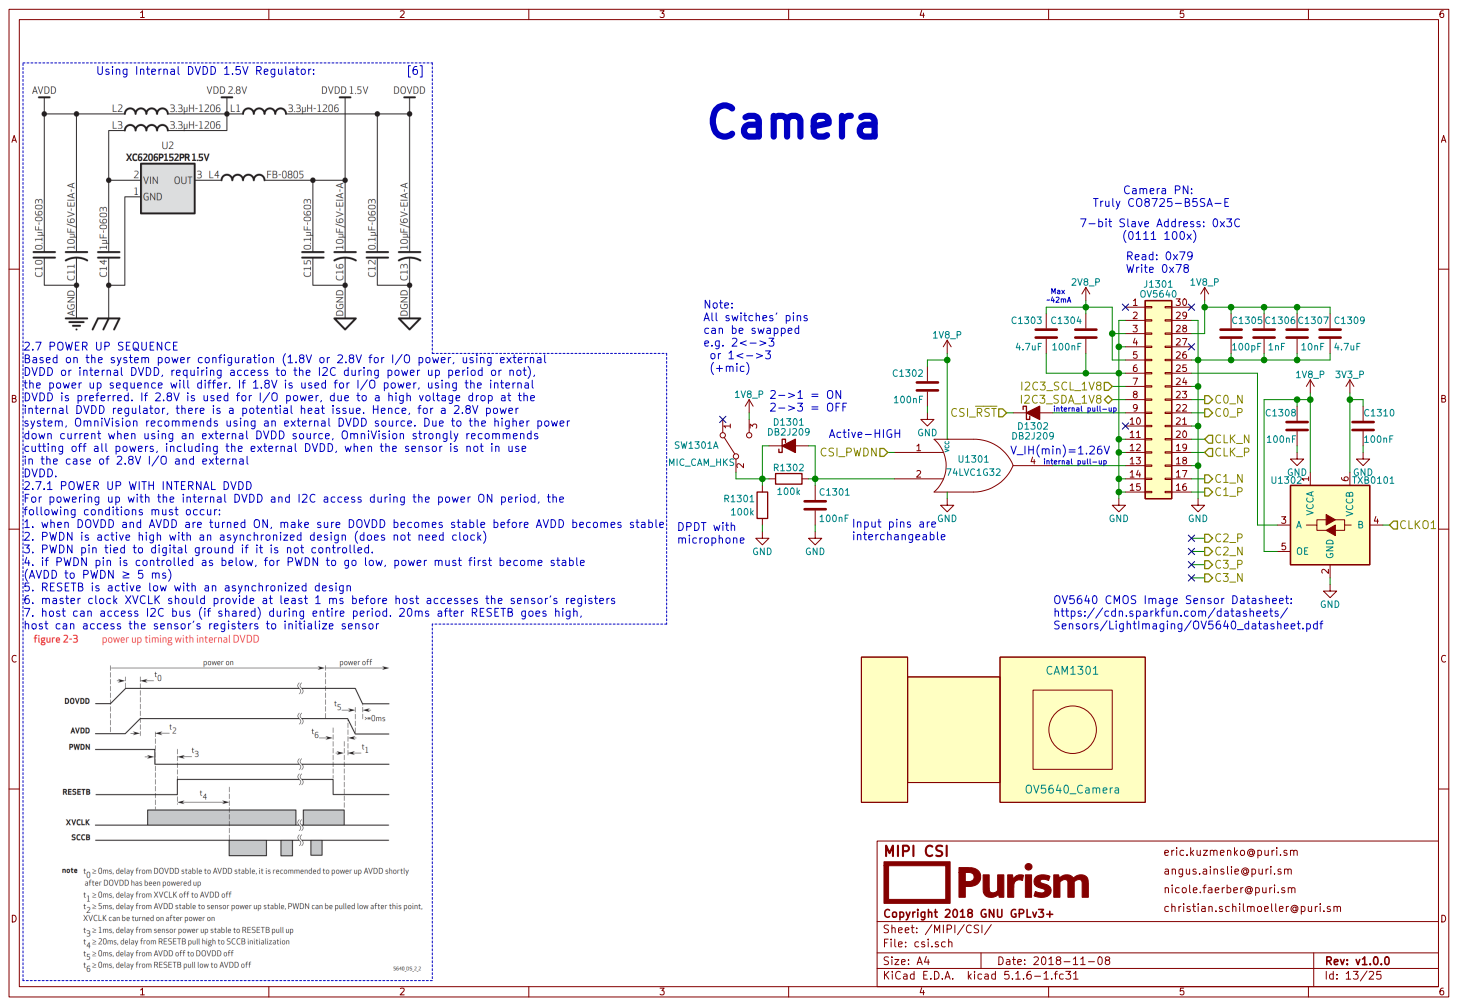
[picture p30: page 13]

interchangeable Note: All switches' pins

2.7 POWER UP SEQUENCE
Based on the system power configuration (1.8V or 2.8V for I/O power, using external
DVDD or internal DVDD, requiring access to the I2C during power up period or not),
the power up sequence will differ. If 1.8V is used for I/O power, using the internal
DVDD is preferred. If 2.8V is used for I/O power, due to a high voltage drop at the
internal DVDD regulator, there is a potential heat issue. Hence, for a 2.8V power
system, OmniVision recommends using an external DVDD source. Due to the higher power
down current when using an external DVDD source, OmniVision strongly recommends
cutting off all powers, including the external DVDD, when the sensor is not in use
in the case of 2.8V I/O and external DVDD. 2.7.1 POWER UP WITH INTERNAL DVDD

8 | 23
9 10 | 22

internal pull-up DPDT with microphone

For powering up with the internal DVDD and I2C access during the power ON period, the
following conditions must occur:
1. when DOVDD and AVDD are turned ON, make sure DOVDD becomes stable before AVDD becomes stable
2. PWDN is active high with an asynchronized design (does not need clock)
3. PWDN pin tied to digital ground if it is not controlled.
4. if PWDN pin is controlled as below, for PWDN to go low, power must first become stable
(AVDD to PWDN 5 ms)
5. RESETB is active low with an asynchronized design
6. master clock XVCLK should provide at least 1 ms before host accesses the sensors registers
7. host can access I2C bus (if shared) during entire period. 20ms after RESETB goes high,
host can access the sensor's registers to initialize sensor

OV5640 CMOS Image Sensor Datasheet:
https://cdn.sparkfun.com/datasheets/
Sensors/LightImaging/OV5640_datasheet.pdf

eric.kuzmenko@puri.sm
angus.ainslie@puri.sm
nicole.faerber@puri.sm

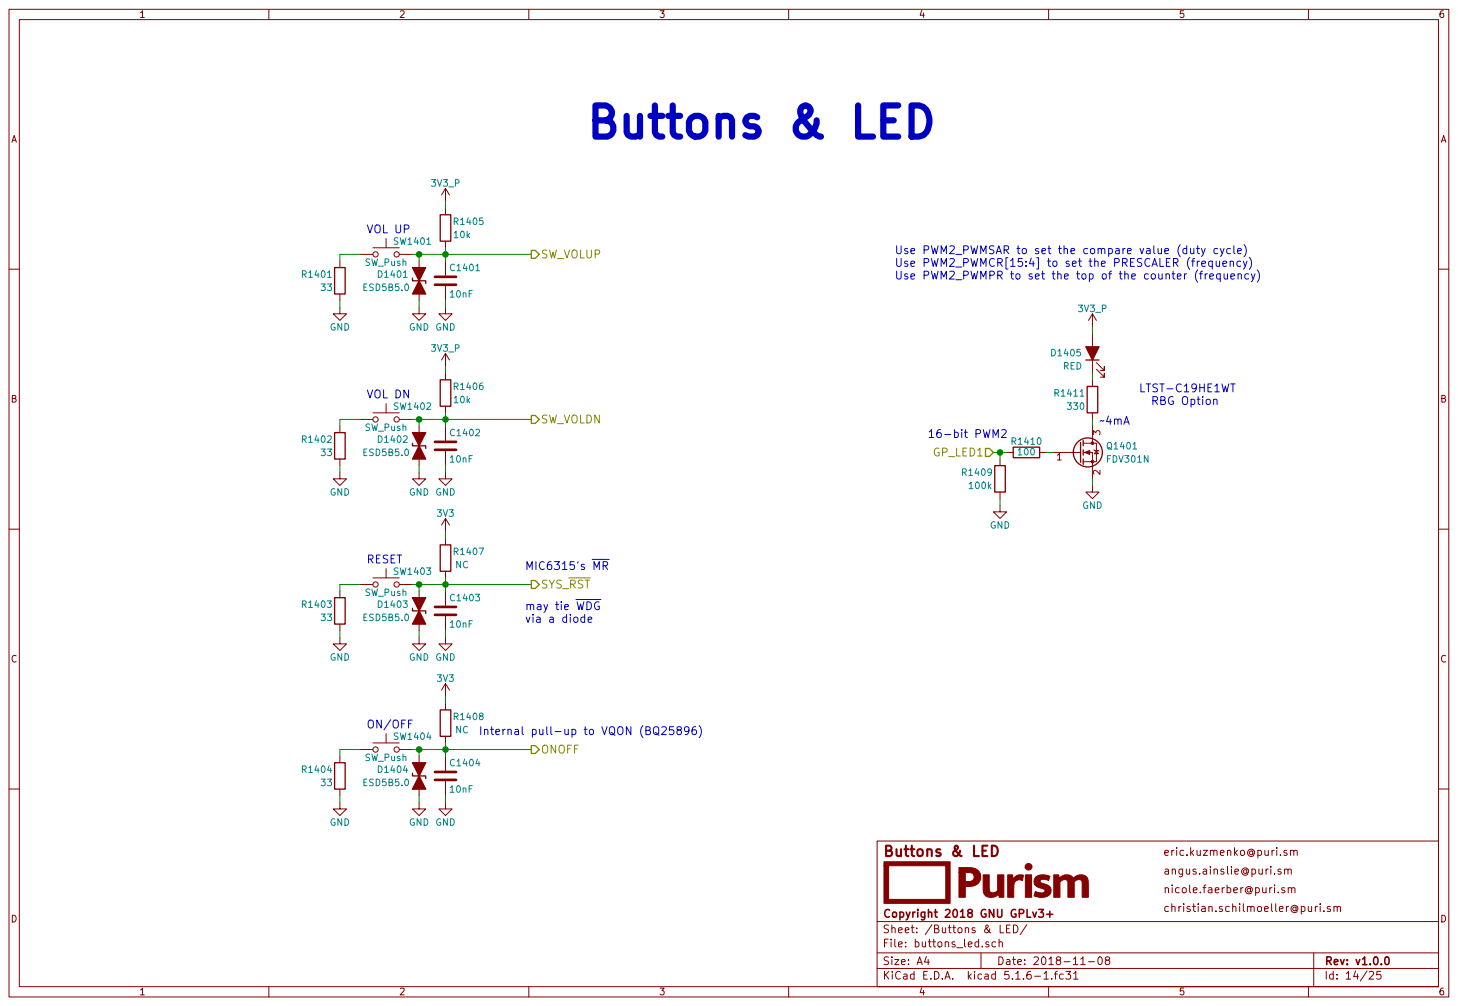
[picture p31: page 14]

Use PWM2_PWMSAR to set the compare value (duty cycle)
Use PWM2_PWMCR[15:4] to set the PRESCALER (frequency)
Use PWM2_PWMPR to set the top of the counter (frequency)

Internal pull-up to VQON (BQ25896)

eric.kuzmenko@puri.sm
angus.ainslie@puri.sm
nicole.faerber@puri.sm

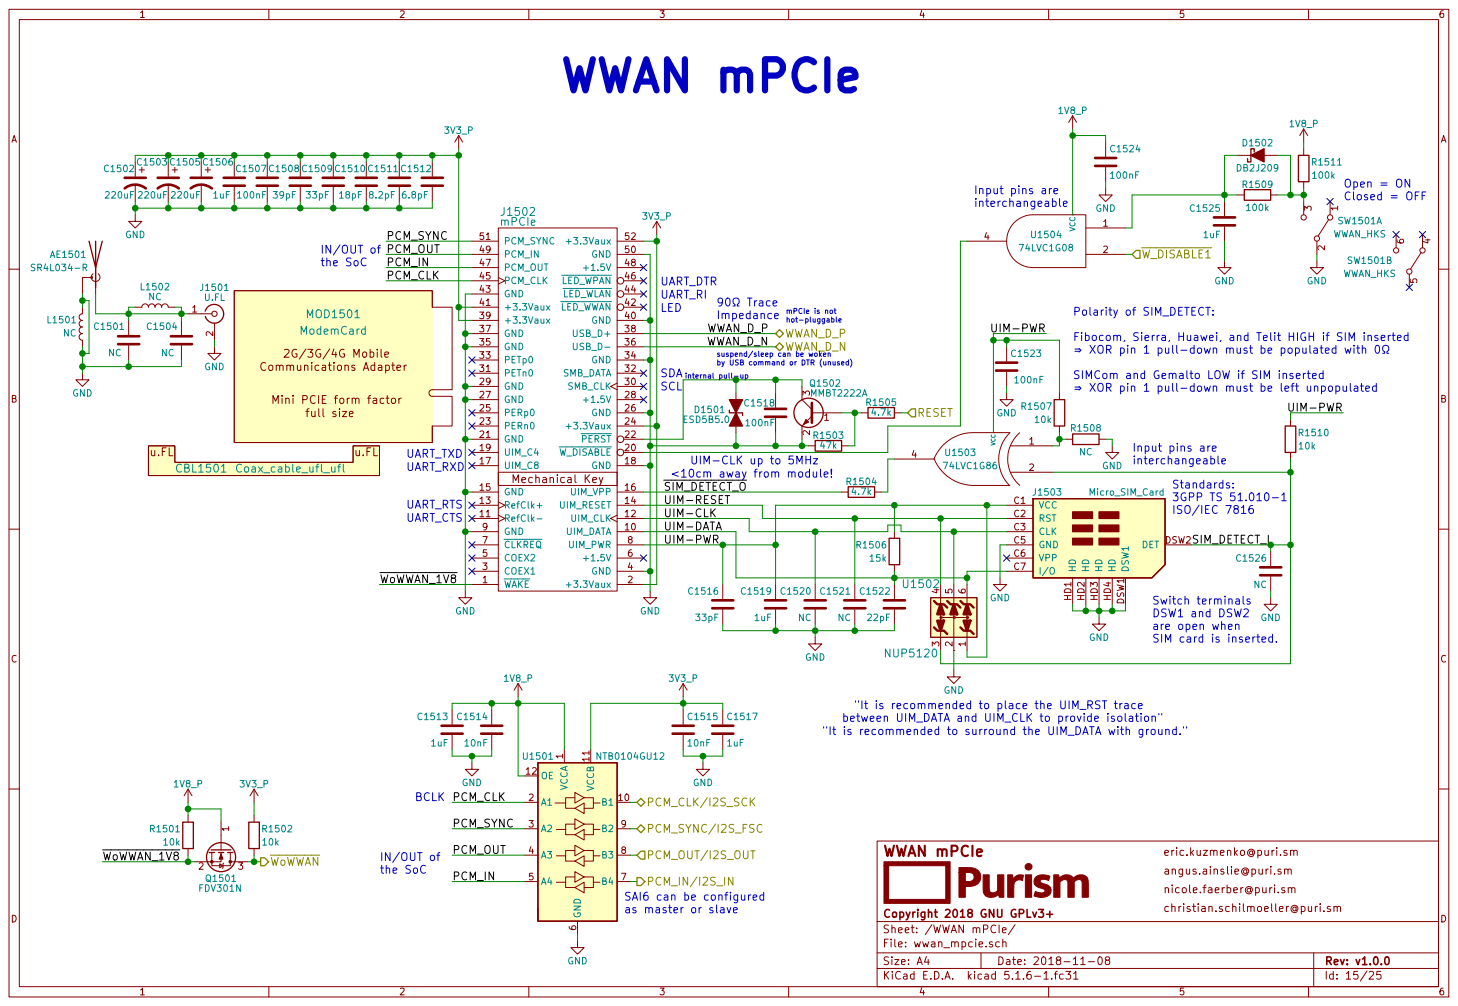
[picture p32: page 15]

Fibocom, Sierra, Huawei, and Telit HIGH if SIM inserted
XOR pin 1 pull-down must be populated with 0

by USB command or DTR (unused) UART_CTS

SIMCom and Gemalto LOW if SIM inserted
XOR pin 1 pull-down must be left unpopulated

full size Mini PCIE form factor

UIM-CLK up to 5MHz
<10cm away from module!
SIM_DETECT_O

UIM-RESET
UIM-CLK

DSW1 and DSW2
are open when
SIM card is inserted.

"It is recommended to place the UIM_RST trace
between UIM_DATA and UIM_CLK to provide isolation"
"It is recommended to surround the UIM_DATA with ground."

eric.kuzmenko@puri.sm
angus.ainslie@puri.sm
nicole.faerber@puri.sm

PCM_IN/I2S_IN
SAI6 can be configured
as master or slave

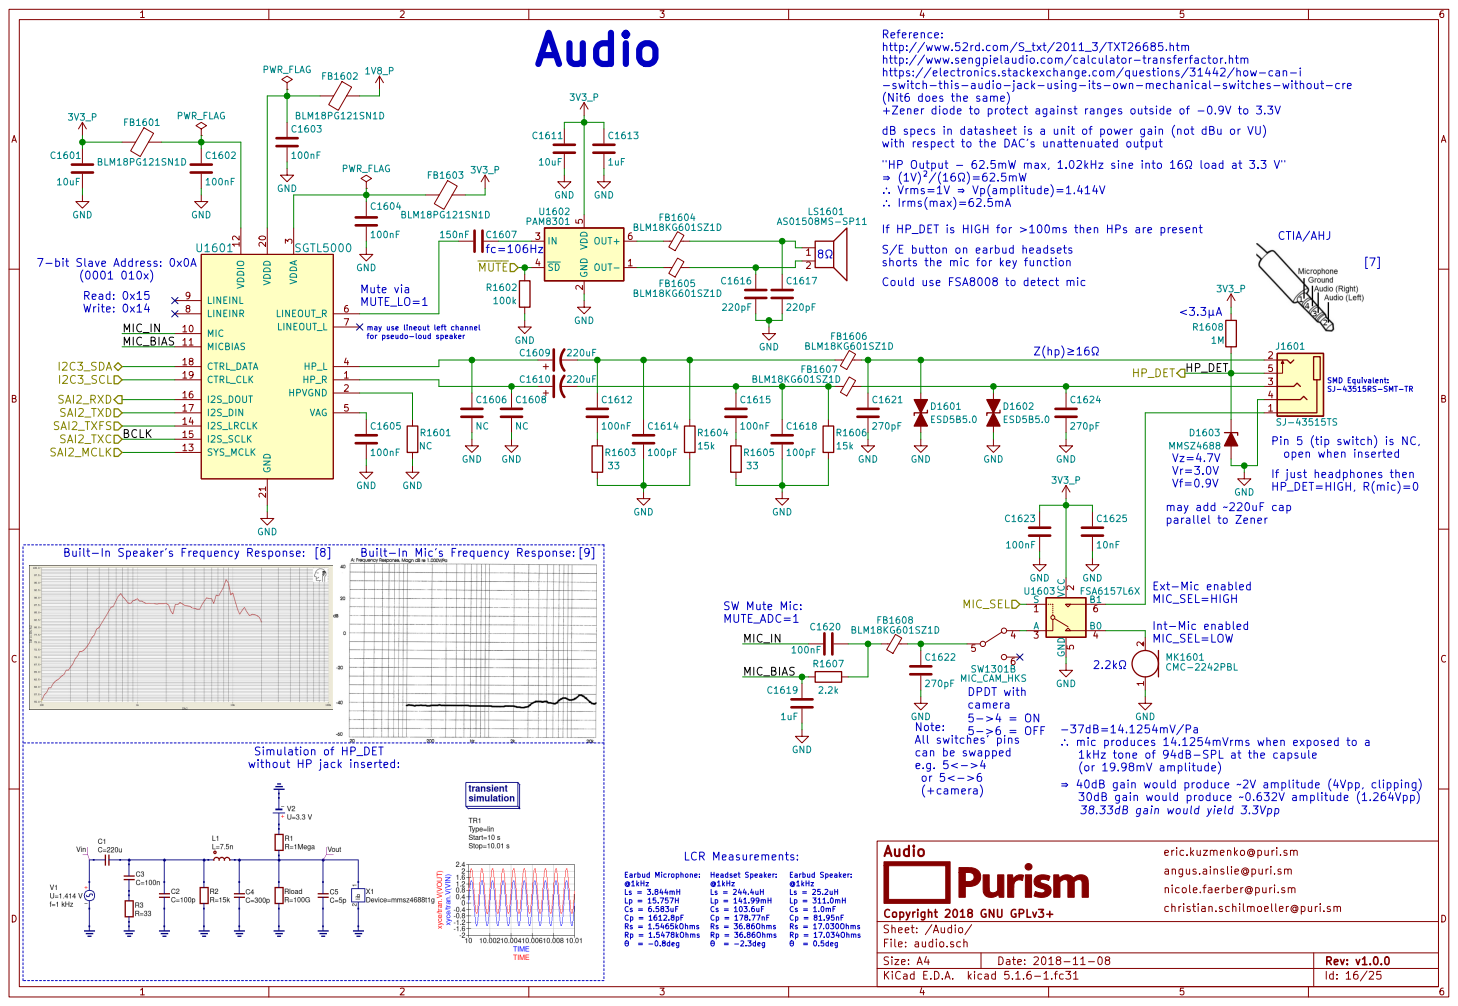
[picture p33: page 16]

Reference: http://www.52rd.com/S_txt/2011_3/TXT26685.htm

http://www.sengpielaudio.com/calculator-transferfactor.htm
https://electronics.stackexchange.com/questions/31442/how-can-i
-switch-this-audio-jack-using-its-own-mechanical-switches-without-cre
(Nit6 does the same)
+Zener diode to protect against ranges outside of -0.9V to 3.3V
dB specs in datasheet is a unit of power gain (not dBu or VU)
with respect to the DAC's unattenuated output
"HP Output - 62.5mW max, 1.02kHz sine into 16 load at 3.3 V"
Vrms=1V Vp(amplitude)=1.414V
Irms(max)=62.5mA

If HP_DET is HIGH for >100ms then HPs are present
S/E button on earbud headsets

shorts the mic for key function Read: 0x15 Write: 0x14

Could use FSA8008 to detect mic Mute via MUTE_LO=1

open when inserted
If just headphones then

Int-Mic enabled MIC_SEL=LOW

mic produces 14.1254mVrms when exposed to a
1kHz tone of 94dB-SPL at the capsule
(or 19.98mV amplitude)
40dB gain would produce 2V amplitude (4Vpp, clipping)

Simulation of HP_DET
without HP jack inserted:

30dB gain would produce 0.632V amplitude (1.264Vpp) Headset Speaker: @1kHz Ls = 244.4uH

LCR Measurements: Earbud Microphone: @1kHz Ls = 3.844mH

eric.kuzmenko@puri.sm
angus.ainslie@puri.sm
nicole.faerber@puri.sm

Cs = 6.583uF Cp = 1612.8pF Rs = 1.5465kOhms Rp = 1.5478kOhms

Cs = 103.6uF Cp = 178.77nF Rs = 36.86Ohms Rp = 36.86Ohms

Cs = 1.0mF Cp = 81.95nF Rs = 17.030Ohms Rp = 17.034Ohms

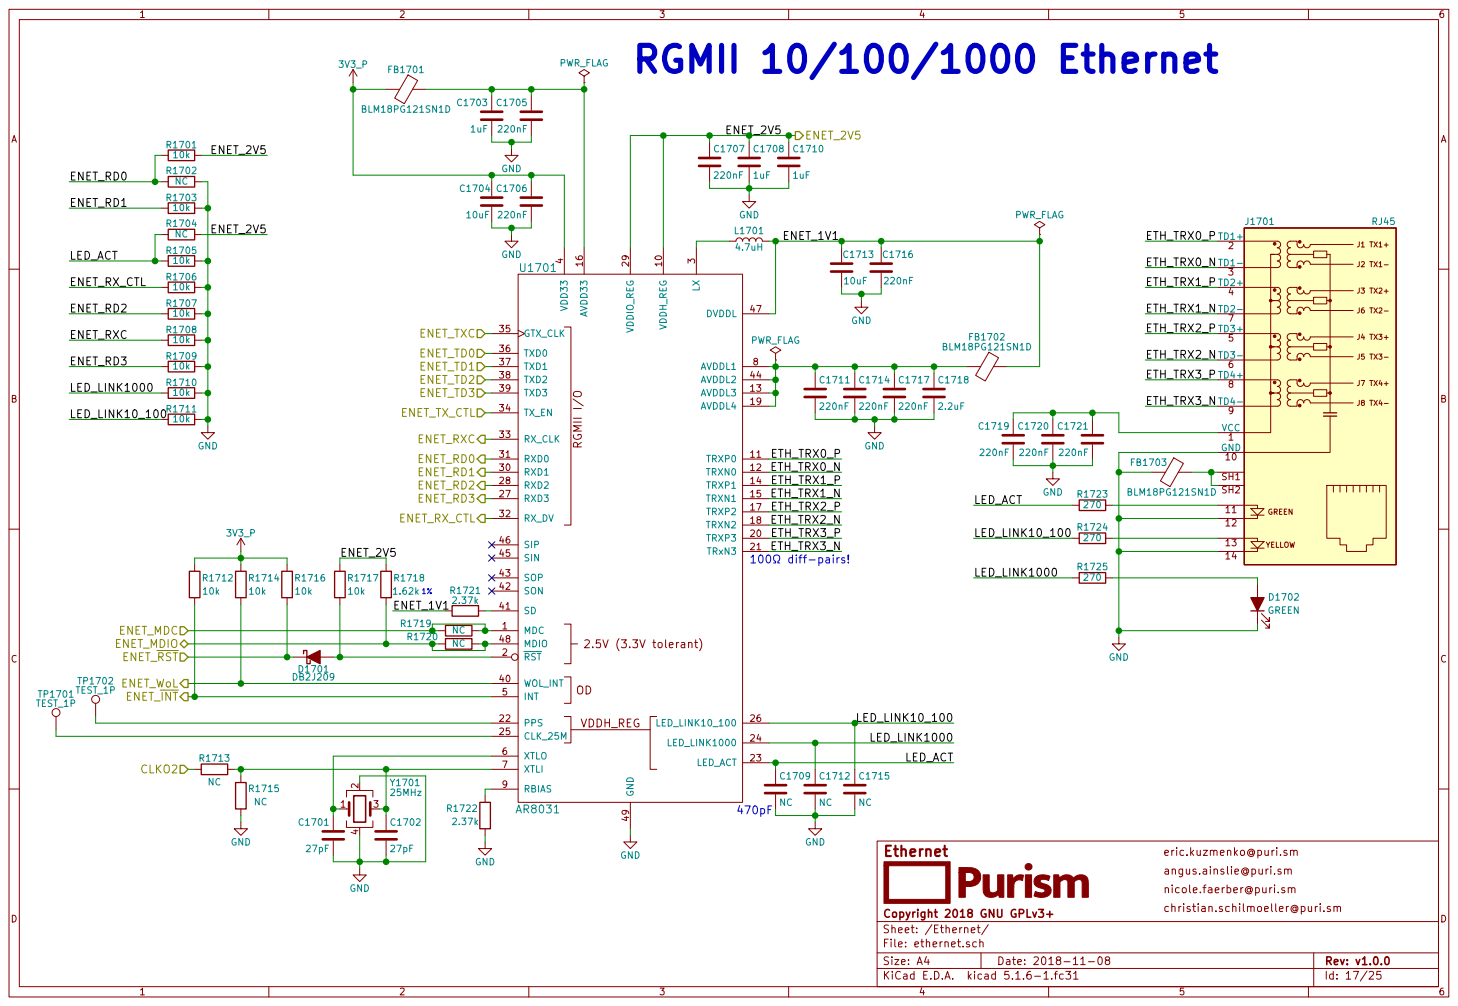
[picture p34: page 17]

4 WOL_INT 40 SD 41 SON 42 SOP 43 AVDDL2 44 SIN 45 SIP 46 DVDDL 47 MDIO 48 GND 49

ETH_TRX0_N
ETH_TRX1_P
ETH_TRX1_N
ETH_TRX2_P
ETH_TRX2_N
ETH_TRX3_P
ETH_TRX3_N

eric.kuzmenko@puri.sm
angus.ainslie@puri.sm
nicole.faerber@puri.sm

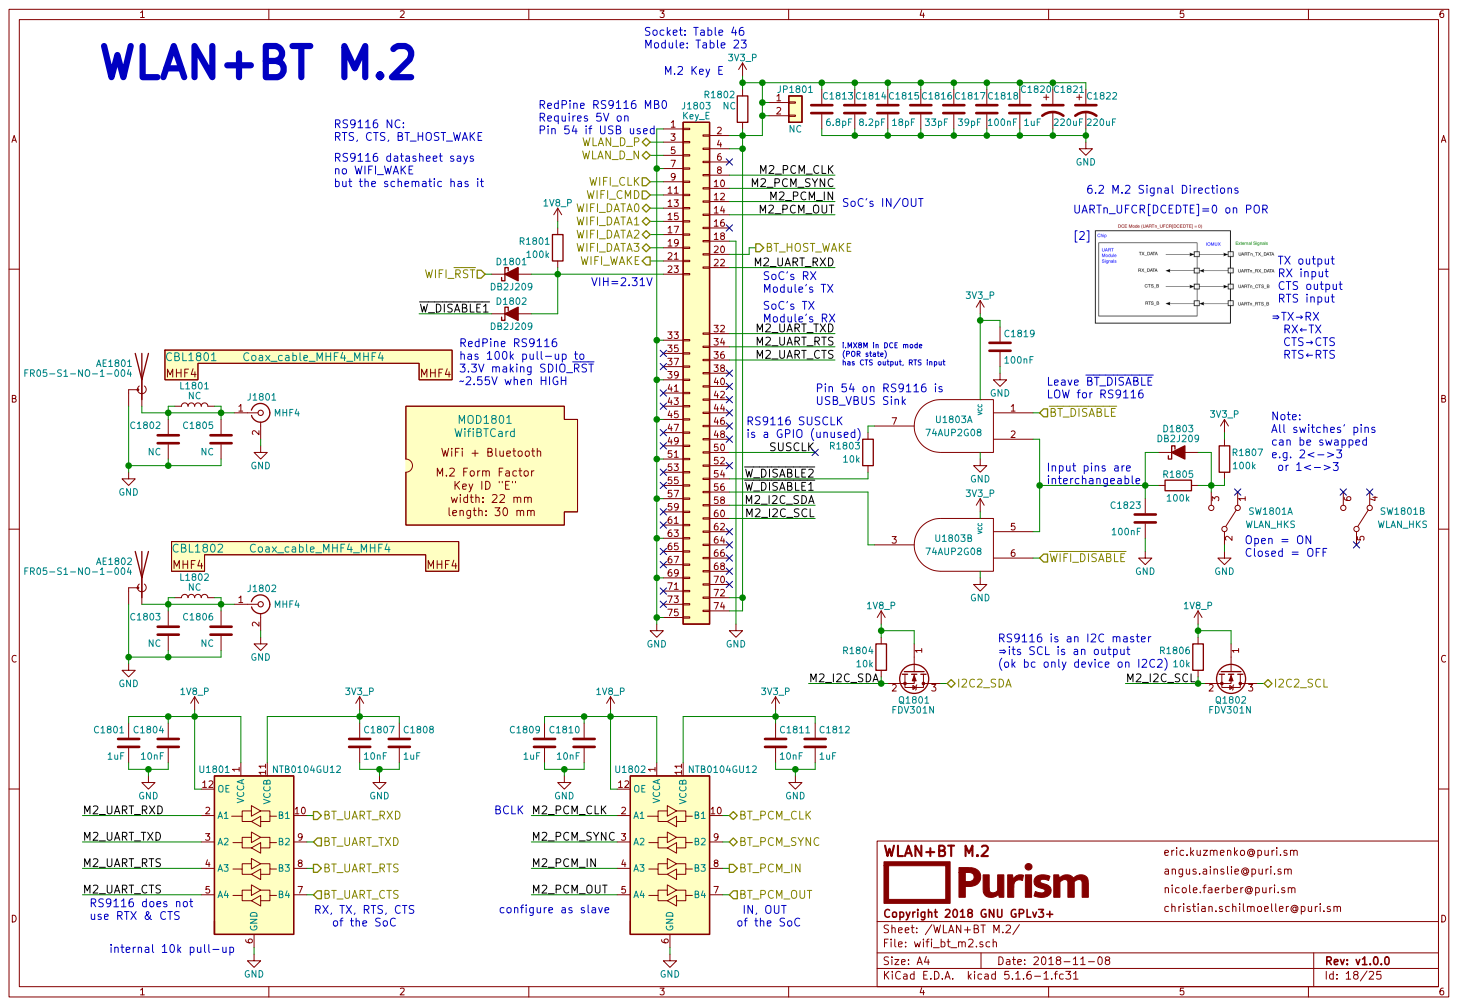
[picture p35: page 18]

Socket: Table 46 Module: Table 23
3V3_P GND

RedPine RS9116 MB0
Requires 5V on
Pin 54 if USB used

33 | 8.2pF GND GND

12
14 | M2_PCM_OUT

SoC's TX Module's RX
M2_UART_TXD

34 | M2_UART_RTS
36 | M2_UART_CTS

has 100k pull-up to
3.3V making SDIO_RST
2.55V when HIGH

M.2 Form Factor width: 22 mm WiFi + Bluetooth MOD1801

56 | W_DISABLE1
58 | M2_I2C_SDA
60 | M2_I2C_SCL

RS9116 is an I2C master
its SCL is an output
(ok bc only device on I2C2)

eric.kuzmenko@puri.sm
angus.ainslie@puri.sm
nicole.faerber@puri.sm

BT_UART_CTS
RX, TX, RTS, CTS
of the SoC

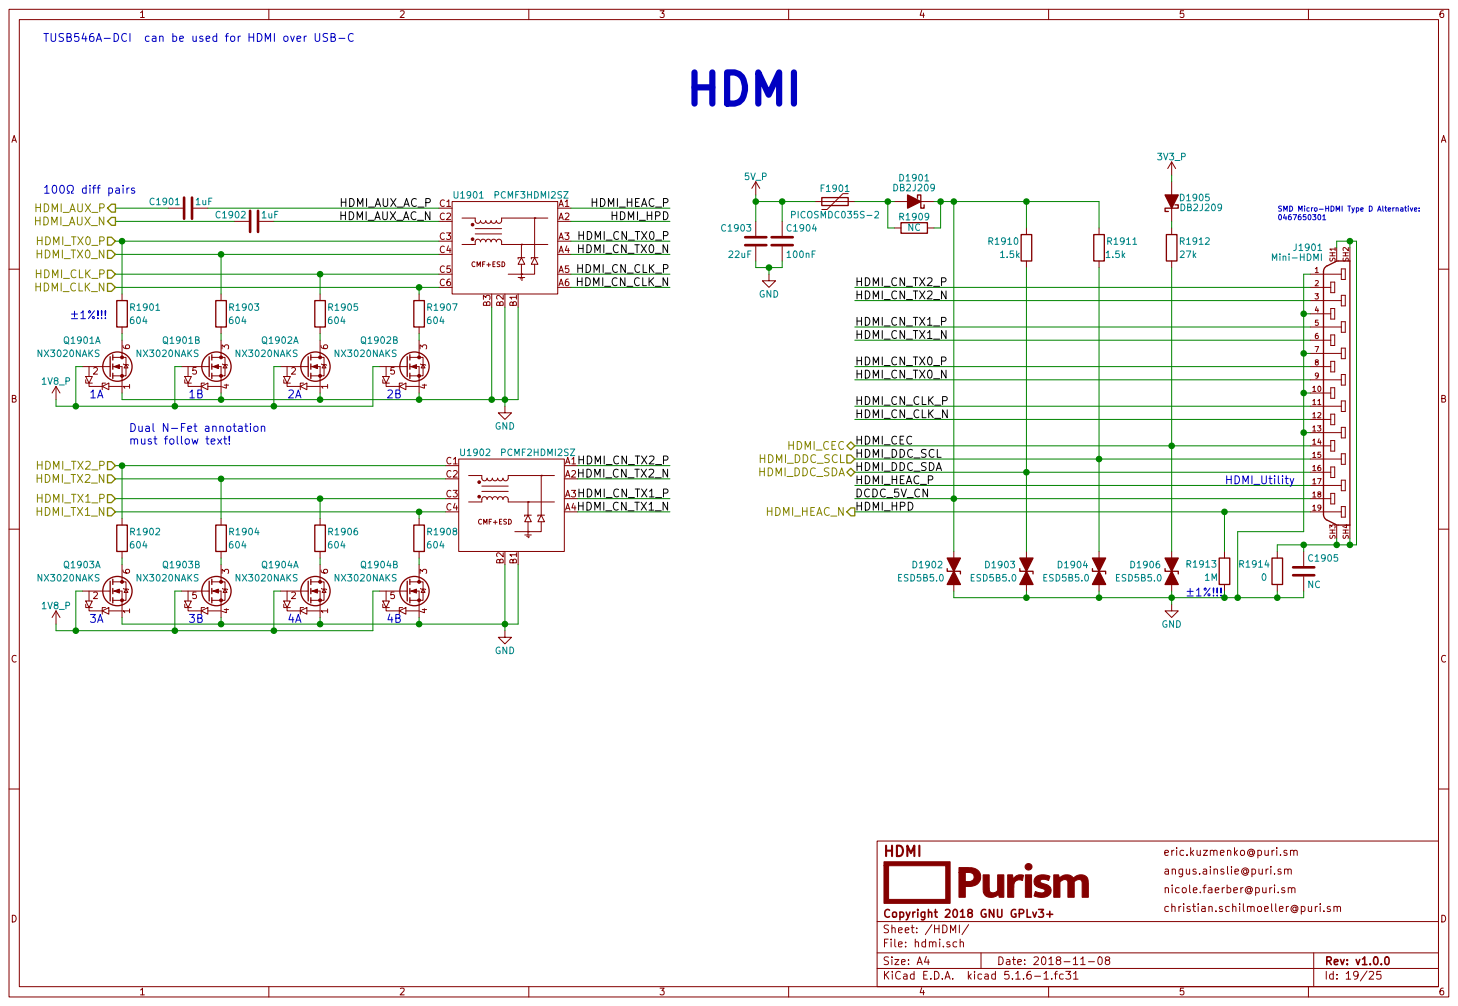
[picture p36: page 19]

TUSB546A-DCI can be used for HDMI over USB-C

HDMI_CN_TX2_N | 3

HDMI_CN_TX1_N | 6

HDMI_CN_TX0_N

HDMI_CN_CLK_N | 12

HDMI_DDC_SCL | 15
HDMI_DDC_SDA | 16
HDMI_HEAC_P | | 17

eric.kuzmenko@puri.sm
angus.ainslie@puri.sm
nicole.faerber@puri.sm

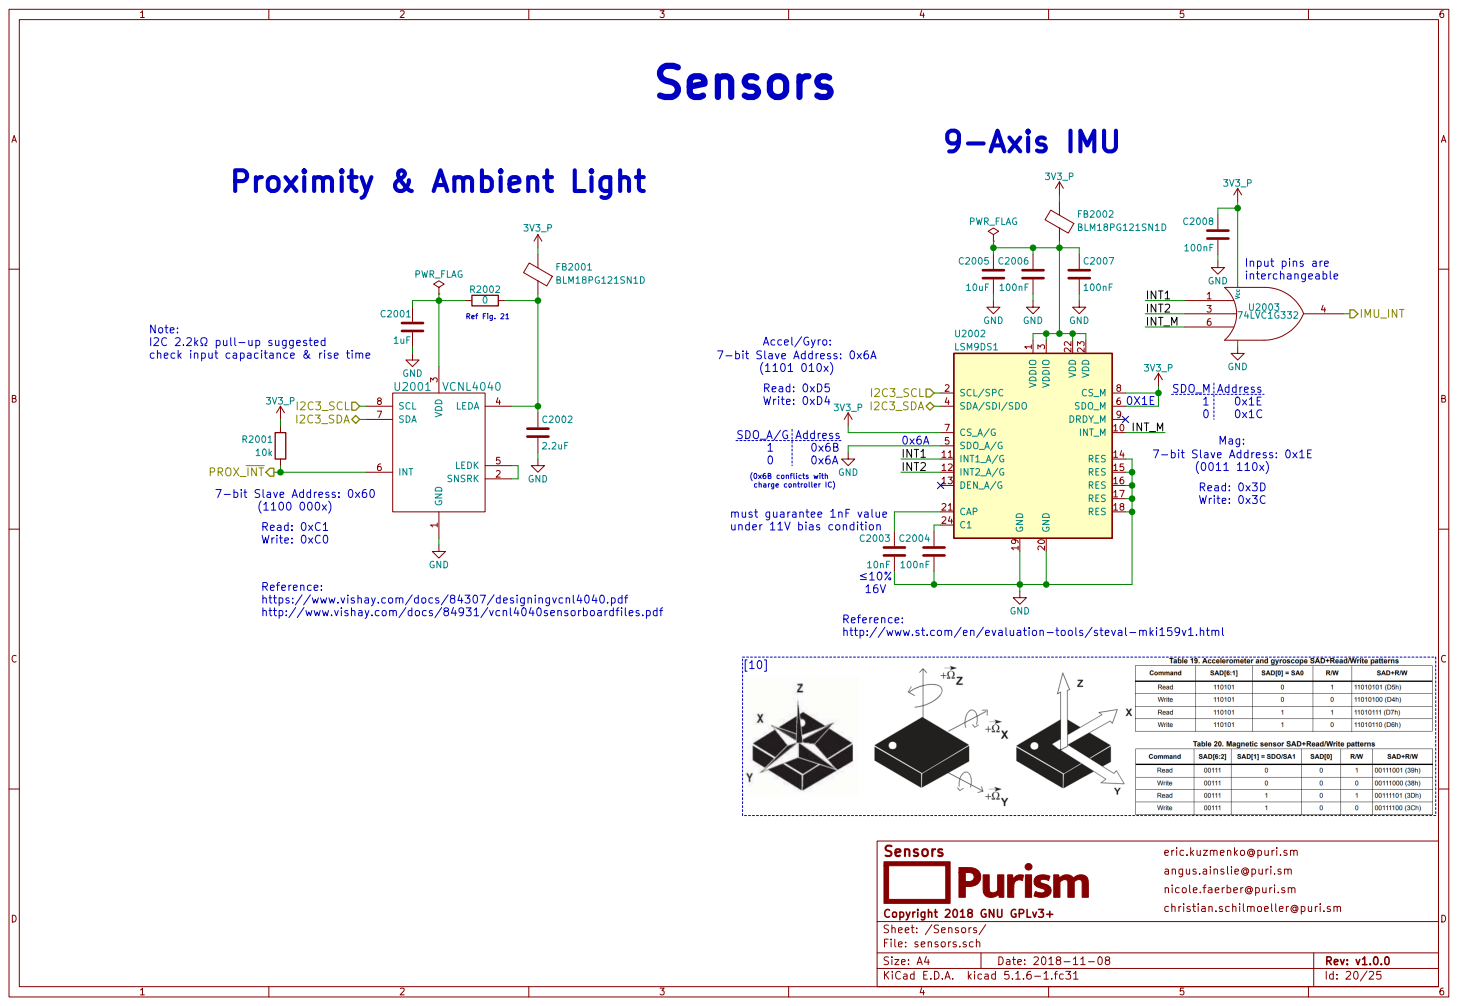
[picture p37: page 20]

INT1 Reference: https://www.vishay.com/docs/84307/designingvcnl4040.pdf

Reference: http://www.st.com/en/evaluation-tools/steval-mki159v1.html Note:
I2C 2.2k pull-up suggested
check input capacitance & rise time

(1101 010x) Read: 0xD5 Write: 0xD4 Accel/Gyro:
charge controller IC) 7-bit Slave Address: 0x6A

INT1
INT2

http://www.vishay.com/docs/84931/vcnl4040sensorboardfiles.pdf

eric.kuzmenko@puri.sm
angus.ainslie@puri.sm
nicole.faerber@puri.sm

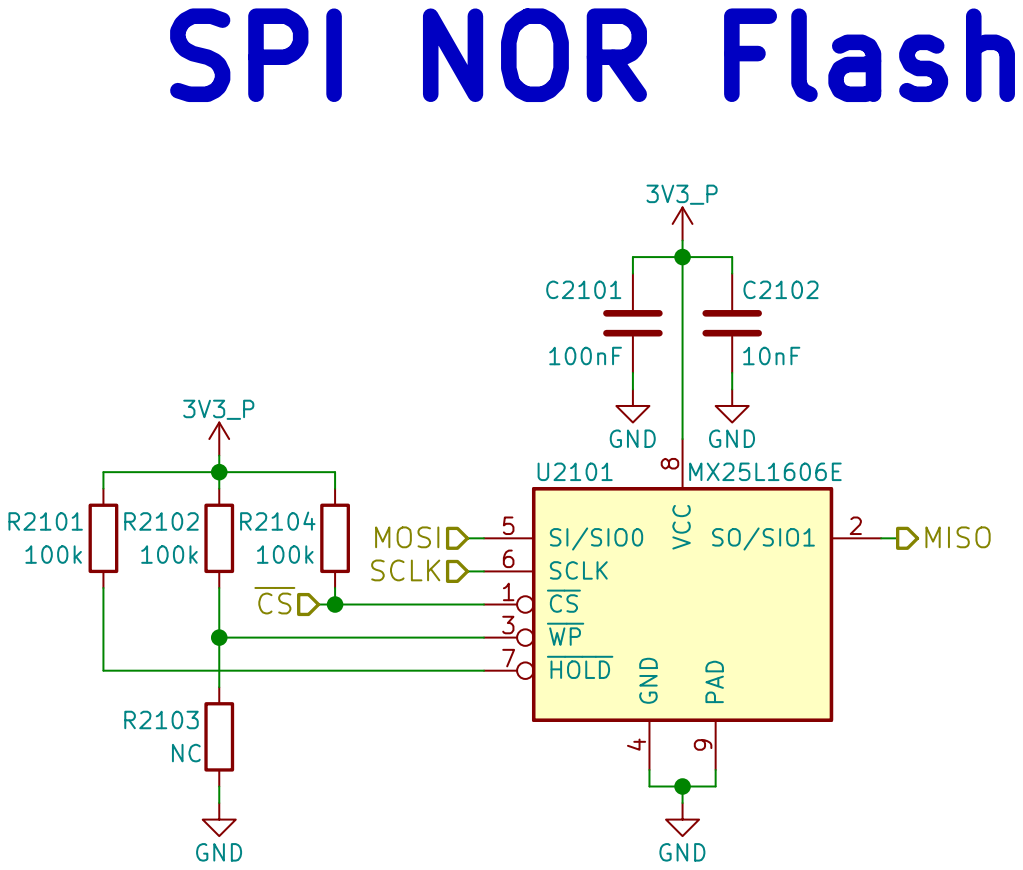
[picture p38: page 21]

4 SI/SIO0 5 SCLK 6 HOLD 7 VCC

Id: 21/25 SPI NOR Flash

eric.kuzmenko@puri.sm
angus.ainslie@puri.sm
nicole.faerber@puri.sm

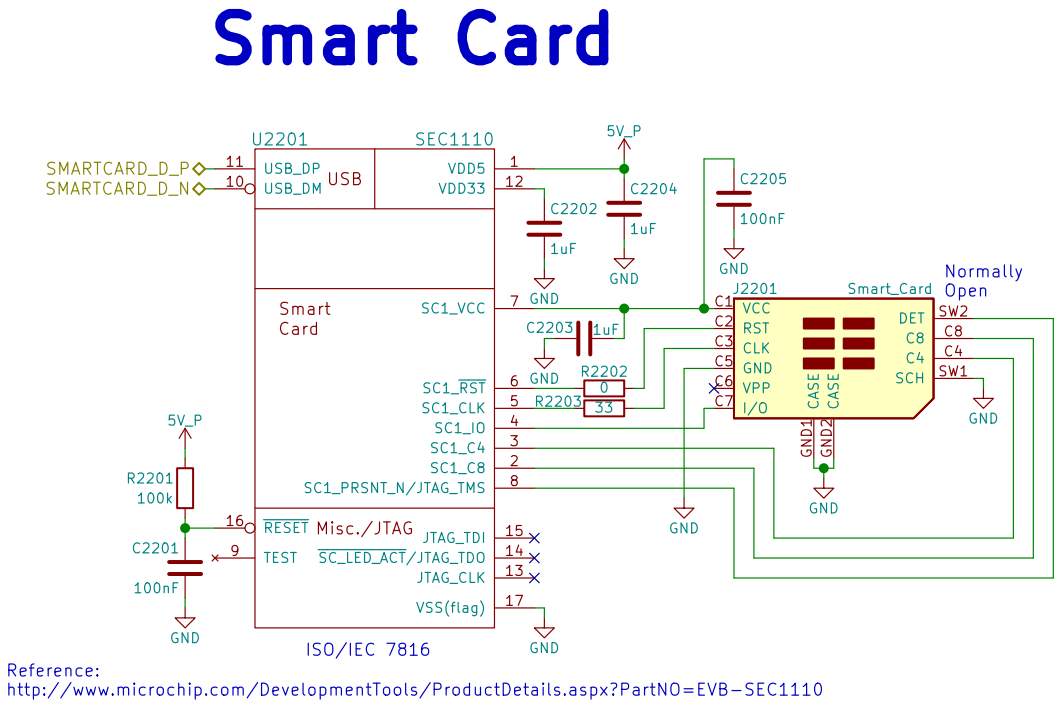
[picture p39: page 22]

ISO/IEC 7816 Reference: http://www.microchip.com/DevelopmentTools/ProductDetails.aspx?PartNO=EVB-SEC1110

eric.kuzmenko@puri.sm
angus.ainslie@puri.sm
nicole.faerber@puri.sm

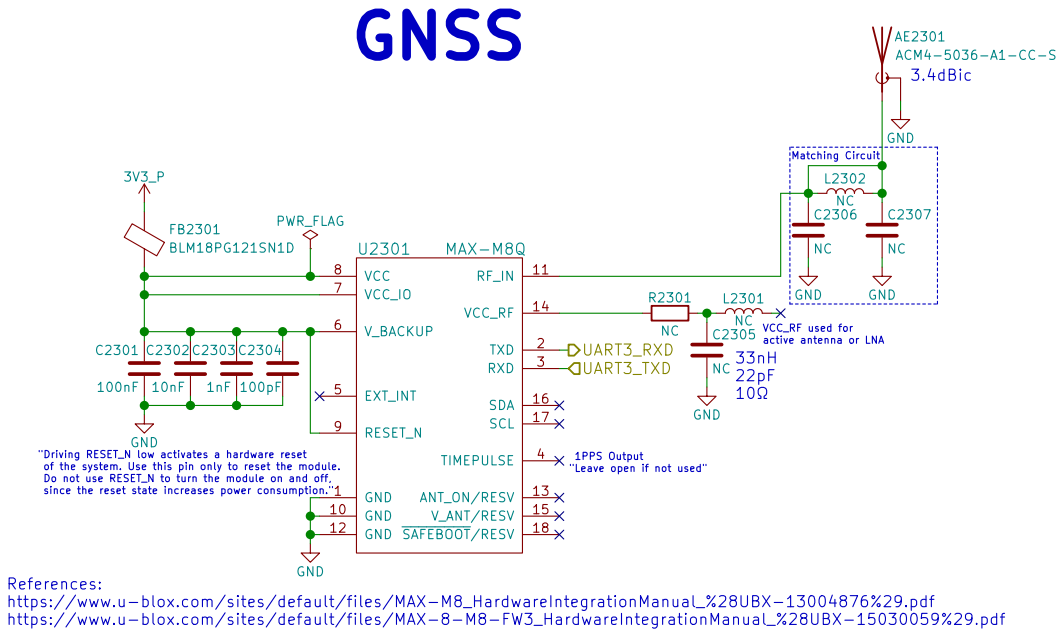
[picture p40: page 23]

"Driving RESET_N low activates a hardware reset
1PPS Output "Leave open if not used" References: https://www.u-blox.com/sites/default/files/MAX-M8_HardwareIntegrationManual_%28UBX-13004876%29.pdf
of the system. Use this pin only to reset the module.
Do not use RESET_N to turn the module on and off,

eric.kuzmenko@puri.sm
angus.ainslie@puri.sm
nicole.faerber@puri.sm

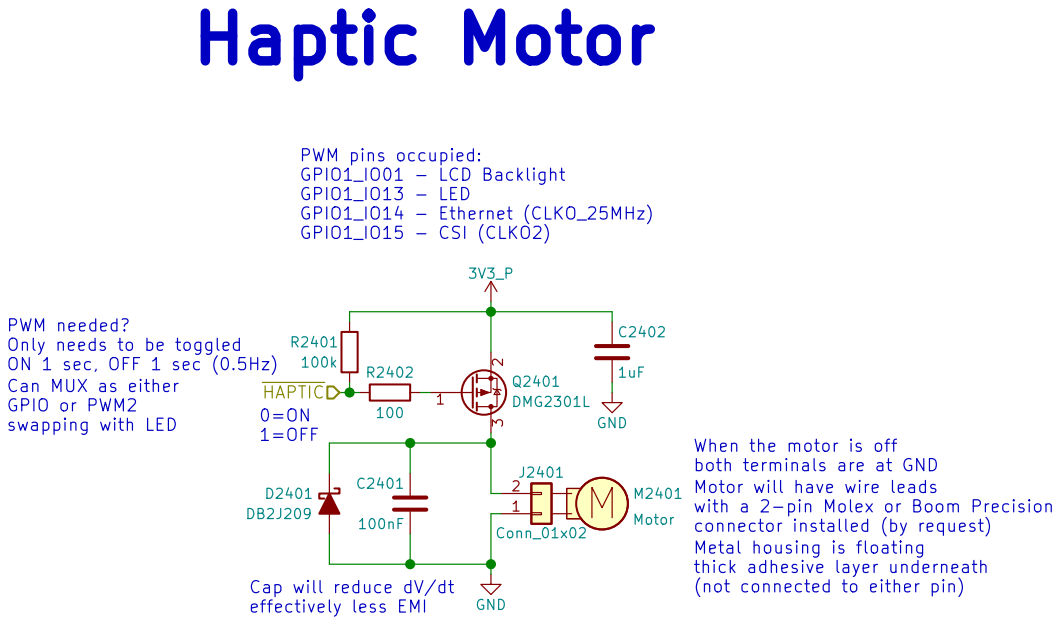
[picture p41: page 24]

PWM needed? Only needs to be toggled

ON 1 sec, OFF 1 sec (0.5Hz)
Can MUX as either
GPIO or PWM2
swapping with LED

2 3 Q2401 DMG2301L HAPTIC When the motor is off both terminals are at GND

connector installed (by request)
Metal housing is floating
thick adhesive layer underneath
(not connected to either pin)

Cap will reduce dV/dt
effectively less EMI

Id: 24/25 Haptic/Vibration Motor

eric.kuzmenko@puri.sm
angus.ainslie@puri.sm
nicole.faerber@puri.sm
christian.schilmoeller@puri.sm

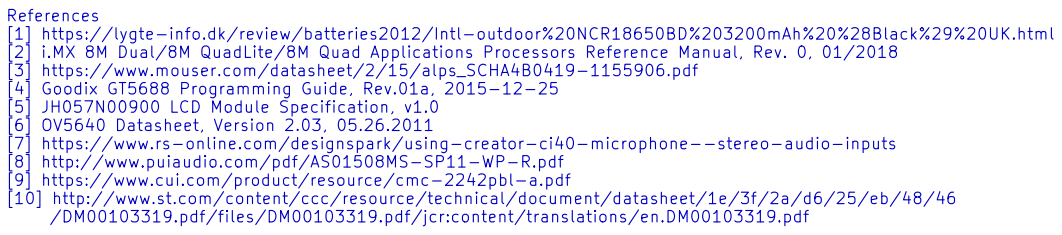
[picture p42: page 25]

References
[1] https://lygte-info.dk/review/batteries2012/Intl-outdoor%20NCR18650BD%203200mAh%20%28Black%29%20UK.html
[2] i.MX 8M Dual/8M QuadLite/8M Quad Applications Processors Reference Manual, Rev. 0, 01/2018
[3] https://www.mouser.com/datasheet/2/15/alps_SCHA4B0419-1155906.pdf
[4] Goodix GT5688 Programming Guide, Rev.01a, 2015-12-25
[5] JH057N00900 LCD Module Specification, v1.0
[6] OV5640 Datasheet, Version 2.03, 05.26.2011
[7] https://www.rs-online.com/designspark/using-creator-ci40-microphone--stereo-audio-inputs
[8] http://www.puiaudio.com/pdf/AS01508MS-SP11-WP-R.pdf
[9] https://www.cui.com/product/resource/cmc-2242pbl-a.pdf
[10] http://www.st.com/content/ccc/resource/technical/document/datasheet/1e/3f/2a/d6/25/eb/48/46
/DM00103319.pdf/files/DM00103319.pdf/jcr:content/translations/en.DM00103319.pdf

eric.kuzmenko@puri.sm
angus.ainslie@puri.sm
nicole.faerber@puri.sm
