gralco/dvk-mx8m-bsb/Experimental_placing_90x170.pdf

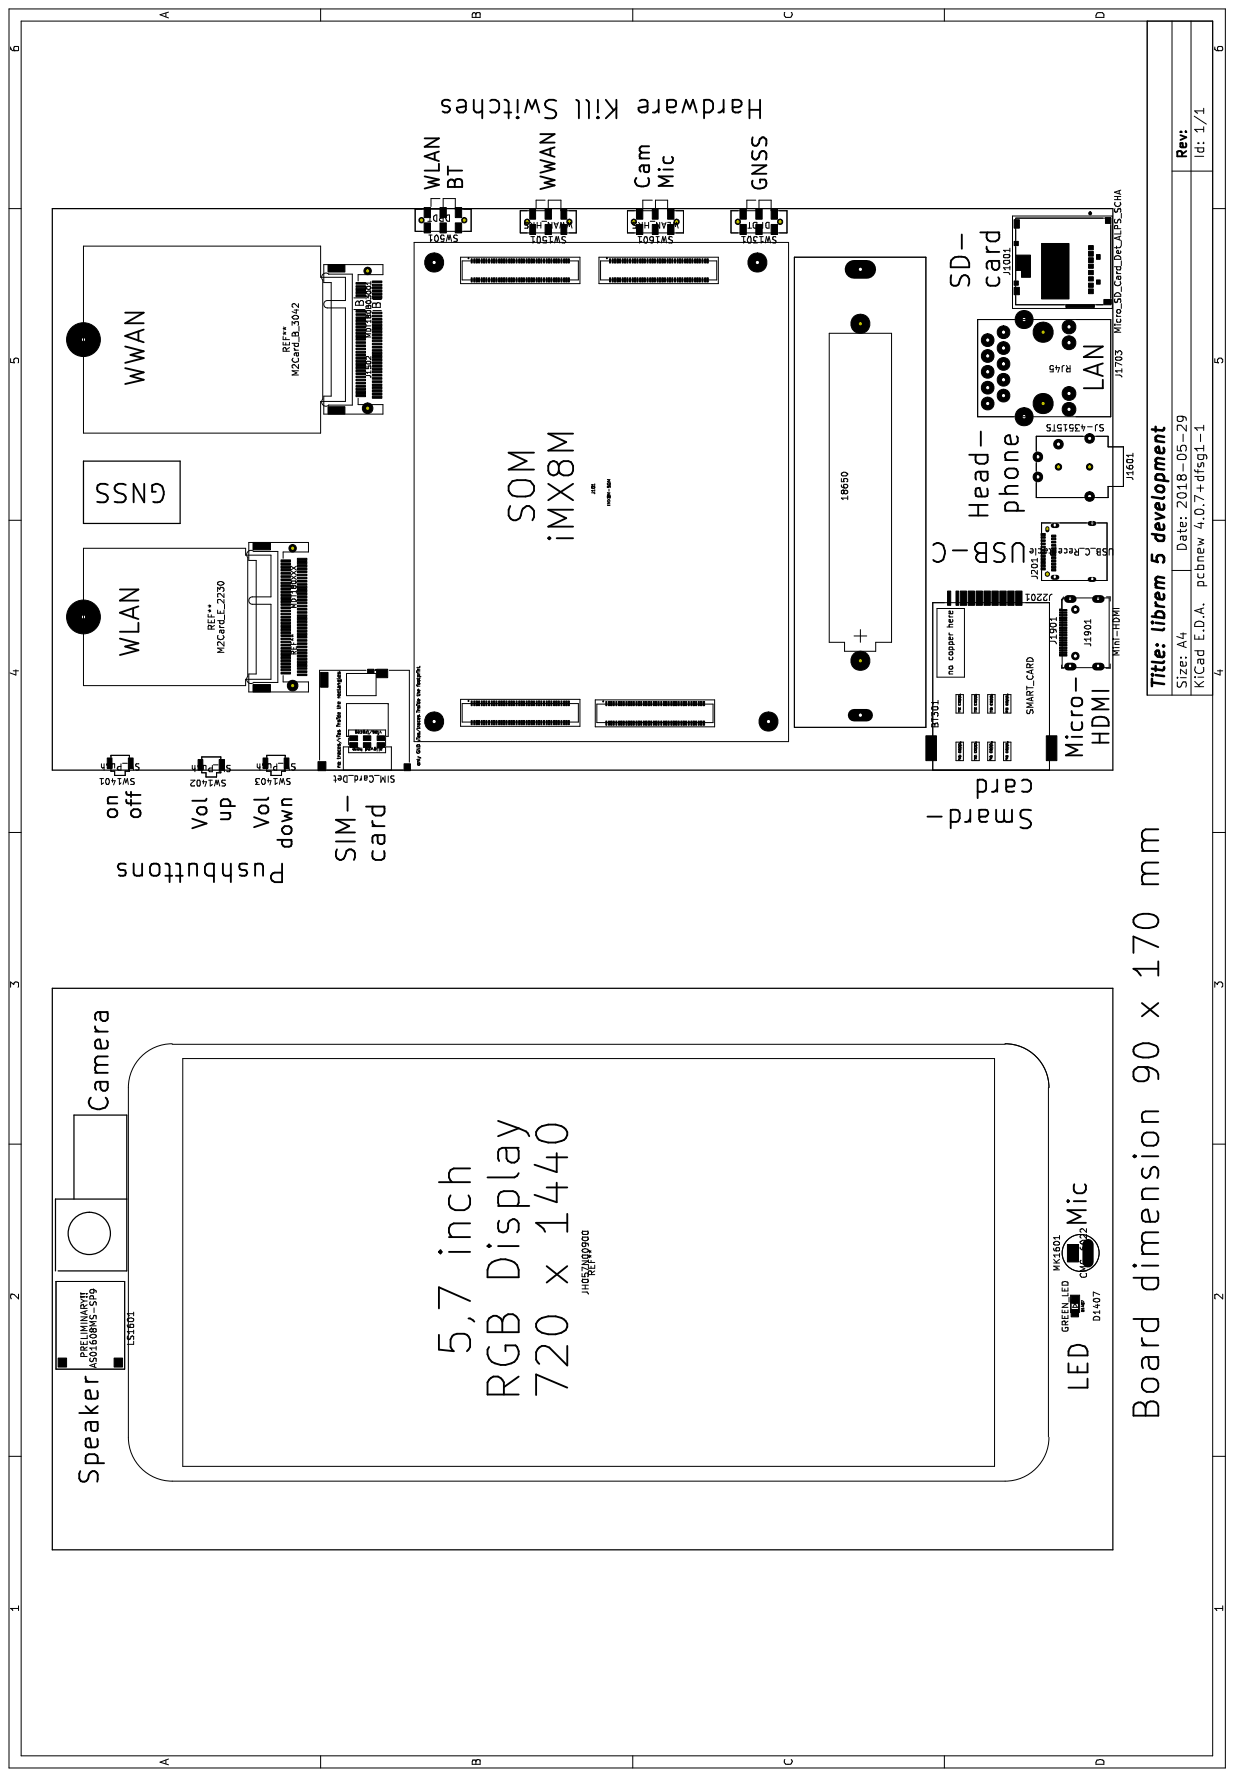
[picture p43: page 1]
