gralco/dvk-mx8m-bsb/Experimental_placing_100x160.pdf

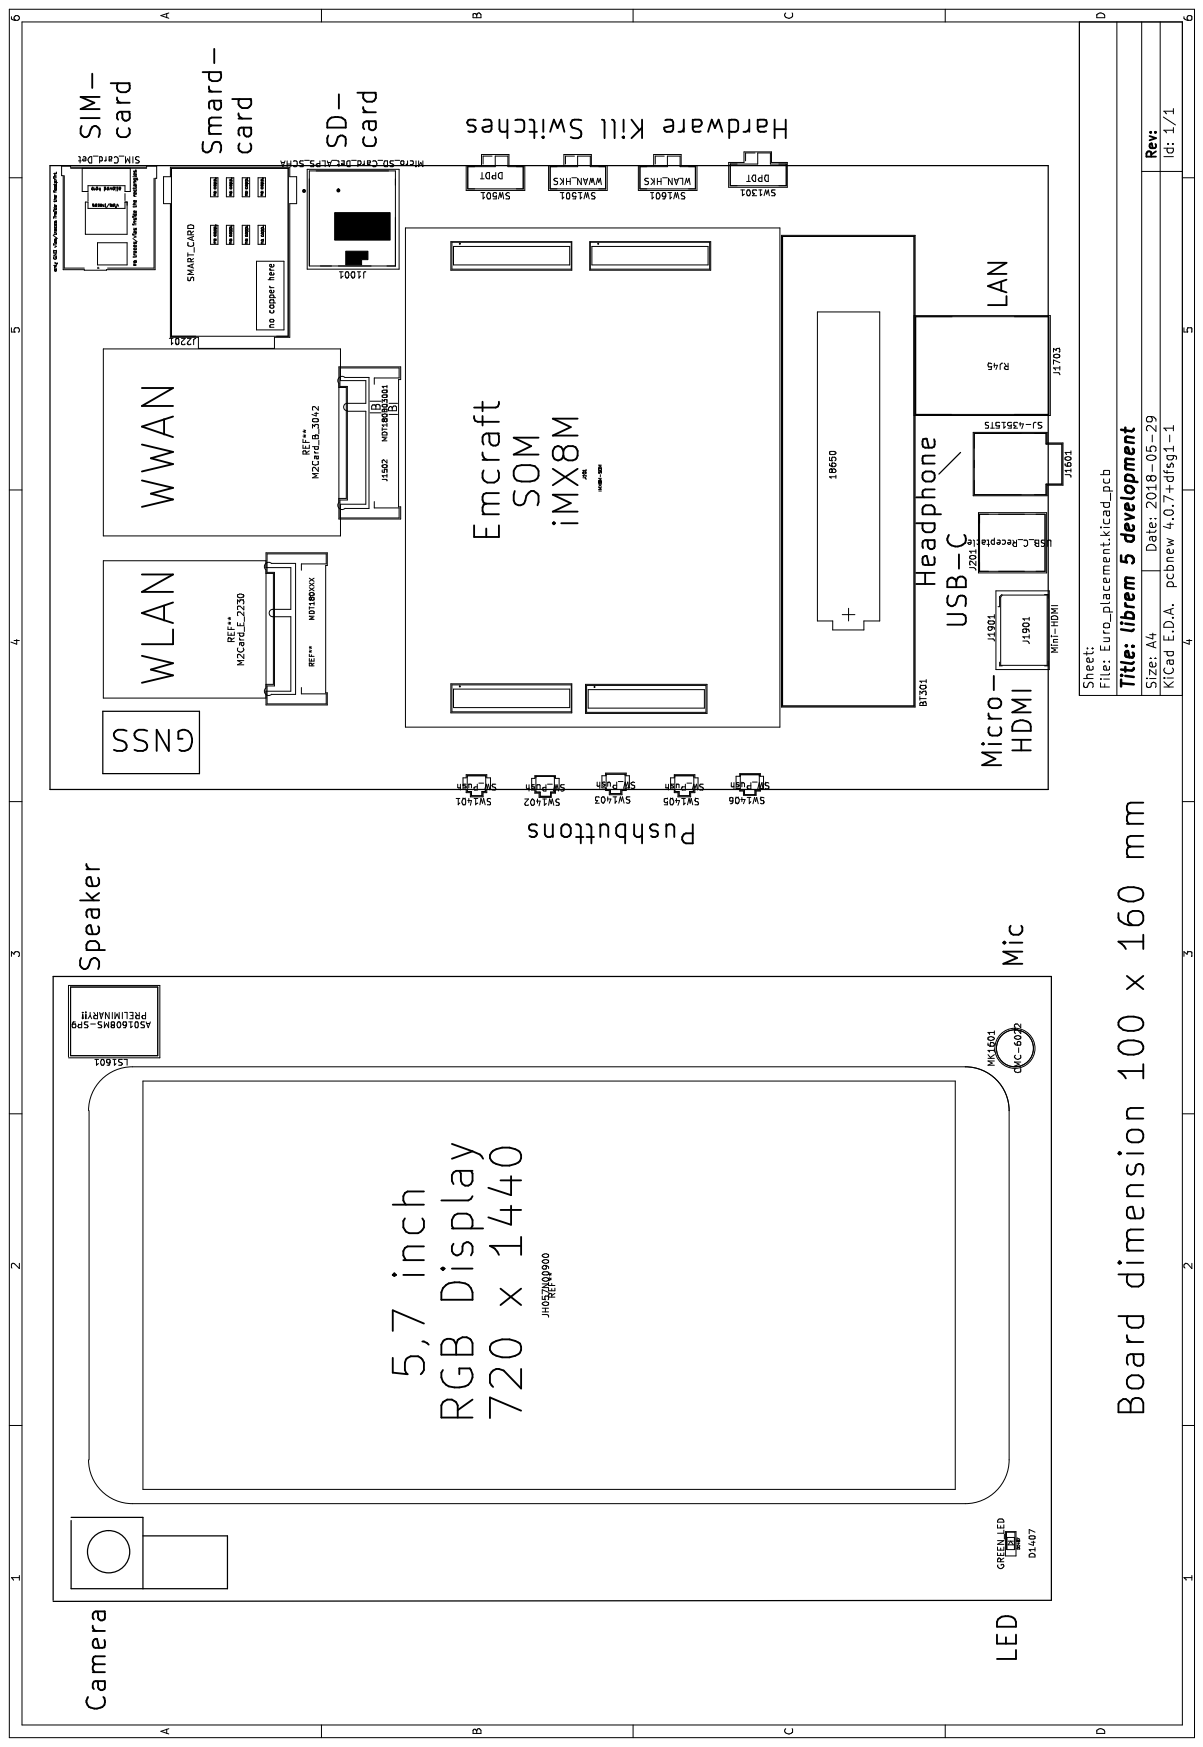
[picture p44: page 1]
