gralco/dvk-mx8m-bsb/manufacturing/dvk-mx8m-bsb-assembly.pdf

1 | 2 | 3 | 4

A

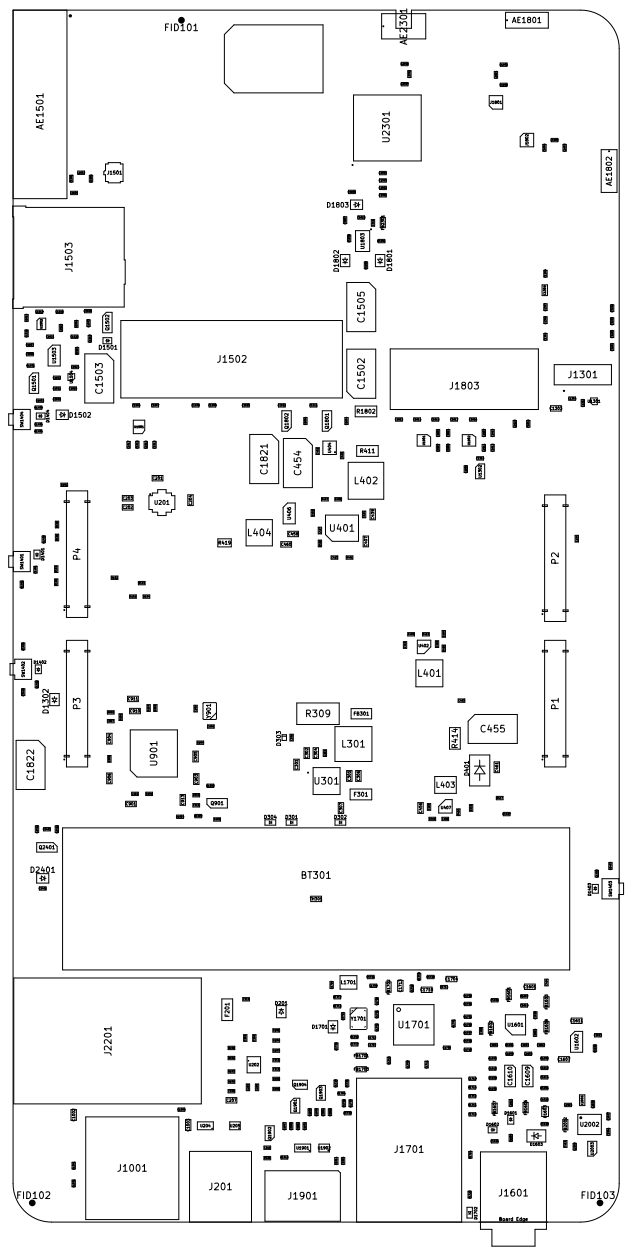
[picture p45: page 1]

Id: 1/1 Librem 5 Dev Kit

eric.kuzmenko@puri.sm
angus.ainslie@puri.sm
nicole.faerber@puri.sm

1 | 2 | 3 | 4

A

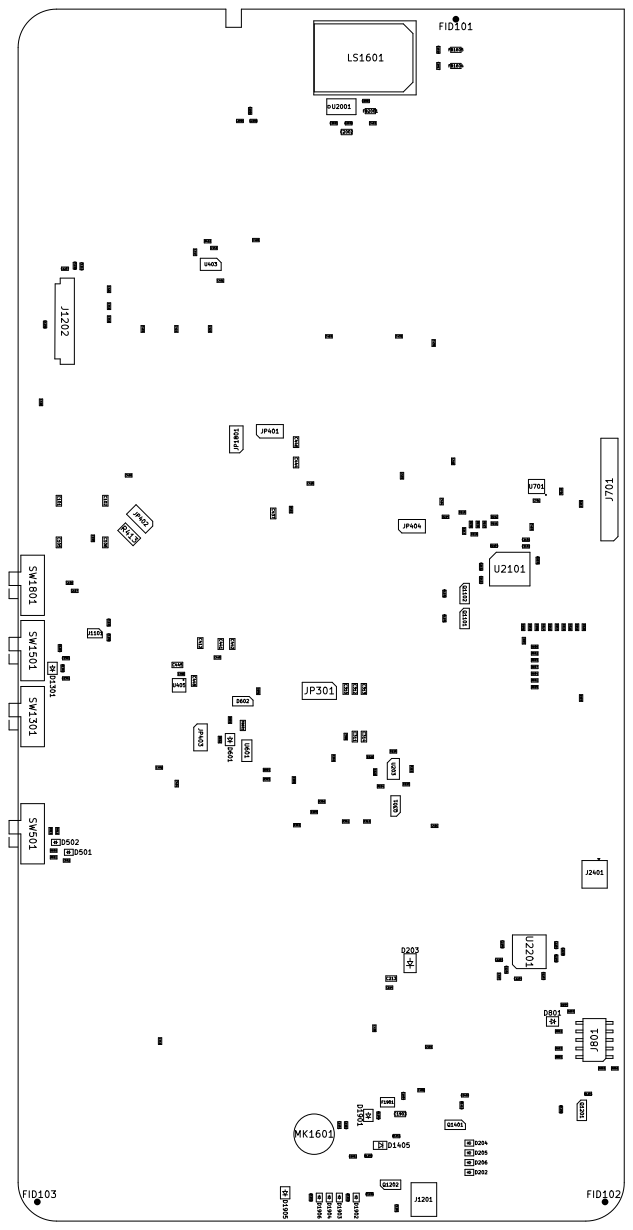
[picture p46: page 2]

Id: 1/1 Librem 5 Dev Kit

eric.kuzmenko@puri.sm
angus.ainslie@puri.sm
nicole.faerber@puri.sm
