gralco/dvk-mx8m-bsb/manufacturing/dvk-mx8m-bsb-fabrication.pdf

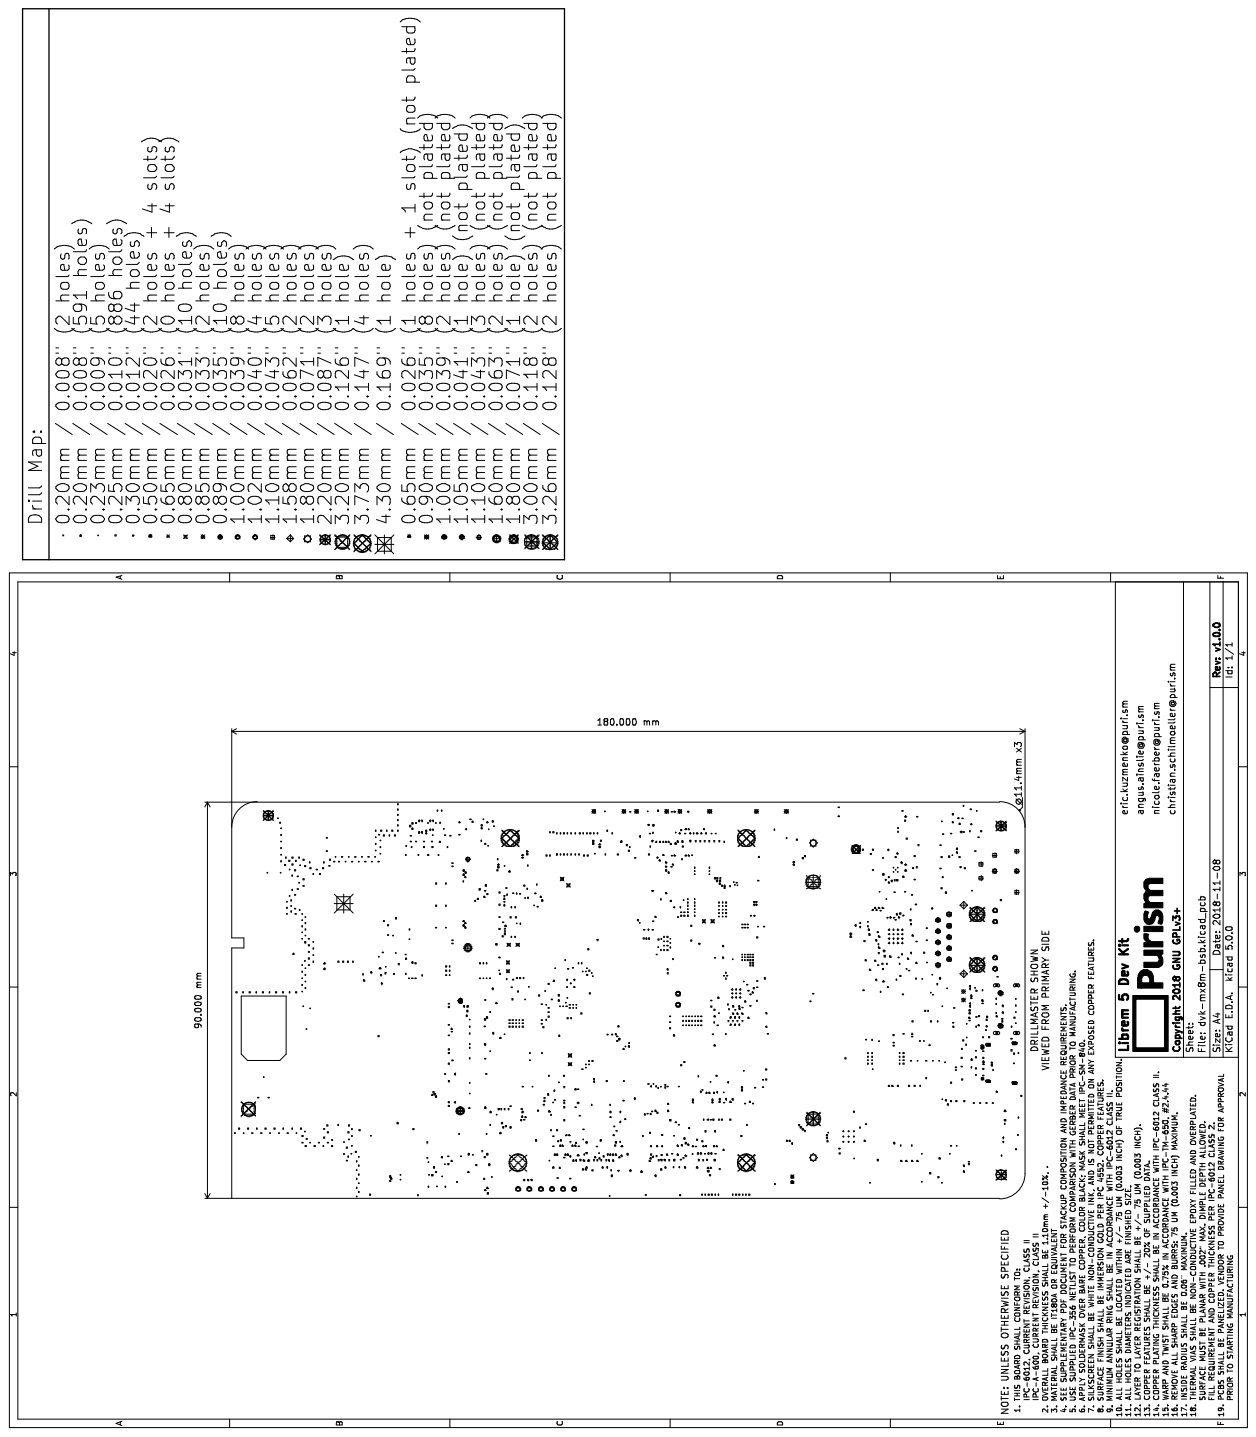
[picture p47: page 1]
