gralco/dvk-mx8m-bsb/calculations/final/PN DVK-MX8M-BSB--panel drawing (11.29.18).pdf

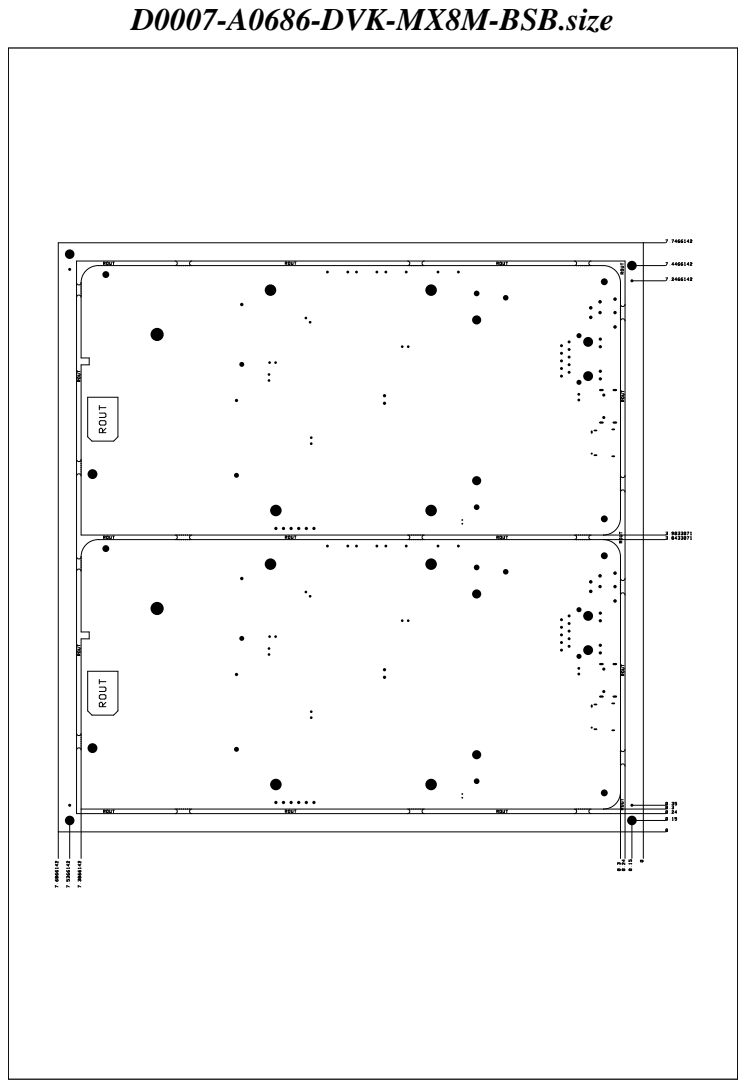
[picture p48: page 1]

D0007-A0686-DVK-MX8M-BSB.size
