gralco/dvk-mx8m-bsb/(commit log)

2018-03-26 Begin creating the DART-MX8M schematic symbol
    [dvk-dart-mx8m.kicad_pcb, dvk-dart-mx8m.sch]
2018-03-27 Complete pin name entries
    Still need to set some of the pins' electrical types.
    [dvk-dart-mx8m.sch]
2018-03-27 Seperate the pin numbers according to their respective connectors
2018-03-27 Connect power symbols to the respective pins of the SoM
    [dvk-dart-mx8m.sch]
2018-03-31 Add SGTL5000 audio CODEC and begin schematic around it
    [audio.sch, battery.sch, dvk-dart-mx8m.sch]
2018-04-03 Begin the DART-MX8M footprint
2018-04-03 Add TPS63020 buck-boost regulator for either li-ion battery or 5V supply
    Output voltage is ~3.8V or about what VBATT is expected to be
    [battery.sch]
2018-04-04 Update the schematic library and notes based on the switch from RT6154A to TPS63020
    [audio.sch, battery.sch, dvk-dart-mx8m.sch]
2018-04-05 Complete the SOM_VBAT regulator circuit, add RTC circuit and 3.3V regulator for BASE_PER_3V3
    Passing ERC
    [audio.sch, battery.sch, dvk-dart-mx8m.sch, power.sch, rtc.sch]
2018-04-05 Update pin types and names based on new DART-MX8M datasheet rev release
    Rev 1.03 was just released with a date of Apr 1, 4 days late, pin changes were made on Feb 25th but not released (until now). Seems to more closely resemble the schematic, except for CLK1_* and CLK2_*.
    [audio.sch, dvk-dart-mx8m.sch, power.sch, rtc.sch]
2018-04-05 Add the board ID EEPROM chip and move the 0Ohm resistor such that the coin cell battery would actually power SOM_SNVS_3V3 when removed and the NC resistor is populated
    This re-arrengment of the resistor makes the reference schematic more clear knowing that SOM_VBAT_3V3 is not actually LICELL.
    [audio.sch, battery.sch, dvk-dart-mx8m.sch, power.sch, rtc.sch]
2018-04-05 Add reset & watchdog, sd power, and BASE_PER_1V8 circuits
    [audio.sch, battery.sch, dvk-dart-mx8m.sch, power.sch, rtc.sch, watchdog.sch]
2018-04-06 Add PTC Fuse, zener on VCC_PJ, USB PD current-limiting switch, 5V regulator, and make regulators' VINA=VIN (since VIH is 1.2V)
    Equation for setting NX5P3090's current limit is included.
    [audio.sch, battery.sch, dvk-dart-mx8m.sch, power.sch, rtc.sch, usb.sch, watchdog.sch]
2018-04-06 Figure out 5.0V buck-boost's inductor value, include inductor current calculations
    [battery.sch, power.sch, usb.sch]
2018-04-06 Use MIC2876 instead of RT6150A due to several advantages which are noted in the schematic
    [battery.sch, power.sch, usb.sch]
2018-04-07 Use a buck for the 1.8V rail for efficiency, include power line ferrite bead, change main buck-boost output caps to 0805 ones, move the main regulator's input caps to the VIN node, include USB power 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
    The 1.8V buck has a drop-in: "ST1S12G18R"
    [audio.sch, battery.sch, dvk-dart-mx8m.sch, power.sch, rtc.sch, usb.sch, watchdog.sch]
2018-04-08 Include uSD card schematic, add note about testing 1.8V LDO in place of the buck
    [audio.sch, battery.sch, dvk-dart-mx8m.sch, power.sch, rtc.sch, sd.sch, usb.sch, watchdog.sch]
2018-04-08 Add UART USB cable options, cheaper to bring out UART pins than to implement USB<->Serial adapter on-board
    [dvk-dart-mx8m.sch]
2018-04-08 Include UART debug interface/header, using a 74LVC2G241 buffer which is 5V tolerant so that either 3.3V or 5V UART cables could be used
    Six pin header used so that either 6-pin fixed, 4-pin, or 3-pin cables can be used. Only RX, TX, and GND are used since Vcc, RTS#, and CTS# is unneeded, the other three pins are NC.
    [audio.sch, battery.sch, dvk-dart-mx8m.sch, power.sch, rtc.sch, sd.sch, uart.sch, usb.sch]
2018-04-09 Include boot configuration circuit and notes regarding booting from eMMC (USDHC1) vs SD (USDHC2)
    [audio.sch, battery.sch, boot.sch, dvk-dart-mx8m.sch, power.sch, rtc.sch, sd.sch, uart.sch]
2018-04-09 Reorder sheets based on importance
    [audio.sch, battery.sch, boot.sch, dvk-dart-mx8m.sch, power.sch, rtc.sch, sd.sch, uart.sch]
2018-04-09 Add JTAG and buttons & LED schematics, reorder based on priority (especially for debugging/development)
    [audio.sch, battery.sch, boot.sch, buttons_led.sch, dvk-dart-mx8m.sch, jtag.sch, power.sch, rtc.sch]
2018-04-10 Add MIPI DSI, cap touch interface, and AMOLED display regulator circuits
    TPS65632's components were selected based on the best match and price based on suggestions. The RT4720 does not seem to be sold by any distributors.
    [audio.sch, battery.sch, boot.sch, buttons_led.sch, dvk-dart-mx8m.sch, jtag.sch, mipi_dsi.sch, power.sch]
2018-04-11 Add 3.0V LDO for display's VCI and TP_VCC, include a 3~12ms rise time delay for the 1.8V rail to turn on before the 3.0V rail, begin the WWAN M.2 schematic (found a a low-profile key B connector)
    [audio.sch, battery.sch, boot.sch, buttons_led.sch, dvk-dart-mx8m.sch, jtag.sch, mipi_dsi.sch, power.sch]
2018-04-12 Add sim card slot, ESD protection, and relevant notes regarding the expected M.2 configuration
    [audio.sch, battery.sch, boot.sch, buttons_led.sch, dvk-dart-mx8m.sch, jtag.sch, mipi_dsi.sch, power.sch]
2018-04-13 Route SIM card slot to M.2, add SIM2 slot, use null modem for the optional UART interface for modules such as the SIM7100 (no DCD, DTS, DTR, CTS)
    [dvk-dart-mx8m.sch, wwan_m2.sch]
2018-04-13 Include HKS for baseband modem M.2 module
    Low-pass filter included for switch ckt, rise and fall time should be nearly identical with the presence of a schottky diode. Since the M.2 spec calls out a >20Kohm resistor to GND on the ~FULL_CARD_POWER_OFF pin then then a voltage divider is formed between this resistor and the one to VBAT (min of ~2.2V, actually >2.4V).
    [dvk-dart-mx8m.sch, jtag.sch, wwan_m2.sch]
2018-04-16 Add 1.8V<->3.3V logic level shifter (NTS0102) for the WWAN M.2 slot and connect it to the i.MX8M's UART3
    The NTS0102 explicitly lists UART as one of its applications, and contains internal 10k pull-up resistors for the outputs. Whereas NTB/TXB0102 are push-pull outputs but aren't intended for UART applications due to the following (needs testing):
    "The subtlety here is that you need to be careful of the auto direction sense circuitry. Works fine but there can be some gotchas."
    "If there is a signal integrity concern which is generally not the case for UARTs, series ~32 Ohm resistors on TX output pins can help. For the exact resistor value you need to look at the V/I curve of the transmitte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
    [dvk-dart-mx8m.sch, uart.sch, wwan_m2.sch]
2018-04-16 Bring out M.2 signals to the main sheet and attach WoWWAN and RESET
    Add notes regarding the WWAN M.2's USB interface. The Emcraft SoM has NAND_CE3_B available for the DISABLE pin. Still need to select which pin will be used for CONFIG_1.
    [audio.sch, battery.sch, boot.sch, buttons_led.sch, dvk-dart-mx8m.sch, jtag.sch, mipi_dsi.sch, power.sch]
2018-04-16 Add logic level shifter for WWAN PCM interface, assign CONFIG_0 to GPIO3_IO20, use SAI6 for WWAN PCM since the baseband modem can be either master or slave (e.g. SIM7100 is always master)
    [audio.sch, dvk-dart-mx8m.sch, wwan_m2.sch]
2018-04-16 Rename project based on the EmCraft SoM
    [audio.sch, battery.sch, boot.sch, buttons_led.sch, dvk-mx8m-bsb.kicad_pcb, dvk-mx8m-bsb.sch, jtag.sch, mipi_dsi.sch]
2018-04-17 Begin creating the IMX8M-SOM schematic symbol, remove the old DART-MX8M symbol
    [audio.sch, dvk-mx8m-bsb.sch, wwan_m2.sch]
2018-04-18 Assign all associated signals to their respective pins on the EmCraft i.MX8M SoM
    The ERC is now at the same state as the DART SoM schematic. Need to compare various aspects of the current schematic against the EmCraft reference design. The main buck-boost will likely need to be switched to a 5V regulator, or be configured to output 5V.
    A regulator will likely need to be added which will output some VBAT voltage level (3.5~4.2V) for the M.2 cards. The SIM7100 for example requires at least 3.4V!
    [audio.sch, battery.sch, boot.sch, buttons_led.sch, dvk-mx8m-bsb.sch, jtag.sch, mipi_dsi.sch, power.sch]
2018-04-18 Use "Start to sheet number*100 and use first free number" designation, any new component added to the schematic will occupy the next available number in that sheet
    For example: if sheet 2 has R201-R215 and we add a new resistor it will become R216.
    [audio.sch, battery.sch, boot.sch, buttons_led.sch, dvk-mx8m-bsb.sch, jtag.sch, mipi_dsi.sch, power.sch]
2018-04-18 Move reference designators in the schematic so that they are legible
    [audio.sch, battery.sch, boot.sch, buttons_led.sch, dvk-mx8m-bsb.sch, jtag.sch, mipi_dsi.sch, power.sch]
2018-04-19 Include reverse polarity protection circuit along with a simulation showing its effectiveness
    Protecting VBAT from when board is sinking current via USB C. Protects against reverse polarity at the DC jack.
    In EmCraft's instance VBUS should only be 5V when sinking current but they must protect against the condition when VBUS>12V and DC_IN=12V. This may need testing.
    [audio.sch, battery.sch, boot.sch, buttons_led.sch, dvk-mx8m-bsb.sch, jtag.sch, mipi_dsi.sch, power.sch]
2018-04-19 Stick the WWAM M.2 sheet above/before the audio sheet
    [audio.sch, dvk-mx8m-bsb.sch, power.sch, wwan_m2.sch]
2018-04-20 Add USB type C circuit with DRP PD capability, should sink near 2A @ 5-6.5V and source 550mA @ 5V
    Removed the reverse current protection circuit from the last commit due to the requirement changing to only 18650 battery and USB-C being possible power sources
    Next thing to add is the charging circuit when the USB-C is in sink mode/role
    [audio.sch, battery.sch, boot.sch, buttons_led.sch, dvk-mx8m-bsb.sch, jtag.sch, mipi_dsi.sch, power.sch]
2018-04-20 Replace instances of VSYS with VBAT to remove redundancy
    In the case where VBAT can drop below 3.3V then it may be required to use a buck-boost in place of the existing buck converter for the 3.3V rail; may need some testing. Using the +5V rail as an input would also work but would introduce additional losses. According to several sources, when a 18650 Li-ion reaches 3.3V it is practically depleted anyway. When the feedback voltage drops below the internal reference voltage the buck converter will be in its "low dropout operation" with a duty cycle of 100%, so the output voltage should closely follow the input voltage.
    [battery.sch, power.sch]
2018-04-24 Include li-ion charge controller PMIC which implements VBAT UVLO, VBAT OVP, input/output OVP & OCP; completely removed the old buck-boost in favor of this fully integrated chip
    The BQ25896 may be able to handle the USB-C DRP PD switch all on its own (needs further investigation).
    [battery.sch, dvk-mx8m-bsb.sch, power.sch, usb-c.sch]
2018-04-25 Have the charge controller IC handle the USB-C DRP PD switch mechanism, notes added on what procedure is required to operate as sink/source and how to swap between these roles
    The mainline kernel's TCPM implementation needs to be used in conjunction with the charge controller IC's interface. For example, if the TCPC (PTN5110HQ CC controller) has the USB configured as a sink role then the TCPM (i.MX8M) would read out the CC_STATUS and POWER_STATUS registers of the CC controller IC to know this is the case, and then it (i.MX8M) would configure the charge controller IC accordingly (sink current from VBUS).
    Both the CC controller and charge controller's open-drain output interrupt pins are tied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
    [audio.sch, battery.sch, boot.sch, buttons_led.sch, dvk-mx8m-bsb.sch, jtag.sch, mipi_dsi.sch, power.sch]
2018-04-25 Use the main 18650 battery for the RTC (instead of a coin-cell), include information about which battery has been narrowed down to be the best option (NCR18650BD), remove 2K EEPROM used for the board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
    [battery.sch, power.sch, rtc.sch, usb-c.sch]
2018-04-27 Modify the boot config pins such that the eMMC is an 8-bit bus, depressing a momentary push button switch during boot causes SD boot, and relevant options
    [audio.sch, battery.sch, boot.sch, buttons_led.sch, dvk-mx8m-bsb.sch, jtag.sch, mipi_dsi.sch, power.sch]
2018-04-27 Begin USB 2.0 hub circuit for M.2 modules, remove supervisory/voltage monitor/watchdog circuit since the EmCraft SoM implements it
    USB 2.0 hub circuit still needs to be completed.
    [audio.sch, battery.sch, boot.sch, buttons_led.sch, dvk-mx8m-bsb.sch, jtag.sch, mipi_dsi.sch, power.sch]
2018-04-30 Complete more of the USB hub circuit, connect one of the downstream ports to the WWAN M.2 module, remove the unused VBUS rail, add notes regarding the USB-C port having its corresponding ID pin pulle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
    [audio.sch, battery.sch, buttons_led.sch, dvk-mx8m-bsb.sch, mipi_dsi.sch, usb-c.sch, usb_hub.sch, wwan_m2.sch]
2018-05-02 Begin WiFi+BT M.2 socket circuit, connect the associated USB bus from the hub circuit, determined that the i.MX8M's UART's default POR state is such that CTS is an output and RTS is an input and assi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
    [audio.sch, battery.sch, boot.sch, buttons_led.sch, dvk-mx8m-bsb.sch, jtag.sch, mipi_dsi.sch, power.sch]
2018-05-02 * added footprints * changes in library to make footprints usable (esp. numbering scheme of SOM9 * assigned footprints to schematic symbols
    [battery.sch, boot.sch, dvk-mx8m-bsb.sch, mipi_dsi.sch, usb_hub.sch, wifi_bt_m2.sch, wwan_m2.sch]
2018-05-02 added links to datasheets
    [audio.sch, battery.sch, power.sch, sd.sch, usb-c.sch]
2018-05-02 added .gitignore (avoid *.bak files in git) added library symbol and footprint of minipcie socket for later use
2018-05-02 Add MicroSD footprint from selection, add PDF file with searchable/highlightable text
    [battery.sch, boot.sch, dvk-mx8m-bsb.sch, mipi_dsi.sch, sd.sch, usb_hub.sch, wifi_bt_m2.sch, wwan_m2.sch]
2018-05-02 Bring back the *-cache.lib file as it is a very important in case someone opens the schematic and is missing any of the symbols used
2018-05-02 Add demultiplexer to uSDHC2 for the uSD and WiFi's SDIO interfaces, include the DEMUX's (TS3A27518E) 24QFN footprint
    [audio.sch, battery.sch, boot.sch, buttons_led.sch, dvk-mx8m-bsb.sch, jtag.sch, mipi_dsi.sch, power.sch]
2018-05-03 Footprints of SD card socket and demultiplexer assigned
    [sd.sch, sdio_demux.sch]
2018-05-04 Add I2C interface to WiFi/BT M.2, select an appropriate dual 2-input AND gate IC for the W_DISABLE logic and add the corresponding debounce/pull-down circuit to the HKS for W_DISABLE
    Notes have been included regarding the I2C logic level voltage. If the USB interface is used then the input voltage needs to be 5.0V (not 3.3V); therefore the USB interface and hub may need to be removed!
    Several signals are unused by the RS9116 WiFi/BT module, as noted in the schematic.
    [dvk-mx8m-bsb.sch, sdio_demux.sch, wifi_bt_m2.sch, wwan_m2.sch]
2018-05-04 Organize the USB-C, Battery, and Power sheets at the top-level such that the power-flow makes more sense when reading the schematic
    [audio.sch, battery.sch, boot.sch, buttons_led.sch, dvk-mx8m-bsb.sch, jtag.sch, mipi_dsi.sch, power.sch]
2018-05-05 Assign verious signals such as W_DISABLE1, W_DISABLE2, WWAN_DISABLE; reorder the hierarchy to make more sense; add "solid" graphic lines around the power signals on the top sheet for clarity
    [audio.sch, battery.sch, boot.sch, buttons_led.sch, dvk-mx8m-bsb.sch, jtag.sch, mipi_dsi.sch, power.sch]
2018-05-07 Add ethernet PHY schematic, assign the RGMII signals, and include its associated 48-QFN footprint
    [audio.sch, battery.sch, boot.sch, buttons_led.sch, dvk-mx8m-bsb.sch, ethernet.sch, jtag.sch, mipi_dsi.sch]
2018-05-08 Include RJ45 connector selection information (likely using JD1-0001NL)
    [ethernet.sch]
2018-05-09 Continue with the audio CODEC schematic, selected a potential STIA 3.5mm headphone jack, use logic level shifters on the WWAN/BT M.2's UART and PCM interfaces since the M.2 spec states that these are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
    Still need to assign the corresponding SAI interface for the BT.
    [audio.sch, buttons_led.sch, dvk-mx8m-bsb.sch, ethernet.sch, mipi_dsi.sch, sdio_demux.sch, wifi_bt_m2.sch, wwan_m2.sch]
2018-05-10 Introduce a method to switch between built-in and headset microphone depending on the presence of something plugged into the 3.5mm headphone jack, included notes regarding measurements, simulations, 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
    Zener diode included to protect the GPIO pin against under/over voltage from HP_OUT. Schmitt-trigger inverted at the enable pin of the analog switch for some debouncing.
    [audio.sch, battery.sch, boot.sch, buttons_led.sch, dvk-mx8m-bsb.sch, ethernet.sch, jtag.sch, mipi_dsi.sch]
2018-05-10 Update the text parsable PDF based on the last commit
    Also fix a small typo in the notes from the last commit.
    [audio.sch]
2018-05-11 Add built-in speaker and class-D amplifier to drive it from lineout, use an anal og SPDT switch to select internal or external mic via software (GPIO), select sp ecific 8Ohm SMD speaker and SMD -37dB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
    [audio.sch, battery.sch, boot.sch, buttons_led.sch, dvk-mx8m-bsb.sch, ethernet.sch, jtag.sch, mipi_dsi.sch]
2018-05-11 Add HDMI schematic and connector footprint (using SMD type D/micro-HDMI receptacle)
    [audio.sch, battery.sch, boot.sch, buttons_led.sch, dvk-mx8m-bsb.sch, ethernet.sch, hdmi.sch, jtag.sch]
2018-05-12 Add Proximity+Ambient Light sensor and 9-axis IMU circuits to the "sensors" schematic sheet, include the associated footprints and assign them to the respective symbols
    The 9-axis IMU is configured to use I2C(1) rather than SPI. Notes are included regarding the IMU's setup. Descriptions of the IMU state that it is "fully compliant with Android" and therefore drivers must be available.
    [audio.sch, battery.sch, boot.sch, buttons_led.sch, dvk-mx8m-bsb.sch, ethernet.sch, hdmi.sch, jtag.sch]
2018-05-12 Add +X direction in the IMU's footprint on the F.SilkS layer, include figures in the schematic which show the corresponding axis directions (for both gyro/accel & compass) with respect to the package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
    Also double checked the footprint's pad sizes against the given package dimensions (no landing pattern given).
    [sensors.sch]
2018-05-12 Add the IMU's pin 25 thermal GND pad to the circuit
    [sensors.sch]
2018-05-14 Add NOR flash chip schematic, use mini-HDMI (requested) instead of micro and add its corresponding properties and footprint, use 3.5mm CTIA headset jack with through-hole pins rather than an SMD one 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
    Will likely want to use a USB-C receptacle with through-hole shield pins.
    [audio.sch, battery.sch, boot.sch, buttons_led.sch, dvk-mx8m-bsb.sch, ethernet.sch, flash.sch, hdmi.sch]
2018-05-15 Add haptic/vibration motor circuit
    Using a PFET to switch the high-side. The motor will likely be coin-shaped with adhesive on the back to stick to a designated spot on the board and have a 2-pin Molex or JST connector installed on the wire leads (by request).
    [audio.sch, battery.sch, boot.sch, buttons_led.sch, dvk-mx8m-bsb.sch, ethernet.sch, flash.sch, haptic.sch]
2018-05-15 Use SN74AUP2G08 instead of SN74AUP2G00 since the *08 is AND whereas the *00 is N AND
    Since pin 54 is actually USB_VBUS sink on the RedPine module the baseboard may need to treat this pin specially (NXP EVK uses a NMOS inverter with a 10k pull-up to 3V3).
    [wifi_bt_m2.sch]
2018-05-16 Assign SAI5 to the WLAN/BT M.2, remove SIM2 slot due to conflicts between modules (specifically the L830-EB being a Config_0 module where the TX_BLANKING signal would connected to USIM_PWR2 sink), re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
    The MIC_SEL, PROX_~INT, IMU_INT, and HAPTIC signals still need assigning
    [audio.sch, boot.sch, buttons_led.sch, dvk-mx8m-bsb.sch, ethernet.sch, flash.sch, haptic.sch, hdmi.sch]
2018-05-17 Use a DP3T switch to select between eMMC, USB (serial download), and uSD boot devices, corrected the SW_BACK and SW_HOME buttons to have 33Ohm pull-ups instead of pull-downs since the respective boot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
    These buttons should be untouched during boot otherwise the board will not boot properly (pressing SW_HOME during boot causes "SD power cycle enable/eMMC reset enable" and pressing SW_BACK causes the uSD to be treated as a 4-bit bus if it's the boot device otherwise it's a BOOTCONFIG[6:4]=011 "reserved" condition)
    [audio.sch, battery.sch, boot.sch, buttons_led.sch, dvk-mx8m-bsb.sch, ethernet.sch, flash.sch, haptic.sch]
2018-05-17 Include power load switch ICs to the 3.3V and 5V rails so that the SoC can disable the peripherals' power using the PWR_EN signal
    Need to verify that 3V3's capacitance is greater than 3V3_P!
    Next step is to have PWR_EN control the various logic translator chips EN pins.
    [audio.sch, battery.sch, boot.sch, buttons_led.sch, dvk-mx8m-bsb.sch, ethernet.sch, flash.sch, haptic.sch]
2018-05-18 Add current sense resistors and jumper symbols in the schematic, assign the various signals left unspecified, complete the PWR_EN assignment and verify that thepower sequence would be brought up in t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
    Both the GP_LED1 and the HAPTIC motor are able to be controlled via PWM2 by individually MUXing the corresponding pads to PWM2. Only one pin should be MUXed to PWM2 at a time whilst the other is a GPIO, otherwise they will behave identically.
    The I2C buses do not need the bus switch found on the EmCraft baseboard since the M.2 modules' power is controlled by PWR_EN and their I2C is l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
    [audio.sch, battery.sch, boot.sch, buttons_led.sch, dvk-mx8m-bsb.sch, ethernet.sch, flash.sch, haptic.sch]
2018-05-18 Added schematic page with USB hub/SD Card controller USB2660 deleted old USB hub and SDIO demultiplexer
    [audio.sch, battery.sch, boot.sch, buttons_led.sch, dvk-mx8m-bsb.sch, ethernet.sch, flash.sch, haptic.sch]
2018-05-18 Connect the USB/SDIO bridge to WLAN rather than the uSD, fix a few ERC violations (not has zero errors/warnings), use best schottky option
    [audio.sch, battery.sch, boot.sch, buttons_led.sch, dvk-mx8m-bsb.sch, ethernet.sch, flash.sch, haptic.sch]
2018-05-18 Flip the direction of FULL_CARD_POWER_OFF# and W_DISABLE*# switches such that the devices are on when the switch is open, this should ever so slightly reduce the power consumption when these devices 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
    [audio.sch, battery.sch, boot.sch, buttons_led.sch, dvk-mx8m-bsb.sch, ethernet.sch, flash.sch, haptic.sch]
2018-05-18 Add MIPI CSI sheet (contents need to be added once camera selection is complete)
    [audio.sch, battery.sch, boot.sch, buttons_led.sch, dvk-mx8m-bsb.sch, ethernet.sch, flash.sch, haptic.sch]
2018-05-22 Begin assigning footprints to passive components, add component information to the common 10k resistors throughout the schematic, include TVS diodes on the switch/button I/O pins, use the DB2J20900L 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
    Added notes about the battery holder, battery size, and the fact that the 103HT thermistor can fit underneath the 18650 battery when the battery is insterted into the holder.
    Included frequency response curve for the new/cheaper SMD speaker (slightly thicker mechanical dimension).
    Included note about the RedPine RS9116's SDIO_RESET# line expecting a 2.31V VIH logic level, increased the pull-up to 100k (M.2 standard states that this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
    [audio.sch, battery.sch, boot.sch, buttons_led.sch, dvk-mx8m-bsb.sch, ethernet.sch, flash.sch, haptic.sch]
2018-05-22 Move MIPI DSI & CSI sheets into a "MIPI" sheet, both DSI and CSI will likely use the I2C level shifter
    [audio.sch, battery.sch, boot.sch, buttons_led.sch, csi.sch, dsi.sch, dvk-mx8m-bsb.sch, ethernet.sch]
2018-05-23 added + assigned footprint for battery holder
    [battery.sch]
2018-05-23 added outline of display into footprint directory (drawing in fabrication layer only) (usable only for pcb size estimations)
2018-05-23 Add Prolific MA8627 USB hub + SDIO bridge chip and use it in place of the USB2660, SD interface used with the uSD (not WLAN)
    [audio.sch, battery.sch, buttons_led.sch, dsi.sch, dvk-mx8m-bsb.sch, ethernet.sch, flash.sch, haptic.sch]
2018-05-24 Add smart card circuit using the SEC1110 USB to ISO/IEC 7816 bridge chip, include ID-0001/2FF/mini-SIM socket connector selection informatino (1010027182)
    Need to create footprint for the mini-SIM socket
    [audio.sch, battery.sch, boot.sch, buttons_led.sch, csi.sch, dsi.sch, dvk-mx8m-bsb.sch, ethernet.sch]
2018-05-24 Make changes to the USB hub + SD bridge circuit and uSD sheet based on Prolific's feedback after asking questions
    [audio.sch, buttons_led.sch, dsi.sch, ethernet.sch, flash.sch, haptic.sch, hdmi.sch, mipi.sch]
2018-05-24 added footprint for USB C receptacle
2018-05-24 add and assigned footprint for smartcard holder
    [smartcard.sch, usb-c.sch]
2018-05-24 Modify the boot config/boot mode pins and switch such that only eMMC and USB (serial downloader) are boot options due to the uSD being attached to the USB<->SD bridge chip, add OV5460 notes about usi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
    [audio.sch, boot.sch, buttons_led.sch, csi.sch, dsi.sch, dvk-mx8m-bsb.sch, ethernet.sch, flash.sch]
2018-05-24 Add LCD display's 22.4V (@40mA) LED backlight driver/boost converter IC circuit (PAM2841), selected the rectifying/schottky diode (SS14), and set the OVP to 37.6V as found on the IC's EVB
    [audio.sch, boot.sch, buttons_led.sch, dsi.sch, dvk-mx8m-bsb.sch, ethernet.sch, flash.sch, haptic.sch]
2018-05-25 Nearly complete the LCD/DSI and cap-touch schematic, add notes from the display's datasheet regarding the various pin assignments, add component property information for the 39-pin DSI clamshell conn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
    Still need to determine what this requested "low power state signal" requirement is for the display.
    [audio.sch, battery.sch, boot.sch, buttons_led.sch, dsi.sch, dvk-mx8m-bsb.sch, ethernet.sch, flash.sch]
2018-05-25 Use the 2SK3018 NMOS for all low-current applications such as level-shifting
    [battery.sch, dsi.sch, mipi.sch, sensors.sch, wifi_bt_m2.sch]
2018-05-25 added footprints for microphone, speaker and tactile switches (very preliminary, only to be able to represent user accessible components at the front)
    [audio.sch, buttons_led.sch]
2018-05-26 Replace ICM-20948 IMU with the LSM90S1, replace RPR-0521RS prox+ambient light sensor with the VCNL4040
    [audio.sch, boot.sch, dvk-mx8m-bsb.sch, flash.sch, haptic.sch, sensors.sch, smartcard.sch]
2018-05-26 Add bypass caps to logic gates used with the W_DISABLE and the 9-axis IMU's INT pins
    [audio.sch, battery.sch, boot.sch, buttons_led.sch, dsi.sch, dvk-mx8m-bsb.sch, ethernet.sch, flash.sch]
2018-05-28 Add camera/CSI circuit, include second switch that is part of the audio+camera DPDT for killing both simultaneously, level shifters used for camera's I/O that requires it, footprints for a 1.8V LDO w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
    External DVDD (1.8V LDO) needs to be tested if it's needed (datasheet says an internal DVDD can be used, as is the case with Boundary Devices' OV5640 camera).
    [audio.sch, battery.sch, boot.sch, buttons_led.sch, csi.sch, dsi.sch, dvk-mx8m-bsb.sch, ethernet.sch]
2018-05-28 added footprints for switches and phone jack new wiring of DPDT switches for HKS purposes
    [audio.sch, battery.sch, boot.sch, csi.sch, dsi.sch, sd.sch, sensors.sch, wifi_bt_m2.sch]
2018-05-29 Begin GNSS schematic using MAX-M8 module
    Since UART2 isn't brought out then will either need to use UART1 (debug) with jumpers or the module's I2C interface.
    Resolve merge conflict after pulling recent commit, now can no longer use SSH (since Gogs is getting abandoned?).
    [audio.sch, battery.sch, boot.sch, buttons_led.sch, csi.sch, dsi.sch, dvk-mx8m-bsb.sch, ethernet.sch]
2018-05-29 Assign the MAX-M8 footprint to the corresponding component symbol
    [gnss.sch]
2018-05-29 added component information and footprint for ethernet magjack
    [ethernet.sch]
2018-05-29 modifications to library symbol and footprint of ethernet magjack
    [audio.sch, battery.sch, boot.sch, csi.sch, dsi.sch, ethernet.sch, sd.sch, sensors.sch]
2018-05-29 Assign UART3 to the GNSS module, remove this UART3 from the WWAN M.2 and assign GPIO5_IO03 to DPR
    [audio.sch, battery.sch, boot.sch, csi.sch, dsi.sch, dvk-mx8m-bsb.sch, ethernet.sch, flash.sch]
2018-05-29 added pdf with experimental placing of main components on a board size of 160 x 100
2018-05-29 Add WWAN and WLAN+BT MHF4 coax connectors and antennae symbols to the schematic, remove home and back buttons, reorder sheets so that GNSS is above the haptic motor sheet
    [audio.sch, buttons_led.sch, csi.sch, dsi.sch, dvk-mx8m-bsb.sch, ethernet.sch, flash.sch, gnss.sch]
2018-05-30 added pdf-file with new ideas for placement (board size taller but narrower, room for diversity antennas in upper part)
2018-05-30 Modify the CSI circuit to use a 02x15 connector for potential use with the CO8725-B5SA-E camera, include cap touch FPC connector details, make minor adjustments to GNSS antenna circuit
    [audio.sch, buttons_led.sch, csi.sch, dsi.sch, ethernet.sch, flash.sch, gnss.sch, haptic.sch]
2018-05-31 Add IRQ# signal coming from the RTC, go over the SoM pins and fix lingering errors that are found
    [audio.sch, battery.sch, boot.sch, buttons_led.sch, csi.sch, dsi.sch, dvk-mx8m-bsb.sch, ethernet.sch]
2018-05-31 added footprint for display FPC connector
    [dsi.sch]
2018-05-31 Include address in schematic notes for all I2C1 slaves, make HDMI connector shielding resistor to GND 0Ohms
    [audio.sch, battery.sch, csi.sch, dsi.sch, hdmi.sch, mipi.sch, rtc.sch, sensors.sch]
2018-05-31 Add notes regarding I2C's 3V3_OUT supply and the fact that it is sourced from NVCC_3P3 (3A BUCK6), add additional notes regarding the RTC and Camera's I2C slave address, reannotate the whole schemati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
    [audio.sch, battery.sch, boot.sch, buttons_led.sch, csi.sch, dsi.sch, dvk-mx8m-bsb.sch, ethernet.sch]
2018-06-01 Add 18650 battery holder footprint and 3D model, add notes regarding what values for charge current and over voltage should be set in the charge controller's respective registers
    [battery.sch]
2018-06-01 Assign most of the capacitors their respective footprints (most are 0603s), add camera/CSI connector component info, source cheaper distributors for 3.5mm headset jack and RJ45
    [audio.sch, battery.sch, boot.sch, buttons_led.sch, csi.sch, dsi.sch, dvk-mx8m-bsb.sch, ethernet.sch]
2018-06-01 Make corrections to schematic based on Emcraft's baseboard revision changes
    [audio.sch, battery.sch, boot.sch, buttons_led.sch, csi.sch, dsi.sch, dvk-mx8m-bsb.sch, ethernet.sch]
2018-06-02 Add decoupling capacitors near the WLAN+BT M.2 Key E socket, assign the tantalum capacitors their various footprints, find suitable 220uF tantalum bulk capacitors for the M.2 modules which are rated 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
    Need to figure out if the load switch IC (AP22800) that derives 3V3_P is fine with having the large output capacitance (no unwanted reverse current).
    [audio.sch, battery.sch, boot.sch, buttons_led.sch, csi.sch, dsi.sch, dvk-mx8m-bsb.sch, ethernet.sch]
2018-06-02 Assign ferrite bead chip part numbers and footprints, add ferrite bead 3D models, Assign VBAT_REG TVS/zener protection diode and its associated footprint & 3D model
    [audio.sch, battery.sch, ethernet.sch, rtc.sch]
2018-06-04 Replace the AP22800 load switch with the P-channel AP22814 load switch IC due to its reverse current & over current protection capability, add level shifter circuit to the WWAN's DPR signal
    Reverse current is no longer an issue with the load switches. One more obvious "TODO" for the schematic left which is to simply place several 100nF bypass caps on the 5V_P, 3V3_P, and 1V8_P rails (investigate how EmCraft is placing these in their layout).
    [audio.sch, battery.sch, boot.sch, buttons_led.sch, csi.sch, dsi.sch, dvk-mx8m-bsb.sch, ethernet.sch]
2018-06-05 Add preliminary Bill-of-Materials, fill in more missing component information such as inductor selection for the 3V3(_P) rail
    Most critical components should now be getting ordered.
    [audio.sch, battery.sch, boot.sch, buttons_led.sch, dvk-mx8m-bsb.csv, haptic.sch, hdmi.sch, power.sch]
2018-06-05 added footprint for camera connector added distrib link (mouser) for SOM connector
    [csi.sch, dvk-mx8m-bsb.sch]
2018-06-06 Add decoupling/stitching capacitors to the 5V_P, 3V3_P, and 1V8_P rails which will be spread through the respective power planes (not necessarily having to be near chips)
    [audio.sch, battery.sch, boot.sch, buttons_led.sch, csi.sch, dsi.sch, dvk-mx8m-bsb.csv, dvk-mx8m-bsb.sch]
2018-06-06 Assign footprints and component properties to all diodes (including LEDs)
    Using Lite-On's LTST-C190GKT (0603, 2.1V @ 20mA) instead of Broadcom's HSMG-C170 (0805, 2.2V @ 20mA) in the ethernet circuit.
    [audio.sch, battery.sch, boot.sch, buttons_led.sch, csi.sch, dvk-mx8m-bsb.csv, ethernet.sch, haptic.sch]
2018-06-07 Add polyfuse/PTC resettable fuse footprints and 3D models
    [battery.sch, ethernet.sch, hdmi.sch, power.sch, usb-c.sch]
2018-06-07 Add 103HT thermistor footprint and 3D model which is used to monitor the 18650 battery temperature (will be located right under the batter within the holder)
    Used the SOD-123 model, added a thin layer on top of it to cover the polarity marking in FreeCAD, scaled the model in KiCad by 0.4.
    [battery.sch]
2018-06-07 Add titles to the sheets which are missing titles
    [audio.sch, battery.sch, boot.sch, buttons_led.sch, csi.sch, dsi.sch, dvk-mx8m-bsb.sch, ethernet.sch]
2018-06-07 Connect VCC of the USB1_VBUS comparitor (TLV3201AIDBVR) to 5V_SOM instead of 5V_P so that VBUS presence can be detected quickly enough for the USB Serial Downloader bootmode, connect the TVS diodes o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
    [audio.sch, battery.sch, boot.sch, buttons_led.sch, csi.sch, dsi.sch, dvk-mx8m-bsb.csv, dvk-mx8m-bsb.sch]
2018-06-08 Add inductor footprints and 3D models
    [battery.sch, dvk-mx8m-bsb.csv, ethernet.sch, power.sch]
2018-06-09 Add FET (Q* reference designators) footprints
    Some footprints are slightly edited versions of their KiCad official library equivalents, using the existing 3D models. DMG2301L's SOT-23 footprint is identical to the official one in the KiCad library.
    [battery.sch, buttons_led.sch, dsi.sch, haptic.sch, hdmi.sch, mipi.sch, usb_hub_sdio.sch, wifi_bt_m2.sch]
2018-06-09 Add quartz crystal footprints, reassign BHC-18650-1P footprint & associated component properties, add BHC-18650-1P 3D model
    [audio.sch, battery.sch, buttons_led.sch, csi.sch, dsi.sch, ethernet.sch, flash.sch, gnss.sch]
2018-06-09 Add haptic motor and debug UART headers/connectors, include notes in schematic r egarding the DPDT switches' & logic gates' pins being interchangeable
    Used right-angled JST 2.5mm connector scaled in half as the motor connector footprint & 3D model, included 1cm distance from haptic motor placement from the edge of the connector (shown on silkscreen).
    [audio.sch, boot.sch, csi.sch, dvk-mx8m-bsb.sch, haptic.sch, sensors.sch, uart.sch, wifi_bt_m2.sch]
2018-06-11 added company logo and designers email addresses into drawing area new library with symbol of Emcraft-SOM (for later use)
    [audio.sch, battery.sch, boot.sch, buttons_led.sch, csi.sch, dsi.sch, dvk-mx8m-bsb.sch, ethernet.sch]
2018-06-11 new structure of first page in the schematics more direct connections instead of labels interconnection of schematic blocks (e.g. USB hub) is made visible format of page is now A3 instead of A2 -> be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
    [audio.sch, battery.sch, boot.sch, buttons_led.sch, csi.sch, dsi.sch, dvk-mx8m-bsb.sch, ethernet.sch]
2018-06-11 Assign jumper header footprints and component properties, selected based on required current rating and minimized area occupied, assigned 1.5mm diameter test points
    [audio.sch, battery.sch, boot.sch, csi.sch, dsi.sch, dvk-mx8m-bsb.sch, ethernet.sch, flash.sch]
2018-06-11 Create footprint for cap touch FPC connector and assign it, add cap touch FPC connector 3D model, assign M.2 Key E socket footprint, assign JTAG header footprint (will be unpopulated)
    M.2 footprints will need mounting holes added to them for the modules to be brought close to the baseboard, this may pose a problem with the display mounted on the back and might need to be done a different way (needs evaluation). Cap touch and DSI connectors need to be carefully placed in the layout to make sure they are positioned correctly with respect to the display's FPCs and the outline of the display itself (need dimensions ASAP). JTAG header can be placed on the back of the board with the header unpopul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
    [dsi.sch, jtag.sch, wifi_bt_m2.sch]
2018-06-12 Add GNSS antenna footprint including correct 50Ohm feed line dimensions and keepout area, add u-blox MAX-8 3D model, rename all instances of MAX-M8* to MAX-8* due to part selection, antenna feed line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
    Need to add placeholder footprints for the other four antennae which will be represented as simple rectangular areas where the antennae will occupy. After that, all that is left is to assign the various remaining IC footprints and finally import all footprints into PCBNew & begin layout!
    [audio.sch, battery.sch, boot.sch, buttons_led.sch, csi.sch, dsi.sch, dvk-mx8m-bsb.sch, ethernet.sch]
2018-06-13 Reorganize the top-level sheet to make more room and allow most wires to be straight connections to their respective locations
    Pin assignments still need to be double checked against the current one in the master branch.
    [dvk-mx8m-bsb.sch]
2018-06-13 Make all sheets except the top-level one identical to master, also checkout master's dvk-mx8m-bsb-cache.lib file
    [audio.sch, battery.sch, boot.sch, buttons_led.sch, csi.sch, dsi.sch, ethernet.sch, flash.sch]
2018-06-13 Small visual enhancements on top level page - e. g. at least one grid space around schematic blocks. Double-labelled I2C busses to indicate clearly that they are point-to-multipoint connections and n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
    [audio.sch, battery.sch, boot.sch, buttons_led.sch, csi.sch, dsi.sch, dvk-mx8m-bsb.sch, ethernet.sch]
2018-06-13 Move more symbols, sheets, and pins around on the front sheet to make it even clearer, bring back the old hierarchical structure (again), bring back each sheet's title, add large text "titles" to eac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
    Still need to double check everything on the first page.
    [audio.sch, battery.sch, boot.sch, buttons_led.sch, csi.sch, dsi.sch, dvk-mx8m-bsb.sch, ethernet.sch]
2018-06-13 Make all differential pair signal names end in P/N so that diff routing works when in layout
    [dvk-mx8m-bsb.sch, hdmi.sch, mipi.sch, smartcard.sch, usb-c.sch, usb_hub_sdio.sch, wifi_bt_m2.sch, wwan_m2.sch]
2018-06-13 Rename MAX-8 back to MAX-M8 (all references now MAX-M8)
    [dvk-mx8m-bsb.sch, gnss.sch]
2018-06-13 Remove emcr_mx8m.* files as they're no longer used, rename Purism_landscape.kicad_wks file to purism_landscape.kicad_wks (prefer all lower case letter for ease of use)
    [usb-c.sch]
2018-06-13 Add USB-C TCPC and SuperSpeed switch IC footprints
    [usb-c.sch]
2018-06-14 Move haptic motor connector footprint position such that 0,0 is between the through hole, this should make it so that its placement coordinates is closer to its center of mass
2018-06-14 Reorder USB-C's diff pairs based on layout simplicity as done on EmCraft's Rev 2 baseboard (requires Lane Polarity Inversion), add 2 and 3-channel differential filter & TVS IC footprints (used with U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
    Used a scaled version BGA-256_16x16_17.0x17.0mm_Pitch1.0mm 3D model for the filter&TVS diff pair chips, the perimeter balls are not very noticable at this shrunken scale and can be replaced later on (placeholder).
    [hdmi.sch, usb-c.sch]
2018-06-14 Create AP22814 footprint and assign it to the respective symbols, use DFN-6-1EP_2x2mm_Pitch0.65mm 3D module for AP22814
    [dvk-mx8m-bsb.sch, power.sch]
2018-06-15 Assign TLV3201AIDBVR footprint based on the SOT-23-5 official footprint using the given solder mask clearance and pad clearance parameters, assign the QFN48 3D model to the ETH PHY footprint, make so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
    [audio.sch, battery.sch, boot.sch, buttons_led.sch, csi.sch, dsi.sch, dvk-mx8m-bsb.sch, ethernet.sch]
2018-06-15 Add AC coupling caps to the HDMI_AUXP/N diff pair which were mistakenly left out, fix a couple typos/errors that were made when transitioning to the new top-leve sheet, make the M.2s' I2C RX TX hiera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
    Hopefully all lingering errors have been caught, this will likely be the schematic commit that gets reviewed (fingers crossed).
    [audio.sch, battery.sch, boot.sch, buttons_led.sch, csi.sch, dsi.sch, dvk-mx8m-bsb.sch, ethernet.sch]
2018-06-15 Re-assigned footprints to the SOM after changes in the library symbol
    [dvk-mx8m-bsb.sch]
2018-06-15 Update Bill-of-Materials format and include missing SEC1110 datasheet link, fixed lingering component properties typos
    [audio.sch, battery.sch, dvk-mx8m-bsb.csv, dvk-mx8m-bsb_bom.csv, power.sch, smartcard.sch, usb_hub_sdio.sch, wwan_m2.sch]
2018-06-15 Move the ground connection on the USB-C receptacle from the shield pin to the GND pins (shield is still connected to GND via the 0 ohm resistor), make the cap between the receptacle's GND and shield 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
    This commit is thanks to the feedback from our design reviewer
    [usb-c.sch]
2018-06-15 Remove unneeded PWR_FLAG symbol due to the last commit's change
    [usb-c.sch]
2018-06-15 Make TVS diodes on USB-C's SBU1 & SBU2 NC since they're unused
    [usb-c.sch]
2018-06-15 Add the BQ25896 charge controller's missing pins which may make the schematic a bit ambiguous, reduce the value of the VBAT_REG LED's current limiting resistor to 1k in order to make it a bit brighter
    This commit is thanks to our design reviewer's feedback.
    [battery.sch]
2018-06-15 Move the WLAN+BT M.2 sheet back to page 18 rather than the last page (24)
    [audio.sch, battery.sch, boot.sch, buttons_led.sch, csi.sch, dsi.sch, dvk-mx8m-bsb.sch, ethernet.sch]
2018-06-15 Derive the GNSS module's power from 3V3_P instead of 3V3
    [gnss.sch]
2018-06-16 Add BQ25896 footprint and assign its 3D model to the QFN24 official model
    Re-export the BoM after bring the WLAN+BT M.2 sheet to page 18 and redoing the reference designator numbers.
    [battery.sch, dvk-mx8m-bsb.sch, dvk-mx8m-bsb_bom.csv, gnss.sch, hdmi.sch]
2018-06-16 Move one of the GNSS antenna's parameter silkscreen outline lines right up against the edge cutout
2018-06-17 Create and assign RT8070 3.3V buck converter's footprint, import and assign its 3D model from the official KiCad repo
    [power.sch]
2018-06-17 Replace 2SK3018 NFET with FDV301N
    [audio.sch, battery.sch, boot.sch, buttons_led.sch, csi.sch, dsi.sch, dvk-mx8m-bsb.sch, ethernet.sch]
2018-06-17 Add MIC2876 5V boost converter's footprint, assign it, assign it the DFN-8 3D model
    [audio.sch, battery.sch, boot.sch, buttons_led.sch, csi.sch, dsi.sch, dvk-mx8m-bsb.sch, ethernet.sch]
2018-06-18 Create and assign the MIC5365-2.8YD5 footprint, using the official SOT-23-5 3D model
    The MIC5365-2.8YD5's recommended land pattern in the datasheet has inconsistent dimensions, so reasonable values are used based on the given TSOT-23 package's dimensions and KiCad's official SOT-23-5 footprint.
    [power.sch]
2018-06-18 Make use MIC5365's SC-70-5 package instead of the SOT-23-5 package since it is a lower cost and is more available, assign it the official SC-70-5 3D model
    Used Microchip's "Package Specification" document which on page 41 shows the recommended land pattern for their SC-70-5 packages (nominal pad dimensions are given but spacing is shown as min/max, used these values +/- 0.05mm for headroom).
    [power.sch]
2018-06-18 Assign the FT440 footprint, assign it KiCad's offical SOT-23-5 3D model
    [power.sch]
2018-06-18 Create PAM2841GR footprint and assign it, also assign its 3D model to KiCad's offical DFN-4 model, remove back solder mask to thermal relief vias on the footprints which have them, add thermal relief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
    [power.sch]
2018-06-18 Add EmCraft's i.MX 8M System-on-Module 3D model and assign it to the respective footprints
    The offset from the main-board to the SoM was measured to be very close to 4.0mm by adjusting the offset and double checking the spacing, it should be fairly accurate when determining the amount of space available (some double checking required).
2018-06-18 corrected footprint for camera connector
2018-06-18 fixed numbering scheme of display connector
2018-06-18 refined camera connector footprint added drawing sheet for pcb with board dimensions
    [dvk-mx8m-bsb.kicad_pcb]
2018-06-18 assigned footprint for U1803
    [wifi_bt_m2.sch]
2018-06-18 assigned footprints for U901, U1501, U1301
    [csi.sch, usb_hub_sdio.sch, wwan_m2.sch]
2018-06-18 assigned footprint for U701
    [uart.sch]
2018-06-18 assigned footprint for U2001
    [sensors.sch]
2018-06-18 Use manufacturer's recommended land pattern for 74LVC1G32GW, NUP5120X6, and 74AUP2G08 (U1301, U1501, U1803), use more accurate VSSOP-8_2.4x2.1mm_Pitch0.5mm 3D model for 74LVC2G241 (U701), include SOT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
    Used manufacturer's given stencil/solder paste and solder mask dimensions whenever given. Some of KiCad's official footprints do not necessary align with the manufacturer's recommended footprints.
    [csi.sch, wifi_bt_m2.sch, wwan_m2.sch]
2018-06-19 Use the MX25L1606EZNI manufacturer's recommended land pattern
    A combination of Macronix's "Recommended PCB Pad Layouts for 8-USON & 8-WSON Packages" (page 4) and "Macronix 209mil 8-SOP and 6x5mm 8-WSON Dual Layout" app notes were used in conjunction with KiCad's official DFN-S-8-1EP_6x5mm_Pitch1.27mm footprint to give a well-rounded pattern.
    [flash.sch, sensors.sch]
2018-06-19 Use PAM8301 manufacturer's TSOT26 recommanded pad layout modified from KiCad's official SOT-23-6 footprint
    [audio.sch]
2018-06-19 Add BLM18PG121SN1D chip ferrite beads to the GNSS, proximity+ambient light sensor, and IMU +3.3V power pins
    [audio.sch, battery.sch, boot.sch, buttons_led.sch, csi.sch, dsi.sch, dvk-mx8m-bsb.sch, ethernet.sch]
2018-06-19 Use the MIC5365-2.8YD5 SOT-23-5 package for the 2.8V rail (not the SC-70-5 2.85V LDO)
    [power.sch]
2018-06-19 Align the SoM's connectors based on EmCraft's DXF and layout dimensions
2018-06-19 Create the NTB0104GU12 footprint based on the manufacturer's given recommended reflow soldering footprint and assign it to the respective symbols
    [wifi_bt_m2.sch, wwan_m2.sch]
2018-06-19 Use manufacturer's layout pad information for the VCNL4040 (U2001) footprint
    Need to know which specific part number was ordered, potentially making the current one incorrect (was it the VCNL4040M3OE-H5?).
2018-06-19 Use LSM9DS1 manufacturer's recommended land and solder mask design pattern, include silkscreen notes on the axis directions, import LGA24 3D model and assign it
    [sensors.sch]
2018-06-19 Add RV-4162-C7 footprint and its 3D model
    [rtc.sch]
2018-06-19 Create SGTL5000XNLA3R2 footprint and assign it KiCad's official UQFN-20-1EP_3x3mm_Pitch0.4mm 3D model
    [audio.sch]
2018-06-19 Create FSA6157L6X footprint, import and assign its MO-255 3D model
    [audio.sch]
2018-06-19 Create and assign SEC1110's footprint, assign it KiCad's offical QFN-16-1EP_5x5mm_Pitch0.8mm 3D model
    [smartcard.sch]
2018-06-19 Create SN74LVC1G332DCKR footprint based on the manufacturer's given example and assign it to the respective schematic symbol, assign it the official KiCad SC-70-6 3D model
    [sensors.sch]
2018-06-19 Center the GNSS chip antenna on it's footprint design to make sure it's component coordinates are correct, add WLAN+BT placeholder footprint which is identical to the GNSS one (still needs to be sele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
    The WWAN/BB chip antenna is likely going to be significantly different than the GNSS one (in terms of design and area) so it is not currently being used as a placeholder for it.
    [wifi_bt_m2.sch]
2018-06-19 Changes in library symbol and footprint of J1503 (micro-SIM-connector). Differences prevented real connections of footprint pads.
    [wwan_m2.sch]
2018-06-19 added missing ground/shielding connections for connector J201 (USB-C)
    [usb-c.sch]
2018-06-19 fixed connections of smartcard connector J2001
    [smartcard.sch]
2018-06-19 renamed shielding pins in footprint of J901 (HDMI) to ensure that they are connected.
2018-06-19 fixed pin numbering typo in footprint of U301 (BQ25896).
2018-06-19 copied footprint of U.FL coaxical connector into project library (for future use)
2018-06-19 Assign u.FL to the coax connectors in the WLAN+BT circuit
    [gnss.sch, haptic.sch, smartcard.sch, usb-c.sch, wifi_bt_m2.sch, wwan_m2.sch]
2018-06-19 Update BoM after the last several commits of not adding new info from the schematic
    [dvk-mx8m-bsb_bom.csv]
2018-06-19 Remove temporary footprint library that is no longer used
2018-06-19 Add silkscreen orientation dot to SGTL5000XNLA3R2's footprint
2018-06-19 Use PTN36043BXY part number instead of PTN36043BXZ due to availability
    The only difference between these two part numbers is the reel the chip comes in, both are identical ICs.
    [dvk-mx8m-bsb_bom.csv, usb-c.sch]
2018-06-19 Add thermal relief vias to the PTN5110 footprint's exposed pad and adjust the solder paste dimensions
2018-06-19 Add orientation silkscreen info to the VCNL4040 footprint, import its 3D model
    The 3D model is actually associated with the narrower package and can be considered a temporary placeholder.
2018-06-19 Add orientation silkscreen dot to the MAX-M8 footprint
2018-06-19 Make LEDK on the dsi.sch sheet a hierarchical OUTPUT pin
    [dsi.sch]
2018-06-19 Include silkscreen reference designator in the MHF4 footprint
2018-06-20 Add FDV301N footprint based on the manufacturer's given recommended land pattern, use lower ESR 220uF tantalum capacitors in place of previously selected ones, re-export the BoM
    Double checked FET footprints to make sure those assigned to the official SOT-23 footprint are correct.
    [audio.sch, battery.sch, boot.sch, buttons_led.sch, csi.sch, dsi.sch, dvk-mx8m-bsb.sch, dvk-mx8m-bsb_bom.csv]
2018-06-20 Update MX25L1606EZNI's land pattern reference page to being 56 instead of 4
    MX25L1606EZNI's land description explicitly states "Avoid placing vias or traces underneath the metal pad." This means that the exposed pad will need to be connected to ground through the top layer (and vias in other locations on the board, not at the exposed pad).
2018-06-20 Add silkscreen dot to all footprints which are missing one that need them to determine IC orientation
2018-06-20 Add 0.3mm diameter thermal relief via to the AP22814 footprint's exposed pad
2018-06-20 Add more silkscreen orientation markers to footprints which are missing them
2018-06-20 For better BoM generation, added placeholders for SOM, disṕlay, camera, WWAN card and wifi/BT card. Datasheet links and supplier information can be stored in these new library symbols.
    [audio.sch, battery.sch, boot.sch, buttons_led.sch, csi.sch, dsi.sch, dvk-mx8m-bsb.sch, ethernet.sch]
2018-06-21 Replace WWAN M.2 circuit with one intended for mPCIe modules, include 74LVC1G08 single 2-input AND gate, create the AND gate's footprint and use the official SOT-23-5 3D model
    The mini-SIM slot will need to be replaced with one that has an active-LOW detection pin. Will want to see if we can find cheap electrolytic to replace a few of the tantalum caps with (not all since we still need some low ESR, high capacitance, low profile, caps).
    [audio.sch, battery.sch, boot.sch, csi.sch, dsi.sch, dvk-mx8m-bsb.sch, sd.sch, sensors.sch]
2018-06-21 Added additional XOR gate to the WWAN page. This makes it possible that the polarity of the SIM_DETECT signal is configurable by one single O-Ohm-resistor. This adds more flexibility concerning modem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
    [wwan_mpcie.sch]
2018-06-21 Update WWAN mPCIe sheet by organizing a few things and fixing the component properties order
    [audio.sch, ethernet.sch, flash.sch, gnss.sch, haptic.sch, hdmi.sch, sensors.sch, smartcard.sch]
2018-06-21 Import u.FL connector's 3D model
2018-06-21 Replace logic gate packages with cheaper options, change associated footprints to ones which match the cheaper alternatives
    [csi.sch, sensors.sch, wifi_bt_m2.sch, wwan_mpcie.sch]
2018-06-22 Add WLAN+BT antenna component information
    [hdmi.sch, wifi_bt_m2.sch, wwan_mpcie.sch]
2018-06-22 Assign "mpcie-outline" footprint to the ModemCard schematic symbol
    [wwan_mpcie.sch]
2018-06-22 Make a few minor aesthetic adjustments to the schematic
    [boot.sch, wifi_bt_m2.sch, wwan_mpcie.sch]
2018-06-22 Add mounting holes to the schematic and assign the associated M2 hole footprint, add fiducial marks to schematic and assign the associated 1mm diameter copper with 2mm diameter solder mask opening fo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
    [audio.sch, battery.sch, boot.sch, buttons_led.sch, csi.sch, dsi.sch, dvk-mx8m-bsb.sch, ethernet.sch]
2018-06-22 Small change in footprint assignment of the SOM: Old situation: First footprint of the SOM contains outline, mounting holes, footprint of P1 and markers for positions of P2, P3 and P4. Second, third 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
    New situation:
    Outline, mounting holes and position markers are now located in the footprint which is assigned to the SOM placeholder
    4 identical footprints assigned to the SOM's connectors P1..P4 contain only the connector footprint.
    This shouldn't cause problems with the BoM.
    [dvk-mx8m-bsb.sch]
2018-06-22 added library symbol for short internal coaxial cables (from u.FL connector of M.2/MiniPCIE Card to ceramic antenna). This component is not appearing at the pcb. The library symbols serves only as a 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
    [wifi_bt_m2.sch, wwan_mpcie.sch]
2018-06-22 Changed shape of pcb area to rounded corners.
    [dvk-mx8m-bsb.kicad_pcb]
2018-06-22 Adjust the SoM outline footprint by rotating it 90 degrees and making the reference and value text the standard size (reference is now invisible), did the same for the SoM connector footprint (refere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
2018-06-23 Add pull-up resistor to nCS pin of the NOR flash chip, make electrolytic caps tantalums again due to a the price difference not being significant
    [audio.sch, battery.sch, boot.sch, buttons_led.sch, csi.sch, dsi.sch, dvk-mx8m-bsb.sch, ethernet.sch]
2018-06-24 Make recommended changes after reviewer examined pages 13, 15-20
    [audio.sch, csi.sch, ethernet.sch, hdmi.sch, wifi_bt_m2.sch, wwan_mpcie.sch]
2018-06-24 Add proper WWAN reset circuit using a MMBT2222A NPN BJT along with a 100nF cap and a TVS diode, make needed adjustements to the WWAN's SIM card circuit (UIM-CLK and UIM-RESET caps are NC & added 4.7k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
    If necessary, the NC cap pads on UIM-CLK and UIM-RESET can be tested with various values during the first prototype debugging phase.
    [audio.sch, battery.sch, boot.sch, buttons_led.sch, csi.sch, dsi.sch, dvk-mx8m-bsb.sch, ethernet.sch]
2018-06-25 Assign placeholder footprints to WWAN antennae (identical to GNSS ones for now), add haptic motor schematic symbol and split up the connector and motor footprints, now ready to generate netlist and i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
    [haptic.sch, wifi_bt_m2.sch, wwan_mpcie.sch]
2018-06-25 Generate the netlist, next step is to import the netlist and corresponding footprints in Pcbnew
2018-06-25 Make mpcie-outline footprint's back silkscreen pads graphic line rectangles to prevent errors in layout
2018-06-25 Import netlist into Pcbnew layout software, spread out all footprints to prepare for placing components in their respective locations and begin routing
    [dvk-mx8m-bsb.kicad_pcb]
2018-06-25 Make the resistor which is connected to the NPN's base and emitter 47k instead of 4.7k
    [wwan_mpcie.sch]
2018-06-25 Update text-parasble PDF after the last few commits' changes
    [haptic.sch]
2018-06-25 Make the fill background on the haptic motor schematic symbol like the rest of the external components throughout the schematic
2018-06-25 Change GRM219R61C226ME15L X5R 0805 22uF capacitor to being a CL10A226MP8NUNE X5R 0603 22uF capacitor
    [battery.sch, dvk-mx8m-bsb.kicad_pcb, dvk-mx8m-bsb.sch, haptic.sch, hdmi.sch, power.sch, sd.sch]
2018-06-26 Replace camera's schottky+resistor level-shifter circuit with the more functional TXB0101 dedicated IC
    [audio.sch, battery.sch, buttons_led.sch, csi.sch, dvk-mx8m-bsb.kicad_pcb, ethernet.sch, flash.sch, gnss.sch]
2018-06-26 Re-spread out all footprints in the layout after adding the new CLKO2 level-shifter circuit
    [dvk-mx8m-bsb.kicad_pcb]
2018-06-26 Set up the initial six layer stackup, two additional layers may need to be added later, add track and via sizes used from EmCraft's baseboard design into the global design rules, change JH057N00900 o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
    [dvk-mx8m-bsb.kicad_pcb]
2018-06-26 Remove TODO note about changing the CLKO2 level-shifter circuit
    [csi.sch]
2018-06-26 Make AR8031's reference designator on the silkscreen layer above the land pattern and its value on the F.Fab layer below the land pattern, make the fiducials' B.Cu pad have the back mask exposed, app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
    [dvk-mx8m-bsb.kicad_pcb]
2018-06-26 Make the pull-up resistor on ENET_MDIO 1.62k +-1%
    [dvk-mx8m-bsb.sch, ethernet.sch]
2018-06-26 Reflect the last commit's change in the layout (R1718 being 1.62k)
    [dvk-mx8m-bsb.kicad_pcb]
2018-06-26 Center the SoM's connectors about the X-axis with respect to the board's outline and mounting holes
2018-06-26 Apply the last commit's changes to the SoM footprint in the layout
    [dvk-mx8m-bsb.kicad_pcb]
2018-06-26 Move the SoM onto the center of the board and place its connectors in the corresponding locations
    [dvk-mx8m-bsb.kicad_pcb]
2018-06-26 Add pin 1 indicator and silkscreen boarder to the SoM connector footprint, apply the respective change to the layout
    [dvk-mx8m-bsb.kicad_pcb]
2018-06-27 Replace SZMM5Z3V3T1G with MMSZ4688 zener diode which has a higher reverse working voltage to ensure that HP_DET is at a strong HIGH level when headphones/headset are inserted into the jack, replace i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
    [audio.sch, dvk-mx8m-bsb.kicad_pcb, dvk-mx8m-bsb.sch]
2018-06-27 Swap WWAN_DP and WWAN_DN
    [dvk-mx8m-bsb.kicad_pcb, wwan_mpcie.sch]
2018-06-27 Update the CSV BoM after the last several commits
    [dvk-mx8m-bsb_bom.csv, wwan_mpcie.sch]
2018-06-28 Make some minor fixes to various components' properties and update the BoM with the respective changes, sort the BoM based on reference designator and value
    [audio.sch, csi.sch, dvk-mx8m-bsb_bom.csv]
2018-06-28 Add 18pF capacitor to WLAN+BT M.2 circuit as is done on the WWAN bypass cap array
    [dvk-mx8m-bsb.kicad_pcb, dvk-mx8m-bsb_bom.csv, wifi_bt_m2.sch, wwan_mpcie.sch]
2018-06-28 Replace the VCNL4040 proximity+ambient light sensor's 470nF bypass cap on VDD with a 1uF one to reduce the number of BoM line items, also replace the USB Hub+SDIO bridge chip's SDCD cap between the P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
    [dvk-mx8m-bsb.kicad_pcb, dvk-mx8m-bsb_bom.csv, sensors.sch, usb_hub_sdio.sch]
2018-06-28 Give the DPDT switches descriptive values
    [audio.sch, boot.sch, csi.sch, dvk-mx8m-bsb.kicad_pcb, dvk-mx8m-bsb_bom.csv]
2018-06-28 Add component info for 10k resistors that are missing them (R105 & R220)
    [dvk-mx8m-bsb.kicad_pcb, dvk-mx8m-bsb.sch, dvk-mx8m-bsb_bom.csv, usb-c.sch]
2018-06-28 Replace resistors which have specific values that can be converted to more common values in order to reduce the total number of unique BoM line items
    [battery.sch, dvk-mx8m-bsb.kicad_pcb, dvk-mx8m-bsb_bom.csv, usb_hub_sdio.sch]
2018-06-28 Replace the tantalum capacitor that is AC-coupling the input of the class D amplifier with a ceramic 0603 cap
    [audio.sch, usb_hub_sdio.sch]
2018-06-28 Apply the last commit's changes to the CSV BoM
    [dvk-mx8m-bsb_bom.csv]
2018-06-28 Add well-formated .ODS Bill-of-Materials
    [dvk-mx8m-bsb_bom.ods]
2018-06-28 Update the component properties for the SMD right-angled push buttoms
    [buttons_led.sch, dvk-mx8m-bsb.kicad_pcb, dvk-mx8m-bsb_bom.ods]
2018-06-28 Place similiar antennae on the same row
    [dvk-mx8m-bsb_bom.ods]
2018-06-29 Move USB-C, Mini-HDMI, RJ45, and 3.5mm jack receptacles to the bottom of the board, also place the Micro-SD card slot to the left of all of the receptacles centered at the bottom, place the Smart-Car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
    The order of the various receptacles and sockets can be changed bit the pitch between them should stay about the same since it is currently as tightly packed asreasonably possible (1.5~2.5mm clearance between connectors).
    [battery.sch, dvk-mx8m-bsb.kicad_pcb]
2018-06-29 Make the ETH PHY's crystal's load capacitors 27pF instead of 22pF, Cstray should now be 3.5pF instead of 7pF
    [dvk-mx8m-bsb.kicad_pcb, ethernet.sch]
2018-06-29 Update the BoM after the last commit's changes
    [dvk-mx8m-bsb_bom.csv, dvk-mx8m-bsb_bom.ods]
2018-06-29 Rename all diff pairs such that they end in _P/_N rather than just P/N (underscore needed for diff pair routing)
    [buttons_led.sch, dsi.sch, dvk-mx8m-bsb.kicad_pcb, dvk-mx8m-bsb.sch, hdmi.sch, mipi.sch, power.sch, smartcard.sch]
2018-06-30 Route the USB-C differential signals going from the EMI&TVS ICs to the receptacle, add meander/serpentine bends to tracks which need differential pair skew/phase tuning
    [dvk-mx8m-bsb.kicad_pcb]
2018-06-30 Move USB_CN_D_P/_N vias closer together in order to maintain a more constant differential impedance
    [dvk-mx8m-bsb.kicad_pcb]
2018-06-30 Fix all DRC violations in the layout by making corrections to various footprints
    [audio.sch, dvk-mx8m-bsb.kicad_pcb, ethernet.sch, flash.sch, gnss.sch, haptic.sch, hdmi.sch, sensors.sch]
2018-07-02 Re-labelled signals around USB-C with naming scheme for differential routing (_P/_N names). Routed some data lines behind USB connector.
    [dvk-mx8m-bsb.kicad_pcb, usb-c.sch]
2018-07-02 Some component movments and routings around USB-C circuit.
    [dvk-mx8m-bsb.kicad_pcb]
2018-07-02 Minor placements/routings around USB-C.
    [dvk-mx8m-bsb.kicad_pcb]
2018-07-02 Make some minor aesthetic adjustments to the USB-C schematic sheet, the USB-C receptacle symbol should come from the dvk-mx8m-bsb library
    [usb-c.sch]
2018-07-02 Re-route the differential tracks going from the USB-C switch IC to the EMI&TVS ICs along with some of the passives around the USB-C switch chip (similar placement to EmCraft's), add a 1uF cap to the 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
    [dvk-mx8m-bsb.kicad_pcb, power.sch]
2018-07-03 Increase the clearance between the USB-C diff pairs in order to minimize crosstalk
    [dvk-mx8m-bsb.kicad_pcb]
2018-07-03 Route the PTC polyfuse that's on the VBUS rail using a copper pour on the In4.Cu layer, route the USB-C's shielding to parallel 0Ohm and NC cap to GND, add a power net class, add a 0.508mm annular ri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
    [dvk-mx8m-bsb.kicad_pcb, usb-c.sch]
2018-07-03 Update the BoM after adding the 1uF cap to the 2.8V LDO's EN pin
    [dvk-mx8m-bsb_bom.csv, dvk-mx8m-bsb_bom.ods]
2018-07-03 Small change in the (placeholder) antennae footprints. Make the EDGE CUTS rectangle a real milling in the pcb. (Only a memory aid that this is possible, also done inside the M.2 Cardholder footprint)
    [dvk-mx8m-bsb.kicad_pcb]
2018-07-03 Move CAPTOUCH_~RST from BOOT_CFG_03 to GPIO1_IO05/P3.33 (was CSI_P2_PWDN), add a 10k pull-down to LCD_~RESET, make the corresponding changes to the BoM and netlist/layout
    Having CAPTOUCH_~RST on BOOT_CFG_03 caused a voltage divider on the pin.
    [audio.sch, boot.sch, buttons_led.sch, csi.sch, dsi.sch, dvk-mx8m-bsb.kicad_pcb, dvk-mx8m-bsb.sch, dvk-mx8m-bsb_bom.csv]
2018-07-03 Move the VBUS TVS diode and bypass caps and place copper pour on the respective pad areas, the VBUS rail has a 6mm wide fill zone in order to properly handle ~4.3A with a <10degreeC temperature rise 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
    [dvk-mx8m-bsb.kicad_pcb, usb-c.sch]
2018-07-04 PCB Layout: Movement of circuit blocks that partially dis-entangle airwires. Beginning to route the connection from USB Hub IC to SD card (maybe too long distance for hi-speed SD Card access?)
    [dvk-mx8m-bsb.kicad_pcb]
2018-07-04 Now using GPIO5_IO03 (P4.03) to put the class-D op-amp in shutdown and conserve energy when muted, make C1716 near the ETH PHY's DVDDL pin 47 220nF instead of 10uF (EmCraft suggested that this should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
    Still need to use I2C3 instead of I2C1 according to EmCraft's suggestions.
    [audio.sch, boot.sch, buttons_led.sch, csi.sch, dsi.sch, dvk-mx8m-bsb.kicad_pcb, dvk-mx8m-bsb.sch, dvk-mx8m-bsb_bom.csv]
2018-07-05 Place and route the USB-C CC & SBU TVS diodes
    [dvk-mx8m-bsb.kicad_pcb]
2018-07-05 Change the capacitor C1718 near the ETH PHY's AVDDL2 pin 44 from 220nF to 2.2uF
    Emcraft is also going to change this cap to 2.2uF.
    [dvk-mx8m-bsb.kicad_pcb, dvk-mx8m-bsb.sch, dvk-mx8m-bsb_bom.csv, dvk-mx8m-bsb_bom.ods, ethernet.sch]
2018-07-05 Use I2C3 bus instead of I2C1 bus based on EmCraft's feedback
    [audio.sch, battery.sch, csi.sch, dsi.sch, dvk-mx8m-bsb.kicad_pcb, dvk-mx8m-bsb.sch, mipi.sch, rtc.sch]
2018-07-05 Remove "PWM4" text since it no longer applies
    [dvk-mx8m-bsb.sch]
2018-07-06 Add Eco2.User drawing to the EmCr_SOM_IMX8M_Outline footprint which shows where there are components and traces underneath the SoM in the "hatched" area
    [dvk-mx8m-bsb.kicad_pcb]
2018-07-07 Place and begin routing the charge controller circuit
    [battery.sch, dvk-mx8m-bsb.kicad_pcb, dvk-mx8m-bsb.sch]
2018-07-09 Add top-layer copper pour to various nets on the charge controller, make sure all of the clearances are met and that ample copper available for the high current paths (maximize copper area)
    Used TI's BQ2589x reference designs.
    [dvk-mx8m-bsb.kicad_pcb]
2018-07-09 Move the charge controller, USB-C TCPC, and RTC to I2C1
    Since each of these ICs will be powered at the same time as the SoM regardless of the PWR_EN state, they should share the same I2C bus as the PMIC.
    [audio.sch, battery.sch, boot.sch, buttons_led.sch, csi.sch, dsi.sch, dvk-mx8m-bsb.kicad_pcb, dvk-mx8m-bsb.sch]
2018-07-09 Continue layout around the charge controller circuit
    [dvk-mx8m-bsb.kicad_pcb, dvk-mx8m-bsb.sch, rtc.sch]
2018-07-10 Route VBUS to the charge controller, move the bypass cap next to the charge controller's VBUS pin (1) in order to make room for the via array, ensure that all of the high-current paths have sufficien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
    [dvk-mx8m-bsb.kicad_pcb]
2018-07-11 Route the VBAT_REG output to the In3.Cu layers, begin placing the passive components around the TCPC PHY chip (same placement positions as EmCraft's), add SIM card slot 3D model and move it onto the 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
    [dvk-mx8m-bsb.kicad_pcb]
2018-07-11 Replace the 103HT NTC thermistor with a ERTJ1VG103FA as found in TI's TIDA-01182 eval board which has a charge controller IC from the same family and uses an 18650 battery, change is due to it being 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
    [battery.sch, dvk-mx8m-bsb.kicad_pcb, dvk-mx8m-bsb.sch, dvk-mx8m-bsb_bom.csv, dvk-mx8m-bsb_bom.ods]
2018-07-11 Place and route the battery thermistor circuit, add covered B.Cu pads to the footprints which have thermal exposed pads
    [battery.sch, dvk-mx8m-bsb.kicad_pcb]
2018-07-11 Route CC1 and CC2 to the USB-C receptacle
    [dvk-mx8m-bsb.kicad_pcb]
2018-07-14 Move and route the bypass & bulk caps and protection diode to the VBAT_REG rail
    [dvk-mx8m-bsb.kicad_pcb]
2018-07-14 Update PDFs after changing the thermistor to the smaller 0603 one
2018-07-16 Add a 100k pull-down resistor to the the class-D audio amplifier's SD# / MUTE pin
    [audio.sch, dvk-mx8m-bsb.kicad_pcb, dvk-mx8m-bsb_bom.csv, dvk-mx8m-bsb_bom.ods, ethernet.sch, flash.sch, gnss.sch, haptic.sch]
2018-07-16 Update project files to KiCad 5.0.0
    [audio-2018-07-16-14-33-54.sch, audio-2018-07-16-17-35-05.sch, audio.sch, battery-2018-07-16-14-33-54.sch, battery-2018-07-16-17-35-05.sch, battery.sch, boot-2018-07-16-14-33-54.sch, boot-2018-07-16-17-35-05.sch]
2018-07-17 Update the schematic symbols and footprints after upgrading to KiCad 5.0.0, fix all ERC and DRC violations after the new update/upgrade
    [audio.sch, battery.sch, boot.sch, buttons_led.sch, csi.sch, dsi.sch, dvk-mx8m-bsb.kicad_pcb, dvk-mx8m-bsb.sch]
2018-07-17 Swap pin 1 and 2 pad number for the microphone footprint
    [dvk-mx8m-bsb.kicad_pcb]
2018-07-18 Add the display FPC connector's 3D model and move it to approximately the position it will be in
    [dvk-mx8m-bsb.kicad_pcb]
2018-07-18 Use the new 1.5mm diameter test point footprint from KiCad 5's library
    [dvk-mx8m-bsb.kicad_pcb, dvk-mx8m-bsb.sch, ethernet.sch]
2018-07-18 Move the vias near the new 0603 footprints to more proper locations, route the bypass/bulk caps on the VBUS_REG rail
    [dvk-mx8m-bsb.kicad_pcb]
2018-07-18 Slightly reduced restring diameter of Molex Ethernet MagJack - makes it possible to connect traces on the top layer.
2018-07-18 Make use of changed footprint J1701 / MagJack in layout file.
    [dvk-mx8m-bsb.kicad_pcb]
2018-07-18 Connection made between MagJack and Ethernet-PHY.
    [dvk-mx8m-bsb.kicad_pcb]
2018-07-18 Routing of some componentents near Ethernet-PHY. PHY-Chip is located near MagJack, eventually it must be moved away later.
    [dvk-mx8m-bsb.kicad_pcb]
2018-07-18 Rotated SOM by 180 degrees (mainly for shorter display connection) Moved component groups closer to the center Unrouted net lines are now shorter in general (density is unfortunately higher)
    [dvk-mx8m-bsb.kicad_pcb]
2018-07-18 Rotate the USB-C TCPC PHY 180 degrees after the SoM has been rotated
    [dvk-mx8m-bsb.kicad_pcb]
2018-07-19 Update all of the 3D model paths to the new directory name structure, use the correct camera mating connector part number AXT530124 instead of AXT630124 which is the one found on the camera, add the 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
    [csi.sch, dvk-mx8m-bsb.kicad_pcb, dvk-mx8m-bsb_bom.csv, dvk-mx8m-bsb_bom.ods]
2018-07-19 Replace the CMC-6022-37T microphoen with the CMC-2242PBL-A THT one since the old one cannot be surface mounted/reflowed, add the microphone's 3D model
    The microphone's pin position/order is agrees with the manufacturer's "measurement circuit" from the datasheet such that the right (facing the top of the mic) terminal/pin is its GND (-).
    [audio.sch, dvk-mx8m-bsb.kicad_pcb, dvk-mx8m-bsb_bom.csv, dvk-mx8m-bsb_bom.ods]
2018-07-19 Changes in the rough placement: Swapped positions of M.2 and miniPCIE cards, as this results in less signal crossings under the SOM. Moved some forgotten parts back to their respective groups.
    [dvk-mx8m-bsb.kicad_pcb]
2018-07-19 Routing of signals between ethernet PHY and SOM, mainly on layer In2.Cu.
    [dvk-mx8m-bsb.kicad_pcb]
2018-07-19 Wired some of the bypass capacitors at the ethernet PHY.
    [dvk-mx8m-bsb.kicad_pcb]
2018-07-19 Fixed two newly introduced DRC errors.
    [dvk-mx8m-bsb.kicad_pcb]
2018-07-19 Add new built-in mic's frequency response curve to the schematic and re-simulate the HP_DET pin circuit with the protection diode's SPICE model included
    [audio.sch]
2018-07-19 Move and route the current limiting resistor for the charge controller circuit
    [dvk-mx8m-bsb.kicad_pcb]
2018-07-20 Route the USB diff pairs from the TVS protection + EMI filter IC circuit to the SoM, place and route the USB1_VBUS comparator circuit
    [dvk-mx8m-bsb.kicad_pcb]
2018-07-20 Routed and connected some passive components around the ethernet interfaces.
    Detected and corrected numbering error with MagJack J1701.
    Eventually error with missing VCC of Pin 1 of J1707 (to be checked).
    [dvk-mx8m-bsb.kicad_pcb, ethernet.sch]
2018-07-20 Place and route the rest of the battery sheet circuit, place and route the 10k (non-NC) resistors near the TCPC, route the EN_SRC and EN_SNK lines
    TCPC still needs to be completed
    [dvk-mx8m-bsb.kicad_pcb]
2018-07-23 Moved components of ethernet interface into new position (reduced airwire crossings).
    [dvk-mx8m-bsb.kicad_pcb]
2018-07-23 Reduce all 0603 resistor sizes to 0402
    [audio.sch, battery.sch, boot.sch, buttons_led.sch, csi.sch, dsi.sch, dvk-mx8m-bsb.kicad_pcb, dvk-mx8m-bsb.sch]
2018-07-23 Change all 0603 capacitors _EXCEPT_ the 2.2uF, 4.7uF, 8.2uF, 10uF, and 22uF caps to 0402
    [audio.sch, battery.sch, boot.sch, buttons_led.sch, csi.sch, dsi.sch, dvk-mx8m-bsb.kicad_pcb, dvk-mx8m-bsb.sch]
2018-07-23 Re-route the components which became 0402 around the USB-C superspeeed switch IC
    [battery.sch, dvk-mx8m-bsb.kicad_pcb]
2018-07-24 Re-route the remaining parts of the USB-C circuit which had passives changed to 0402
    [dvk-mx8m-bsb.kicad_pcb]
2018-07-24 Move and route the NC resistors around the USB-C TPCP IC
    [dvk-mx8m-bsb.kicad_pcb]
2018-07-24 Updated speaker footprint with cutout/milling under it and larger pads for hand soldering.
    [dvk-mx8m-bsb.kicad_pcb]
2018-07-24 Deleted or repaired some errors introduced (by me) as kicad beginner (improper use of diff pairs, parts being off grid etc).
    [dvk-mx8m-bsb.kicad_pcb]
2018-07-24 Routing of some ethernet signals.
    [dvk-mx8m-bsb.kicad_pcb]
2018-07-24 Placed and connected some more passives around ethernet circuit.
    [dvk-mx8m-bsb.kicad_pcb]
2018-07-24 Add the speaker's 3D model, expand the speaker footprint's milled hole size and rotate its pads in order to closely conform to the 3D model
2018-07-24 Add 3D models for the M.2 and mPCIe sockets
    [dvk-mx8m-bsb.kicad_pcb]
2018-07-24 Update M.2 and mPCIe footprints
    [dvk-mx8m-bsb.kicad_pcb]
2018-07-24 Route the I2C1 bus for the charge controller and TCPC
    [dvk-mx8m-bsb.kicad_pcb]
2018-07-25 Place and route the RTC circuit, complete the I2C1 routing
    Next thing to add is the 5V_SOM rail and effectively the SoM board will be able to receive power via either a USB supply and/or a battery with nothing else added (basic operation functionality then implemented).
    [dvk-mx8m-bsb.kicad_pcb]
2018-07-25 (Small) change in library symbol of RJ45-mag-jack (inner circuit now machtches the picked mag-jack type). Further routing and placing of ethernet group.
    [dvk-mx8m-bsb.kicad_pcb]
2018-07-25 Fixed some DRC errors.
    [dvk-mx8m-bsb.kicad_pcb]
2018-07-25 Place and route the UART1 Debug header & circuit
    [dvk-mx8m-bsb.kicad_pcb]
2018-07-26 Place and route the GNSS antenna and its feedline, re-calculate the coplanar waveguide to 50Ohms using EmCraft's baseboard parameters (include new calculations), make the M.2 mounting hole connect to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
    [dvk-mx8m-bsb.kicad_pcb, dvk-mx8m-bsb_bom.csv, dvk-mx8m-bsb_bom.ods, gnss.sch]
2018-07-26 Connect the mPCIe mounting holes to ground, use common dimensions for the mPCIe mounting holes, update THT vs SMD definitions for various footprints, re-update all footprints in the layout
    [dvk-mx8m-bsb.kicad_pcb]
2018-07-26 Move and route the bypass caps and ferrite bead filter circuit for the GNSS's VCC & VCC_IO power inputs (coming from 3V3_P)
    [dvk-mx8m-bsb.kicad_pcb]
2018-07-26 Placement and routing of audio circuit. Connections to speaker, mic, HKS and SOM not finalized because they depend on general placing.
    [dvk-mx8m-bsb.kicad_pcb]
2018-07-26 Add WiFi+BT antenna footprint, add pi matching circuit to the WiFi+BT antennas' feedlines, increment the capacitor part numbers on page 18 after adding the new (NC) feedline caps and make the respect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
    [dvk-mx8m-bsb.kicad_pcb, dvk-mx8m-bsb_bom.csv, dvk-mx8m-bsb_bom.ods, wifi_bt_m2.sch, wwan_mpcie.sch]
2018-07-26 Place and route the WiFi+BT antennae circuits, reduce the radius of the PCB corners in order to make more room for the antennae
    The top-right mounting hole is currently placed in an ~odd~ position in order to avoid the (AE1801) antenna's clearance area, a thin 0.475mm wide strip runs from the two ground planes to this mounting hole (between the two antennas' occupied area).
    [dvk-mx8m-bsb.kicad_pcb]
2018-07-27 Place and route the NOR Flash circuit
    [dvk-mx8m-bsb.kicad_pcb]
2018-07-27 Place and route the BOOT_CFG* signals, correct a signal labelling mistake causing SAI1_RXD0 (BOOT_CFG00) to be connected to SAI1_TXD0 (BOOT_CFG08)
    BOOT_MODE* still needs to be placed & routed, need to find a good location for the SMD slide switches.
    [boot.sch, dvk-mx8m-bsb.kicad_pcb, dvk-mx8m-bsb_bom.csv, dvk-mx8m-bsb_bom.ods, flash.sch]
2018-07-27 Begin routing the smart-card circuit
    [dvk-mx8m-bsb.kicad_pcb]
2018-07-27 Give more room between smart-card tracks on the bottom layer and the USB diff pair in order to reduce the potential for crosstalk
    [dvk-mx8m-bsb.kicad_pcb]
2018-07-27 Wired connection SOM<->Audio codec. Placed USB Hub under the SOM. Wired connection SD-card - Hub/SDIO-bridge. (A few existing connection had to be moved or change layer) Some details of SD-card (pass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
    [dvk-mx8m-bsb.kicad_pcb]
2018-07-27 Route the SD and smart-card traces away from the keepout areas on the top layer
    [dvk-mx8m-bsb.kicad_pcb]
2018-07-28 Begin routing the HDMI circuit
    Needed to create the HDMI_HEAC_P/N labels to route Utility&HPD as diff pairs. Made cap C1905 NC, which is in parallel with a 0Ohm resistor between the HDMI sheilding and GND.
    [dvk-mx8m-bsb.kicad_pcb, dvk-mx8m-bsb.sch, dvk-mx8m-bsb_bom.csv, dvk-mx8m-bsb_bom.ods, hdmi.sch]
2018-07-28 Coarsely route HDMI diff pairs from the SoM to the CMF&ESD chips, place the microphone in a position that does not interfere with either the HDMI circuit or the RJ45
    The HDMI diff pairs will need to try to have 30mil clearance between each other at every point possible, in tight spaces this is not possible, even spacing will need to be adjusted in the following commit.
    [dvk-mx8m-bsb.kicad_pcb, hdmi.sch]
2018-07-28 Make the HDMI routing conform more closely to the clearance requirements (30mils between data diff pairs & 50mils from CLK) and add meanders to tune the skew/phase
    [dvk-mx8m-bsb.kicad_pcb]
2018-07-29 Continue optimizing the HDMI diff pairs and use <2*Gap for the amplitude and <3*Width for the spacing on the USB serpentine routing
    These same <2*Gap & <3*Width values still need to be applied to the HDMI diff pairs (along with placing the meander in the correct locations by deleting segments checking the length, and re-adding the segment).
    [dvk-mx8m-bsb.kicad_pcb]
2018-07-29 Adjust the dimensions and move the placement of the serpentine bends to the recommended values & locations for the USB diff pairs and the HDMI CLK line
    This same thing still needs to be applied to the other HDMI diff pairs.
    [dvk-mx8m-bsb.kicad_pcb]
2018-07-29 Correct the spacing between USB1_TX_P&N on the top layer next to the SoM
    [dvk-mx8m-bsb.kicad_pcb]
2018-07-30 Correct and complete the USB and HDMI serpentine bend skew/phase routing such that each diff pair is tuned/matched to 0mm. Place each of the tuning meanders at the correct corresponding locations by 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
    Each of the diff pairs now have a 0mm intra-pair skew (with the exception of three very short USB-C pairs between the CMF&ESD IC and the receptacle) which still have a skew within the <1ps~=150um spec (is actually <100um).
    [dvk-mx8m-bsb.kicad_pcb]
2018-07-30 Routed missing wires (ethernet part, SD-card passives, SD-card supply) Shortened/straightened connection SD-card <-> SOM
    [dvk-mx8m-bsb.kicad_pcb]
2018-07-30 Connected more signals of ethernet group to SOM.
    [dvk-mx8m-bsb.kicad_pcb]
2018-07-30 Use MHF4 instead of U.FL connectors on the WiFi+BT antennae
    [dvk-mx8m-bsb.kicad_pcb, dvk-mx8m-bsb_bom.csv, dvk-mx8m-bsb_bom.ods, wifi_bt_m2.sch, wwan_mpcie.sch]
2018-07-30 Fit the new MHF4 footprint and antenna feedline together using the new footprint's dimensions
    The MHF4 spec sheet gives dimensions for a 50Ohm CPW coming from it, however this feedline is actually a microstrip line and therefore it should follow our specific width requirements (using our relative permittivity and top-to-bottom spacing). The width of the feedline will need to be adjusted once the permittivity between the top and bottom layer with the inner layers being void is given/known (at ~3GHz).
    [dvk-mx8m-bsb.kicad_pcb]
2018-07-31 Add stitching vias around the WiFi+BT antennae on the top-right section of the board, the vias form a fence-like structure and prevent interference in both directions
    The rest of the path still needs to be stitched (around the GNSS antenna), and wrap around next to the earpiece speaker, which needed to be shifted slightly to the left. Once the proper via locations are determined between the speaker and the GNSS antenna area, the speaker can try to be placed as-close-as-possible to the horizontal-center of the board (at X=105mm).
    [dvk-mx8m-bsb.kicad_pcb]
2018-07-31 Routing of CLK02 signal (among others) from ethernet PHY to SOM. As this signal can carry a 25MHz square wave, a guard ring connected to GND was added.
    [dvk-mx8m-bsb.kicad_pcb]
2018-07-31 Placement and routing of Light/IMU sensors group.
    [dvk-mx8m-bsb.kicad_pcb]
2018-07-31 Route signals PROX_INT and IMU close to SOM.
    [dvk-mx8m-bsb.kicad_pcb]
2018-07-31 Routed signals I2C3_SDA, I2C3_SCL, IRQ_PROX, IRQ_IMU completey to the SOM. To be fixed: Accidently moved vias near U301 (by dragging/shoving other signal).
    [dvk-mx8m-bsb.kicad_pcb]
2018-07-31 Fence in the rest of the GNSS antenna area and fix the VBUS via array near the charge controller (now locked)
    [dvk-mx8m-bsb.kicad_pcb]
2018-08-01 Complete the HDMI circuit routing (including the pull-down NFETs and the diff pairs going to them)
    The diff pairs going to the NFETs are exactly matched to 0 with their phase/skew; 1V8P still needs to be brought to them.
    [audio.sch, dvk-mx8m-bsb.kicad_pcb]
2018-08-01 Update the antennae footprints and feedline layout dimensions using the new stackup and relative permittivity given by the manufacturer, cut off the top corner of the speaker's pad #2 in order to mak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
    The GNSS CPW will likely be double checked by the manufacturer soon.
    [dvk-mx8m-bsb.kicad_pcb]
2018-08-01 RJ45-Connector wired with diff pairs.
    [dvk-mx8m-bsb.kicad_pcb]
2018-08-01 Fixed (small) design rule violations.
    [dvk-mx8m-bsb.kicad_pcb]
2018-08-01 Placment and routing of glue logic for miniPCIE modem card.
    [dvk-mx8m-bsb.kicad_pcb]
2018-08-01 Connected audio path modem card -> SOM (4 PCM signals).
    [dvk-mx8m-bsb.kicad_pcb]
2018-08-01 Add ANT-LTE-CER-T as the baseband modem antenna into the schematic and BoM, update the layout accordingly
    [dvk-mx8m-bsb.kicad_pcb, dvk-mx8m-bsb_bom.csv, dvk-mx8m-bsb_bom.ods, wwan_mpcie.sch]
2018-08-01 Clean up the ETH_RX*_P/N->RJ45 diff pair routing
    [dvk-mx8m-bsb.kicad_pcb]
2018-08-02 Route USB2 to the hub chip's upstream port and re-order & route each of the downstream ports to their respective locations (smartcard, mPCIe, & M.2), place and route the HDMI fuse, schottky diodes, T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
    The HDMI circuit should be complete now. The GNSS & WiFi+BT antennae should also be complete. The GNSS module's RX & TX lines need to be routed next.
    [dvk-mx8m-bsb.kicad_pcb, smartcard.sch, usb_hub_sdio.sch]
2018-08-02 Placed and wired auxiliary components (e. g. levelshifter) around mPCIE modem.
    [dvk-mx8m-bsb.kicad_pcb]
2018-08-02 Placment and routing of level shifters U1801 and 1802.
    Detected a confict between local net labels and hierarchical net labels
    which resulted in level shifter U1801 completely bridged.
    Renamed labels in schematic.
    [dvk-mx8m-bsb.kicad_pcb]
2018-08-02 Update the WWAN/BB antenna to use the Antenova SR4L034-R antenna
    [dvk-mx8m-bsb.kicad_pcb, dvk-mx8m-bsb.sch, dvk-mx8m-bsb_bom.csv, dvk-mx8m-bsb_bom.ods, wwan_mpcie.sch]
2018-08-02 Move the mPCIe slot and the associated circuit 0.5mm to the right in order to make room for the BB antenna
    [dvk-mx8m-bsb.kicad_pcb]
2018-08-03 Add pi-matching circuit to the baseband modem antenna's feedline
    The return path for the antenna may have to have a 6.8nH Murata LQG15HN inductor installed on it (cutting the ground trace shorting the pads). The BoM was updated with the new components and everything was reannotated and updated (page 2's caps were out of order).
    [audio.sch, battery.sch, boot.sch, buttons_led.sch, csi.sch, dsi.sch, dvk-mx8m-bsb.kicad_pcb, dvk-mx8m-bsb.sch]
2018-08-03 Begin laying out the WWAN/BB antenna footprint, including its feedline dimensions and clearance area, add 3D models for the push button and slide switch
    [dvk-mx8m-bsb.kicad_pcb]
2018-08-03 Update the micro-SIM slot footprint's keepout zone which was overlapping with the DSW2 pad and was generally the incorrect size/position
    The rest of the footprint still needs to be double checked after finding this error.
    [dvk-mx8m-bsb.kicad_pcb]
2018-08-03 Routed Wifi-SDIO and BT-RXD/TXD signals. Placed glue logic of M.2 card.
    [dvk-mx8m-bsb.kicad_pcb, wifi_bt_m2.sch]
2018-08-03 Wiring of (M.2)-I2C level shifters, M.2 bypass caps.
    [dvk-mx8m-bsb.kicad_pcb]
2018-08-03 Move the speaker's filter closer to the speaker, increase the speaker's trace widths to 0.8mm, do some minor adjustments to the USB diff pairs
    [dvk-mx8m-bsb.kicad_pcb]
2018-08-03 Double check and update the SF56S006V4BR2000 micro-SIM socket footprint
    [dvk-mx8m-bsb.kicad_pcb]
2018-08-04 Place and begin routing the camera, move the haptic motor to the "back" (side with the display) at a spot with its connector where there are no obstructions, move the slide switches to the "back-righ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
    [dvk-mx8m-bsb.kicad_pcb]
2018-08-04 Make the ETH PHY's crystal routing more symmetric
    [dvk-mx8m-bsb.kicad_pcb]
2018-08-04 Route the rest of the camera circuit, add meanders to the clock and D1 diff pairs so that the skew between the clock and data-lines is 0 (still need to do intra-pair skew/phase), add the pull-up resi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
    [dvk-mx8m-bsb.kicad_pcb]
2018-08-05 Route the haptic motor circuit
    [dvk-mx8m-bsb.kicad_pcb]
2018-08-05 Place and route the ON/OFF & volume buttons and their circuit
    [dvk-mx8m-bsb.kicad_pcb]
2018-08-06 Route the ONOFF net
    Unrouted count is now down to 543.
    [dvk-mx8m-bsb.kicad_pcb]
2018-08-06 Routing of various signal (HMDI_CEC, SD2_RST, SYS_RST, ONOFF, ..)
    [dvk-mx8m-bsb.kicad_pcb]
2018-08-06 Add via stitching fence around the baseband modem antenna and its feedline
    [dvk-mx8m-bsb.kicad_pcb]
2018-08-06 Begin routing the 3V3 buck converter circuit, make all SMD footprints defined as SMD footprints instead of THT
    [dvk-mx8m-bsb.kicad_pcb]
2018-08-07 Lay out the rest of the 3V3 and 3V3_P circuits, route the PWR_EN to the 3V3_P power switch IC, lay out & route the reset button's circuit
    [dvk-mx8m-bsb.kicad_pcb]
2018-08-07 Rotate the haptic motor in order to minimize its wires' proximity to the USB-C diff pairs on the back
    [dvk-mx8m-bsb.kicad_pcb]
2018-08-07 Bring 3V3 to the SYS_RST# button's (NC) pull-up
    [dvk-mx8m-bsb.kicad_pcb]
2018-08-07 Moved away traces that were erroneously led through a milled out area under the M.2 socket. Added keepout zone in the M.2 socket to prevent this in the future.
    [dvk-mx8m-bsb.kicad_pcb]
2018-08-07 Added flexible cable detail to display footprint. The outline was extracted from a technical drawing in pdf format, then edited with inkscape. With the python utitity "svg2mod" the drawing was import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
2018-08-07 Cable detail on display footprint was mirrored, fixed it.
2018-08-07 Update display footprint in layout file to make FPC detail visible.
2018-08-07 Fix a small formating mistake in the BoM and correct the DRC error in the layout (move the position of the DSI connector and the vias conflicting with it)
    [dvk-mx8m-bsb_bom.ods]
2018-08-08 Place and route the JTAG circuit, place and route the BOOT_MODE slide switch circuit, place and route the user-LED circuit, place and route the top-level sheet passive components (I2C2 pull-ups, 5V_S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
    Unrouted count is now 324. The power circuit and the display are what is now left to be placed on the board, a few nets currently on the board still need to be connected (~120). 3V3_SNVS and various other misc. power rails still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
    [dvk-mx8m-bsb_bom.csv, dvk-mx8m-bsb_bom.ods, wifi_bt_m2.sch, wwan_mpcie.sch]
2018-08-08 Make exact structure of FPC connectors (DSI and touch interface) visible on display footprint. Created by scanning the display and then editing the image with gimp and inkscape.
2018-08-08 Updated display footprint in board. Moved display to center of board (y=148,5). This makes access to the DSI FPC very easy, but causes trouble with microphone position.
2018-08-08 Outline of display moved to silkscreen layer to make it visible in 3d view.
2018-08-08 Update the layout to use the new display footprint.
2018-08-08 Move the microphone downward out of the way of the display and re-place and re-route the HDMI components and traces which become obstructed by this new microphone placement
2018-08-08 Make a few minor adjustments and re-route GND nets that were removed from the new display position
2018-08-08 Move traces away from the DSI connector in order to make room for its vias and tracks
2018-08-08 Add serpentine bends to the CSI traces in order to match their intra-pair skew and make it exactly 0
2018-08-08 Route all nets on the 3V3_OUT rail
2018-08-09 Layout & route the 5V_SOM boost converter circuit and begin laying out the 5V_P power swtich/rail circuit
2018-08-09 Routed MIPI-DSI signals (5 differential pair) Tuned for length (55 mm) and for skew/phase of each pair.
2018-08-10 Make a few improvements with the new camera CLKO1 buffer's position
2018-08-10 Correct a typo that was made on the SoM outline footprint's MH1 drill size (3.37mm instead of 3.73mm)
    EmCraft's baseboard is actually using imperial units so it's actually a 3.7084mm hole
2018-08-10 Place and route the DSI's decoupling capacitors
    Still need to route the rest of the power circuit, the touch controller connector, move the ambient light/proximity sensor to the top, and clean everything up more
2018-08-10 Begin routing the LCD display's 22.4V white LED backlight boost converter circuit
2018-08-10 Routing and placement of: * LDO 2.8 V * Buck converter 1.8V * Touch controller connector + level shifters * changes in layer In3.Cu to distribute supply voltages
2018-08-10 Re-lay out parts of the 1V8_P buck converter circuit to follow a recommended layout, move the 2V8_P LDO circuit away from under the camera and place it on the back side of the board (display side) wh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
2018-08-11 Re-route the USB hub + SD controller chip's DP0/DM0 as a 90Ohm diff pair which feeds back to the IC's DM/DP pins (17<->31 & 18<->32), re-route the WWAN and WLAN diff pairs after they were shoved in a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
    [usb_hub_sdio.sch]
2018-08-11 Increase the footprint size of C461 to 0603 and increase the value of R418 to 33k in order to be able to use common 1uF 0603 capacitors rated for 35V
    The worst-case OVP with R417 and R418 being rated at 1% is 34.96V which is still below the 35V rating. The output voltage is typically 22.4V which is well below the voltage rating. Therefore these capitors should never experience a voltage above what they are rated for.
    [dvk-mx8m-bsb_bom.ods, power.sch]
2018-08-11 Bring VBAT_REG to the 22V4_P regulator
2018-08-11 Increase the 22.4V LED backlight boost converter's output capacitor to 4.7uF, coarsely route the 22V4_P rail to the display
    [dvk-mx8m-bsb_bom.csv, dvk-mx8m-bsb_bom.ods, power.sch]
2018-08-12 Route LCD_LEDK to the display/DSI FPC connector
2018-08-12 Use fat copper pours to route the 22V4_P and LCD_LEDK nets to the display/DSI connector
2018-08-13 Moved proximity/light sensor to new position under the SIM socket. (Other position can also be discussed). Routed I2C3_SCL, I2C3_SDA and PROX_INT connectons.
2018-08-13 Routing of 1V8_P net on In3.Cu layer and some other power signals. Movement of other power nets to avoid crossing. Change of polygon shape to prevent that they break in pieces.
    Unrouted nets count is 60 (only capacitors outside board area).
    Proximity sensor could be moved to even better position.
2018-08-13 Use 5V_P as the inner plane AC-GND reference for the USB2 and USB smartcard diff pairs, move the C1821 electroyltic cap from the back side near the edge to the front under the SoM where there is spac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
2018-08-13 Move the speaker 1.2mm up and place the proximity/ambient light sensor just below the speaker
2018-08-14 Move the two tantalum capacitors which were on the "back" to the "front" side, make corrections to the battery holder footprint including a hole which was missing for plastic pillar dealy (3D model c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
    Only 8 more 5V_P bypass caps need to be placed and the unrouted count will be 0!
2018-08-14 Place and route the remaining 5V_P bypass caps which are spread throughout various spots on the board, get the unrouted count down to 0
    Now that the unrouted count is 0, it is time to clean up the entire layout; improving various routing such as separating the SIM card slot's CLK & data and making the USB hub+SD chip's crystal routing symnetric. After that, the BoM needs to be updated with the passive components' tolerances, capacitors' temperature & voltage ratings, and list recommended PNs which are shared with EmCraft's baseboard.
2018-08-14 Re-route the USB hub+SD chip's crystal circuit making it more symmetric, extend the length of the ETH PHY's XTLI trace going to the crystal in order to more closely match its length to the XTLO trace
2018-08-14 Add a 5.29x27.14mm Purism logo to the "back" silkscreen of the board, seen on the bottom left edge when facing the display, remove the old schematic rescue files which are remnants from the Kicad 5.0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
    [audio-2018-07-16-14-33-54.sch, audio-2018-07-16-17-35-05.sch, battery-2018-07-16-14-33-54.sch, battery-2018-07-16-17-35-05.sch, boot-2018-07-16-14-33-54.sch, boot-2018-07-16-17-35-05.sch, buttons_led-2018-07-16-14-33-54.sch, buttons_led-2018-07-16-17-35-05.sch]
2018-08-14 Increased distances of reduced gigabit media-independent interface (RGMII) signals in order to be able to adjust trace lengths.
2018-08-14 Rework length adjustment of SD card (one signal was too long). Changed width of RGMII traces to 0.127 mm. Removed unnecessary tiny segments/stubs.
2018-08-14 Make the ENET_* traces on the top layer 53mils in order to ensure they have a 50Ohm single-ended impedence, move one of the 5V_P bypass caps close to the SoM end of the USB2 diff pair, add meanders t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
    [audio.sch, battery.sch, boot.sch, buttons_led.sch, csi.sch, dsi.sch, dvk-mx8m-bsb.sch, ethernet.sch]
2018-08-15 Make a few more minor adjustments and export preliminary gerber files
    The gerbers will be re-exported frequenty from now until the final prototype files, after which point the revision will need to be incremented if further changes are made.
    [dvk-mx8m-bsb-B.Cu.gbr, dvk-mx8m-bsb-B.Mask.gbr, dvk-mx8m-bsb-B.Paste.gbr, dvk-mx8m-bsb-B.SilkS.gbr, dvk-mx8m-bsb-Edge.Cuts.gbr, dvk-mx8m-bsb-F.Cu.gbr, dvk-mx8m-bsb-F.Mask.gbr, dvk-mx8m-bsb-F.Paste.gbr]
2018-08-15 Add user-facing universal icons/symbols which will help the users identify common buttons/receptacles/sockes
2018-08-15 Move some of the reference designators on the silkscreen layers to more visible positions where possible, update the schematic, BoM, footprint, and layout to reflect the fact that the dual 2-input AN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
    The rest of the silkscreen designators still need to be placed in more visible/unobstructed locations. The BoM still needs to have tolerance & rating values enter for all passive components that will be supplied by the PCBA house.
    [dvk-mx8m-bsb_bom.csv, dvk-mx8m-bsb_bom.ods, wifi_bt_m2.sch]
2018-08-15 Move device designators on silkscreen layer to reasonable places where they are readable and not covered by obstacles. This was not possible on all areas of the F.Silk layer, because there exist four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
2018-08-15 Added a "layer indicator" (useful for handling in the board house) Currently placed under the mPCI card, but other locations possible.
2018-08-15 Make the rest of the silkscreen designators visible (some must be underneath the RJ45 and battery holder), add silkscreen which identifies the mPCIe and M.2 card slots
2018-08-16 Make the backlight boost converter compensation capacitor (C459) 10nF instead of 100nF (was a typo), make the charge controller's PMID capacitor (C302) 10uF instead of 8.2uF since it is a more common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
    [battery.sch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]
2018-08-16 Bring back the current version number (v0.1.0) on the back silkscreen by replacing the word "Preliminary" with it
2018-08-16 The signal CLK02 (clock supply for ethernet PHY) was surrounded with GND traces to form a shield against the static field (25 Mhz present). The same was done now with sigbal CLK01 (clock supply for c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
2018-08-16 Fixed an erroneous pin swapping in U402 (MIC2876). Corrected library entry. New placement and wiring for resistors near U402 in layout.
2018-08-16 Proposal for treatment of high accurracy resistor in BoM.
    [bom_relaxed_R_tolerances.ods]
2018-08-16 Make a few improvements to the 5V buck converter's layout after the pin number mistake was fixed
2018-08-16 Move some of the traces away from under the inductors (traces on layers In2.Cu and B.Cu)
2018-08-16 Update the BoM with all part numbers from the "purchasing" BoM in NextCloud, update all manufacturing-related files after the last few commits' changes (including new assembly & fabrication files as 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
    [bom_relaxed_R_tolerances.ods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]
2018-08-17 Update the fabrication drawing file with more information
    This file was created by exporting both the Cmts.User layer, as well as the NPTH&PTH drills into separate DXF files, then combining them in the footprint editor, finally, this new footprint made from both of these is imported into the layout and re-exported as a single DXF.
    [dvk-mx8m-bsb-drl_fabrication.dxf, dvk-mx8m-bsb-fabrication.dxf]
2018-08-18 Increase the trace width of the ETH PHY's AVDD33 net
2018-08-18 Tune WIFI_CLK to 50mm such that each data signal is <20ps (<3mm) skew from the clock
2018-08-18 Separate the smartcard CLK and IO lines a bit farther apart
    [smartcard.sch]
2018-08-18 Run the smartcard's IO trace on the top layer, away from the CLK line, the clock being surrounded by RST and SC1_C4 (unused)
2018-08-19 Add *.Fab outlines to each footprint
2018-08-19 Add reference designators to all footprints on the *.Fab layers
2018-08-19 Update the 1.8V inductor's footprint such that its solder mask does not have pointed ends and is a more uniform shape
2018-08-20 Increase various power-rated trace widths to being equal to the pad sizes they connect, make improvements to various power pin traces
2018-08-20 Correct the fabrication note 4 now stating "see supplementary pdf" instead of "detail A", add RoHS mark on F.Silk layer
    [dvk-mx8m-bsb_bom.ods]
2018-08-20 Update the manufacturing files after the last several commits
    [dvk-mx8m-bsb-B.Cu.gbr, dvk-mx8m-bsb-B.Fab.gbr, dvk-mx8m-bsb-B.Mask.gbr, dvk-mx8m-bsb-B.Paste.gbr, dvk-mx8m-bsb-B.SilkS.gbr, dvk-mx8m-bsb-Cmts.User.gbr, dvk-mx8m-bsb-Edge.Cuts.gbr, dvk-mx8m-bsb-F.Cu.gbr]
2018-08-20 Add silkscreen for the expected battery specs and the HKSs
2018-08-20 Increase the track sizes for the smartcard and SIM card's VCC pins
2018-08-21 Lock all footprints and add PTN36043's SOT1442 3D model
2018-08-21 Bring back some of the copper zone pad connection settings specific to a per-footprint basis, remove the solderpaste from the pi-matching circuits
    These settings were reset when all of the footprints were updated.
2018-08-21 Adjustments on layers F.Fab and B.Fab to improve legibility: - In case of a diode with diode symbol inside, the designator was moved outsided the component rectangle - In case of text crossing the re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
2018-08-21 Update the issue date in the rev blocks
    [dvk-mx8m-bsb.sch]
2018-08-21 Fix note 7 on Cmts.User (was cut off at the end)
2018-08-24 Export the "final" v0.1.0 prototype manufacturing files
    [dvk-mx8m-bsb-B.Cu.gbr, dvk-mx8m-bsb-B.Fab.gbr, dvk-mx8m-bsb-B.Mask.gbr, dvk-mx8m-bsb-B.Paste.gbr, dvk-mx8m-bsb-B.SilkS.gbr, dvk-mx8m-bsb-Cmts.User.gbr, dvk-mx8m-bsb-Edge.Cuts.gbr, dvk-mx8m-bsb-F.Cu.gbr]
2018-08-24 Increment the version number to v0.1.1 in order to prepare for any future changes, move the battery's current requirements on the silkscreen slightly to the left in order to make room for the thermis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
2018-08-26 Reduce the trace width of CLKO1 and CLKO2 on the inner layers to 0.127mm in order to keep their impedance at 50Ohms throughout their length, do the same for SD2_~RST & WIFI_WAKE, remove a pointless s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
    [dvk-mx8m-bsb.sch]
2018-09-05 Update the version number in the PDF schematics' rev block
2018-09-05 Make some small adjustments/improvements to the CLKO1, CLKO2, ENET_WoL, ENET_~INT, ENET_~RST, and USB1_SS_SEL routing and trace widths
2018-09-05 Update the CPW feedlines according to the manufacturer's new stackup, re-export all of the manufacturing files accordingly (using new v0.1.1 version number)
    [dvk-mx8m-bsb-B.Cu.gbr, dvk-mx8m-bsb-B.Fab.gbr, dvk-mx8m-bsb-B.Mask.gbr, dvk-mx8m-bsb-B.Paste.gbr, dvk-mx8m-bsb-B.SilkS.gbr, dvk-mx8m-bsb-Cmts.User.gbr, dvk-mx8m-bsb-Edge.Cuts.gbr, dvk-mx8m-bsb-F.Cu.gbr]
2018-09-12 Increment the version number to v0.1.2 and improve some parts of the routing, remove a pointless via found on Net-(D1701-Pad2) on a top layer track
    [dvk-mx8m-bsb.sch]
2018-09-14 Export the current v0.1.2 manufacturing files
    [dvk-mx8m-bsb-B.Cu.gbr, dvk-mx8m-bsb-B.Fab.gbr, dvk-mx8m-bsb-B.Mask.gbr, dvk-mx8m-bsb-B.Paste.gbr, dvk-mx8m-bsb-B.SilkS.gbr, dvk-mx8m-bsb-Cmts.User.gbr, dvk-mx8m-bsb-Edge.Cuts.gbr, dvk-mx8m-bsb-F.Cu.gbr]
2018-09-18 Specify that the license is "GNU GPLv3+"
    [dvk-mx8m-bsb.sch]
2018-09-20 Make pin 6 VDD for U1301 (single 2-input OR) and U1504 (single 2-input AND) instead of pin 5 (NC), swap pins 2 and 5 of U1803's (dual 2-input AND) schematic symbol (functionally insignificant, does n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
    The single 3-input OR gate had no issues.
    [buttons_led.sch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]
2018-09-20 Use CMC-2242PBL-A part number instead of CMR-2747PB-A on the BoM (as ordered and stated in the schematic)
    [dvk-mx8m-bsb_bom.ods]
2018-09-21 Swap ECSPI1_MOSI and ECSPI1_MISO
    [dvk-mx8m-bsb-B.Cu.gbr, dvk-mx8m-bsb-B.Fab.gbr, dvk-mx8m-bsb-B.Mask.gbr, dvk-mx8m-bsb-B.Paste.gbr, dvk-mx8m-bsb-B.SilkS.gbr, dvk-mx8m-bsb-Cmts.User.gbr, dvk-mx8m-bsb-Edge.Cuts.gbr, dvk-mx8m-bsb-F.Cu.gbr]
2018-09-21 Add SoM pinout spreadsheet comparing the dvk against EmCraft's baseboard pin functions
    [dvk-som-pinout.xlsx]
2018-09-21 Go through the rest of the pinouts in the spreadsheet and highlight the ones which are the same and have no errors in green
    [dvk-som-pinout.xlsx]
2018-09-22 Export the v0.1.2 manufacturing files
    [dvk-mx8m-bsb-B.Cu.gbr, dvk-mx8m-bsb-B.Fab.gbr, dvk-mx8m-bsb-B.Mask.gbr, dvk-mx8m-bsb-B.Paste.gbr, dvk-mx8m-bsb-B.SilkS.gbr, dvk-mx8m-bsb-Cmts.User.gbr, dvk-mx8m-bsb-Edge.Cuts.gbr, dvk-mx8m-bsb-F.Cu.gbr]
2018-09-22 Increment the version number for any new changes/fixes which are made (v0.1.3)
    [audio.sch, dvk-mx8m-bsb.sch, dvk-som-pinout.xlsx, jtag.sch]
2018-09-22 Increase the UIM-PWR via size near the SIM card socket, re-export all of the manufacturing files which this change affects (fabrication drawings and gerbers)
    [dvk-mx8m-bsb-B.Cu.gbr, dvk-mx8m-bsb-B.Fab.gbr, dvk-mx8m-bsb-B.Mask.gbr, dvk-mx8m-bsb-B.Paste.gbr, dvk-mx8m-bsb-B.SilkS.gbr, dvk-mx8m-bsb-Cmts.User.gbr, dvk-mx8m-bsb-Edge.Cuts.gbr, dvk-mx8m-bsb-F.Cu.gbr]
2018-09-24 Fix the Mini-HDMI pinout such that it correctly matches the standard
    Re-exported the gerber files (fabrication drawing will need to be reproduced too).
    [dvk-mx8m-bsb-B.Cu.gbr, dvk-mx8m-bsb-B.Fab.gbr, dvk-mx8m-bsb-B.Mask.gbr, dvk-mx8m-bsb-B.Paste.gbr, dvk-mx8m-bsb-B.SilkS.gbr, dvk-mx8m-bsb-Cmts.User.gbr, dvk-mx8m-bsb-Edge.Cuts.gbr, dvk-mx8m-bsb-F.Cu.gbr]
2018-09-25 Since MISO/MOSI are correct on the upcoming prototypes then there's no need to point out the old error in the pinout spreadsheet, remove this remark in the spreadsheet
    [dvk-som-pinout.xlsx]
2018-09-25 In the schematic comments specify that REG*12*[6:0] are used to set the max charging current
    [battery.sch]
2018-09-26 Re-export the manufacturing files after fixing the HDMI pinout
    [dvk-mx8m-bsb-B.Cu.gbr, dvk-mx8m-bsb-B.Fab.gbr, dvk-mx8m-bsb-B.Mask.gbr, dvk-mx8m-bsb-B.Paste.gbr, dvk-mx8m-bsb-B.SilkS.gbr, dvk-mx8m-bsb-Cmts.User.gbr, dvk-mx8m-bsb-Edge.Cuts.gbr, dvk-mx8m-bsb-F.Cu.gbr]
2018-09-26 Move FB1605's silkscreen reference designator out of the mPCIe mounting hole
    [dvk-mx8m-bsb-B.SilkS.gbr]
2018-10-02 Use the correct component definitions for C445, C443, and R413 in the BoM
    [dvk-mx8m-bsb_bom.ods]
2018-10-02 Make R412 10k in the BoM instead of NC
    [dvk-mx8m-bsb_bom.ods]
2018-10-02 Apply the last two commits to the CSV BoM
    [dvk-mx8m-bsb_bom.csv]
2018-10-04 Straighten out a couple of traces such that they don't have unnecessary bends
2018-10-05 Color the pins orange and dark-orange in the pinout spreadsheet for the pins which would critically conflict with EmCraft's basebaord device tree (resulting in an output connected to an output)
    [dvk-som-pinout.xlsx]
2018-10-06 Remove the paste from the "top" pin of C1504
2018-10-15 Bring the HDMI diff pair shield pins directly to GND instead of the 0Ohm resistor which goes to GND
    [audio.sch, hdmi.sch]
2018-10-17 Add MDT320E03001 M.2 Key E socket footprint and 3D model
2018-10-17 Use the new MDT320E03001 M.2 socket footprint in the layout, make the corresponding changes in the layout for this new footprint to work
    This M.2 socket is used instead of the previous one due to the M.2 module having components on the back which are as tall as 1.35mm.
    [wifi_bt_m2.sch]
2018-10-17 Update the BoM after the last change
    [dvk-mx8m-bsb_bom.csv, dvk-mx8m-bsb_bom.ods]
2018-10-17 Bring the SD controller's WP pin to GND
    The WP pin needs to be brought to ground for the write protect to not be enabled by the chip.
    [usb_hub_sdio.sch]
2018-10-18 Add a note in the schematics about the LCD using the Sitronix ST7703 display driver IC
    [dsi.sch]
2018-10-19 Remove a redundant 3V3_P via near the M.2 footprint which is no longer being used
2018-10-19 Specify the common name of the display manufacturer in the schematic notes
    [dsi.sch]
2018-10-19 Move the M.2 mounting hole down 2.025 according to Amphenol in order for it to line up with the 2230 card's mounting hole
2018-10-22 Use .ods format for the SoM pinout spreadsheet
    [dvk-som-pinout.ods, dvk-som-pinout.xlsx]
2018-10-24 TCPC_nINT is _not_ tied to CHRG_nINT so remove the schematic note that said they were
    [usb-c.sch]
2018-10-26 Update schematic comment to state "TUSB546A-DCI can be used for HDMI over USB-C"
    [hdmi.sch]
2018-10-26 Make the new M.2 footprint's value on the F.Fab layer invisible in the layout
2018-10-26 Update battery schematic sheet's notes
    [battery.sch]
2018-10-27 Specify in the schematic note that the OV5640 camera's 7-bit slave address is actually 0x3C (not 0x78 which is it's 8-bit write address with the LSB r/w bit set as 0)
    The OV5640's datasheet mistakenly says 0x78 for the SCCB slave address (it's supposed to say 0x3C). In binary representation it's 0111 110x, with x as the r/w bit.
    [csi.sch]
2018-10-28 Add a TXB0101 logic level translator to the LCD_RESET# signal, the VIH(max) if the LCD's reset pin is 1.8V so the voltage needs to be translated from 3.3V logic down to 1.8V logic
    The active TXB0101 level translator is used so that the pin can continue to be externally pulled low by a 10k resistor. The behavior of having this pin supplied with a logic level exceed its maximum rating is unpredictable (could be fine but could also act in unexpected ways). The TXB0101 is already used in the design as U1302, so now there will be 2x of these per board. This also requires two additional 0402 X5R 10V 100nF caps (already have 87 per board of CL05A104MP5NNNC / EmCraft PN: E-CAP-003-01, will now be 89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
    [dsi.sch, dvk-mx8m-bsb_bom.csv, dvk-mx8m-bsb_bom.ods, mipi.sch]
2018-10-31 Modify the antennas' feedlines for a 1.1mm nominal thickness board using a relat ive permittivity of 4.1~4.11
    The H parameter in the calculations was +0.21mm greater than the H used in the p
    rototype calculations (1.1mm thick board instead of 0.89mm thick)
    A DK value of 4.11 was used for the GNSS and WWAN antennae feedlines and a DK of 4.1 was used for the Wi-Fi/BT feedlines since the operating frequency of the GNSS and WWAN is generally a bit lower than Wi-Fi/BT.
    The NANYA NP-180TL spec sheet is also included. The specific prepreg/core/substrate/dielectric used is NANYA NP-180**TL** which has a DK specified as 4.1-4.3 @ 1GHz.
2018-10-31 Place a copyright notice on the silkscreen and re-lock all footprints & tracks
2018-11-01 Update the RTC's datasheet source and the note regarding VIH(min) when VDD=4.25V
    The highest VIH(min) it will get to is ~3.0V, which is completely fine.
    [rtc.sch]
2018-11-05 Correctly state 1.10mm as the nominal thickess of the board in the fabrication notes, make the wifi_bt_feed_janielectronics_microsctrip calculation screenshot show the most significant figure of the 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
2018-11-05 Add the same speaker trace width calculation screenshot from the prototypes to the final calculations directory (not different from the protos)
2018-11-05 Make the layer setup/3D render setting reflect the fact that the board should now have a 1.10mm nominal thickness
2019-05-21 In preperation for the final order, re-export all the manufacturing files using the current date and rev number v1.0.0
    Add the fab's stackup, panel array working files, and their CPW calculations
    [audio.sch, battery.sch, boot.sch, buttons_led.sch, csi.sch, dsi.sch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]
2020-05-23 Get rid of the false positive errors and warnings in the ERC and DRC
    Updated the note on camera's PWDN pin (13) to correctly say that it has an internal pull-up and not a pull-down. Removed the redundant via that was on top of an already existing identical one on the UIM-DATA net (located at X=83.736372, Y=104.553716).
    [audio.sch, battery.sch, boot.sch, buttons_led.sch, csi.sch, dsi.sch, dvk-mx8m-bsb.sch, ethernet.sch]
2020-10-17 Replaced 13 dead datasheet urls with a working ones.
    Checked datasheet urls in all *.sch files, found 13 dead and replaced them with a working ones.
    Four components are marked as obsolete either by manufacturer or distributor:
    MFG part number comment
    --------------- -------
    LMK107BJ475KA-T Non-preferred component for new designs.
    DB2J20900L Lifecycle (according to Mouser): obsolete. Datasheet no longer available on Panasonic website.
    FH26-39S-0.3SHW Component discontinued. Datasheet not available on Hirose website.
    SF56S006V4BR2000 Component pending obsolescence. Datasheet not availale on Jae website.
    List of replaced urls:
    ==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
    [audio.sch, battery.sch, csi.sch, dsi.sch, dvk-mx8m-bsb.sch, ethernet.sch, haptic.sch, hdmi.sch]
2020-11-22 Include 2.5mm pitch JST connector 3D model which was removed from the KiCad 3D library, export the .WRL 3D file of the board and the FreeCAD file generated from importing the model
    The 3D model files are contained within a .7z archive in order to minimize space required to clone the repo.
2024-10-11 Add ODB++ export from KiCad 8.99 nightly
